a2fpga/a2fpga_core/boards/a2p25/README.md

# A2P25 Card

This is the project version that builds the FPGA bitstream for the 
[Tang Primer 25K](https://wiki.sipeed.com/hardware/en/tang/tang-primer-25k/primer-25k.html)
version of the A2FPGA Apple II card.

Coming soon

## Documentation

- [Project documentation wiki](../../docs/README.md) — Gowin CLI setup, architecture, conventions, gotchas
- [Agent & contributor guide](../../AGENTS.md)
- [This board's tasks & status (TODO.md)](TODO.md)
- Board design docs:
  - [LCAM capture session notes](docs/LCAM_SESSION_NOTES.md)
  - [ESP32 SPI protocol](docs/ESP32_SPI_PROTOCOL.md)
  - [ESP32 firmware (a2fpga_esp32)](src/a2fpga_esp32/README.md)
