a2fpga/a2fpga_core/boards/a2mega/TODO.md

# A2Mega TODO

## Status

**Work In Progress** — Tang Mega 60K version. The a2n20v2-Enhanced feature set
(menu, SD disk serving, WiFi networking, FPGA self-update) is ported and
building; hardware bring-up of the new co-processor paths is next. See
[docs/ESP32_ENHANCED_PORT.md](docs/ESP32_ENHANCED_PORT.md).

## High Priority — bring-up of the Enhanced port (all code in place, untested on hardware)

- [ ] Verify the OSPI link end-to-end from the ESP32 (`+++` CLI: `spitest`, `spireg 7`)
- [ ] Verify SD card pins (`PIN_SD_D2`=IO35 inferred from schematic) and 4-bit SDMMC mount
- [ ] Verify USB HID gamepad readback regs (0x16-0x1B) and menu navigation
- [ ] Verify OSD text overlay rendering (`A2REG_VIDEO_ENABLE`, SPACE 1 writes;
      check glyph bit order — flip `row_byte_r[subcnt_r[3:1]]` indexing if mirrored)
- [ ] Verify Disk II track serving (SPACE 4 windows) and HDD block serving (SPACE 5)
- [ ] Verify Apple II reset hold/release polarity through the 74LVC2G06 (a2_res_out_n)
- [ ] Verify W5100 MACRAW bridge + WiFi MAC NAT against IP65/Contiki
- [ ] Verify GW5A JTAG self-update path (IDCODE probe first — reg constants
      mirrored from openFPGALoader's GW5A support, not yet run on silicon)
- [x] DDR3 reset sequencer + calibration watchdog (79f4afc1): rst_n was
      tied high (one unsequenced calibration shot, no retry — the
      intermittent dead-DDR3 cold boots). Sequencer holds reset through
      PLL lock + 1 ms, 100 ms watchdog retries indefinitely; retries in
      reg 0x23, state in 0x24; boot warning + `status` line in firmware.
      ⚠️ any a2spi_* call outside the CLI/tasks MUST hold fpga_link_lock()
      and ideally run before task creation — unlocked boot-path reads
      boot-looped the ESP32 (IDF spi_device_transmit assert).
- [x] Wire the DDR3 IP's pll_stop via mDRP (a302d566): WAS the root cause
      of marginal calibration (IPUG281 §4.4.4 — Sync_mod must stop
      memory_clk to phase-align the /4 dividers; ours was a silent no-op,
      cold boots aligned by GSR luck). Raw PLLA wrapper (PLL_INIT was IDE
      boilerplate that permanently owned the mDRP bus), refdesign glue,
      pll_mDRP_intf enabled. Verified: forced re-inits (reg 0x25 write)
      converge back to calibrated, 0-1 watchdog retries each — re-init
      was guaranteed-fail before this.
- [ ] Track DDR3 retry counter during testing; correlate nonzero counts
      with gamepad presence/rumble (user's supply-sag hypothesis).

## Bring-up status (2026-07-05 live IIgs session)

**WORKING on real hardware**: FPGA core (REG-mode DDR3 calibrates, video
clean), OSPI link (at 2 MHz + workarounds below), OSD console rendering,
SD disk serving — **ProDOS 8 boots from a .dsk over the link**, WiFi
joins + DHCP, boot-time slot config, reset policy.

**Gamepad + menu (2026-07-12, commit aa897c81)**: 8BitDo SN30 Pro
enumerates on the fabric usb_hid_host, input reports stream, menu
navigates via pad, rumble/LED init lands. Four stacked root causes fixed
(empty $readmemh microcode ROM → inlined .vh; D+/D− pin swap vs the dock
reference — carrier truth is D+=G13/D−=H13 per sch p.3+p.5; SLEW_RATE=
SLOW corrupted the 12 Mbps TX; SN30 needs the Enhanced-proven init
sequence with LED/rumble on EP1 OUT, now in the UKP ROM — source
vendored at hdl/usb_hid_host/ukp.s, regen: `python3 asukp.py ukp.s`).
NOTE: HID SET_IDLE/SET_PROTOCOL/report-descriptor path deleted from the
microcode for ROM space — USB keyboards/mice unsupported on this port
until re-slimmed. USB debug regs (permanent): 0x79/0x7B line-state +
UKP PC, 0x1C-0x1F + 0x7C-0x7D enum VID/PID/class, 0x20-0x22 core flags
+ transaction/data counters.
OSD repaint glitch FIXED (58ac8201): console scroll-on-newline ate the
title bar when the menu painted a full-width bottom row; fpga_screen now
does VT100-style deferred wrap.

Fixed later the same day (commit 3ed97d1): proto-proc stale-read + OSPI
sync-skew flashed (link clean at 4 MHz, shim removed), CLI mutexed,
fpgaupdate takes .bin, flash.sh hardened (--verify/retries/procedure).

Open issues, in priority order:

- [ ] SHR VERDICT (2026-07-10 live session, Spy Hunter static splash
      clean and stable): the SHR garble was vgc_gen's never-stall word
      swap — a semantic change imported with the a2n20v2 direct_display
      redesign — emitting STALE words when DDR3 fetches missed the
      16-pixel window and phase-slipping the rest of the line. FIXED:
      stall-on-late-word restored (active low during the stall; the
      framebuffer_writer pauses cleanly; BSRAM boards never stall), plus
      a vgc next-group prefetch in apple_memory (odd-word arming) and a
      pipelined issue path for clk_logic timing. REMAINING: stalls/frame
      still saturate 255 during SHR (prefetch mostly not winning —
      investigate pf idle-slot availability vs vid dummy churn);
      invisible now but margin-reducing. MOTION-SHR untested (needs
      menu/gamepad to mount GS game images — the standing gate)
- [ ] WiFi 2x2 VERDICT (2026-07-11, test router "edhomelab" @-33):
      RX-takeover EXONERATED (on/off statistically identical — W5100
      bridge re-enabled at no cost). Clean AP eliminates ALL loss
      (0% every bucket; UniFi near AP adds real loss+latency on top —
      user to investigate that AP separately). Residual: ~150-280ms
      mean RTT / ~12KB/s FTP in the common mode, with a PROVEN 3-9ms
      mode (sustained once; floors of 2.6-6ms seen daily) — bistable
      radio/driver behavior surviving elimination of takeover, IIgs
      power, disk/menu workload, PS, rates. Next tools: monitor-mode
      channel sniffer, in-firmware RTT profiling, audit w5100_poll's
      continuous OSPI duty (not covered by wifitest quiesce).
      Acceptable for current uses (disk serving OSPI-side; FTP works).
- [ ] (superseded) WiFi INVESTIGATION (2026-07-11 — verdict RETRACTED
      twice, now confounded): the "RF path" conclusion was premature.
      One PRISTINE measurement exists: 9ms avg / 0% loss sustained,
      with the RX-takeover DISABLED via the FAR UniFi AP (RSSI -83!) —
      proving the module can do healthy WiFi. But takeover-off via the
      NEAR AP (-46) was sick again (~600-900ms), so the takeover A/B is
      confounded with AP selection: every bad measurement is consistent
      with the NEAR AP being the disease. NEXT: dedicated non-UniFi
      2.4GHz test router placed next to the ESP32 (arriving 2026-07-11)
      → run the 2x2: {takeover on/off} x {test router} to separate our
      wifi_bridge RX-callback takeover from AP-side pathology.
      CURRENT BUILD STATE: takeover DISABLED (diagnostic) — W5100/
      Uthernet bridge is INERT until this resolves; FTP/net services
      unaffected. The a2p25 streamed 128kbps via stock Arduino WiFi on
      a similar board — whichever way the 2x2 lands, that path exists.
- [ ] (retracted) WiFi VERDICT (2026-07-10 session close): the pathology follows the
      BOARD, not the network — identical/worse on edhome, edhome-iot-3
      (all toggles stock), AND an iPhone hotspot (87-100% loss). With
      every client knob and AP setting eliminated, the remaining cause
      is the a2mega's RF path: the ESP32-S3-MINI PCB antenna in its
      board environment sustains management-rate traffic (association
      looks "excellent") but not data conversation. HW mitigations to
      evaluate: ESP32-S3-MINI-1U variant (U.FL external antenna) on a
      board rev; module placement/keepout audit vs the OSPI bus and
      slot copper; accept as-is for low-rate uses (disk serving works;
      FTP is slow but functional at close range/good moments).
      Note: the W5100-over-WiFi bridge shares this ceiling.
- [ ] (superseded ledger) WiFi performance (extensively characterized —
      CLI instruments: net/wifitest/wifiproto + rx/disconnect counters):
      bimodal fly-or-wait latency — RTT floor 3-11ms proves the path,
      but most packets wait 0.5-2.5s; ~10% loss; ~2.7KB/s FTP.
      ELIMINATED: power save (PS_NONE confirmed via readback — fixing it
      cured the original 100% inbound loss), 802.11n/MCS rates (bg-only
      identical), client 11k/v scanning (disabled in core), guest/
      isolation, DTIM lock + force-WiFi4 (reverted), dual-interface
      artifact, board workload (quiesce = 2x better, not the core),
      IIgs RFI (off = same). REMAINING: channel-6 lock (last user
      toggle — revert to auto), 2.4GHz channel utilization at the AP
      (read UniFi's metric), AP-side buffering toward this client,
      SSID/VLAN mapping of edhome-iot-3 (wired-path blackhole was
      observed transiently — verify network assignment), or return to
      edhome with band steering off as clean baseline
- [x] FLASH REPAIRED (2026-07-10): root cause of all flash-write failures
      was openFPGALoader's flash phase defaulting to 10 MHz through the
      ESP32 JTAG bridge — 500 kHz works. Recovery recipe in docs/gotchas.md
      (`--freq 500000 --bulk-erase`, replug, normal flash.sh). Board boots
      from flash again; power cycles safe
- [ ] Bit-bang GW5A SPI-flash path (fpgaupdate/fpgaflash/fpgaerase CLI)
      not silicon-validated: SPI status reads return busy/0xFF in both
      normal and keepsram entry modes — debug against openFPGALoader's
      working 500 kHz sequence before trusting the menu FPGA-update flow
- [ ] (was) FLASH REPAIR PENDING: config flash holds a half-written image
      (interrupted openFPGALoader write); board runs from SRAM — power
      loss needs a re-SRAM-load. openFPGALoader writes lose to the
      config-retry loop; repair via ESP32 bit-bang fpgaupdate (menu) or
      SRAM-load-then-flash in a fresh power window
- [ ] Old "sparkle"/garble notes (superseded by the above): (2026-07-10 live session):
      apple_video_gen and vgc_gen are hard-real-time single-word-prefetch
      consumers; a shadow read that misses its ~500ns slot makes the pixel
      shifter reuse the PREVIOUS word (stale chunk). Occasional misses =
      moving misplaced pixels on static screens (worst during disk-load
      write streams); chronic misses (2 clients on one port during SHR) =
      wholesale shape garble. No counter fires — data is correct, merely
      late. FIX SHIPPED: shadow read to priority 0 (latency-critical; all
      other clients are FIFO/line-buffered), shadow write to 1, FB 2/3;
      hidden-renderer fetches complete immediately with dummy data during
      SHR (wedge-safe, zero port traffic). RESIDUAL RISK: DRAM auto-refresh
      (~350ns per 7.8us) + in-flight FB burst can still exceed the word
      budget at low rate — if sparkle persists, deepen renderer prefetch
      to 2 words (measure via viddbg + photos first)
- [ ] Display sticks in SHR after the TransWarp GS power-up splash (reset
      recovers) — ROOT CAUSE from main PR #46 (hardware-validated on a
      IIgs+TWGS): read-FSM swallowed fetch pulses (vgc_active_i gating +
      busy-FSM drops with both generators fetching), wedging a generator
      until reset; the shared framebuffer then freezes on the splash.
      FIX PORTED: per-client request latches, classify by client+latched
      address, a request once latched always completes. VERIFY on hw;
      `viddbg` regs 0x70-0x77 confirm (C029 count, SHRG/use_vgc, rd FSM)
- [ ] Cold-boot polish from PR #46 worth porting later: seed the shadow
      text page with 0xA0 at first reset release (DDR3 noise until the
      ROM clears it; OSD console masks it today), and require two writer
      vsyncs before unblanking the FB after reset release
- [ ] SHR and hires rendering scrambled (text clean → scanout OK).
      HIRES root cause FOUND + FIXED: format_hires_data assembled
      {main,aux,main,aux} but the shared apple_video_gen contract is
      interleave_mux = {aux,MAIN,aux,MAIN} — every hires fetch fed the
      renderer aux-bank bytes (stable scramble, matches symptom). SHR
      mapping verified byte-identical to the working GS board; if SHR is
      still scrambled after the fix, suspect m2b0/E1 write routing or
      LINEARIZE-vs-write ordering — read `viddbg` stickies live
- [ ] XFER payload reads outrun the proto's 1-byte read pipeline above
      ~4 MHz (FF fill; reg path is clean at 8 MHz) — add a small
      fabric-side read prefetch to raise the link clock
- [ ] Runtime slot remapping breaks the moved card's I/O (boot-time map
      works; after SLOT_SELECT/CARD/RECONFIG the card's ROM reads work
      but the drive never serves data — repro: remap DiskII to slot 4/6,
      PR#n hangs with motor on, zero sectors)
- [ ] DOS 3.3 master image (dos_3.3.dsk) crashes deterministically at
      00/1FBA with RAMRD/ALTZP flipped in Q — ProDOS boots fine, track
      content verified byte-identical to reference GCR, sector 0 + 7 more
      sectors load correctly; likely image/IIgs interplay (try
      dos33_fixed.dsk); park unless it reproduces with known-good images
- [ ] SD 4-bit mount fails ("corrupted data after increasing clock
      frequency"), 1-bit works — audit PIN_SD_D1/D2/D3 against the board
      (D2=IO35 was inferred, not confirmed)
- [ ] SD mount is boot-time-only — retry on card-detect (IO46)
- [ ] Arduino/IDF logging: ESP_LOGI is compiled out by the precompiled
      core — use printf (or Serial) for anything that must be visible
- [ ] Restore the per-track serve-log dedup in disk.c once boot serving
      is settled (currently logs every serve for bring-up)

## DDR3 / BSRAM roadmap (from the 2026-07 fresh-eyes review)

Done: DDR3 controller MC buffers → registers (BSRAM 118→102); wrap-safe
hdmi_cy CDC; reset-deassert synchronizers; response-FIFO overflow guard;
burst-alignment assert. Open, in recommended order:

- [ ] Bench-verify the REG-mode controller + CDC hardening with the TEXT40
      soak test (the rippling-band reproducer) — required before trusting
      any of the DDR3-path changes
- [ ] C4: round-robin arbitration below the two framebuffer ports — the
      static-priority arbiter has no fairness bound for ports 2-5; this is
      the gate for adding ANY new DDR3 client
- [ ] DOC-on-ESP32 over the PPO bus (see the a2p25 postmortem): FPGA
      timestamps every $C03C-$C03F snoop against a 7M-locked counter and
      streams events over the idle PPO lines (LCD_CAM-shaped, 8 data +
      PCLK + SYNC); ESP32 runs the ES5503 model in DOC cycles. Frees ~28
      BSRAMs net. Make-or-break: event-loss hardening (FPGA event FIFO,
      seq+CRC, OSPI credit flow control, snooped-read-data resync).
      Fallback if it stalls: DOC-side prefetch converts the 838 ns fetch
      deadline to ~30 us, which DDR3 meets — wavetable to DDR3 without
      touching the DOC engine's real-time core
- [ ] Disk track windows → DDR3 after C4 lands (−6 BSRAM net of CDC cost;
      nibble cadence is ~32 us, hugely latency-tolerant)
- [ ] Uthernet II buffer aliasing (−3…−6) — first verify what RMSR/TMSR
      splits IP65/Contiki-class MACRAW drivers actually program

## Medium Priority

- [ ] Wire MCU scratch regs (0x06, 0x0C-0x0F) to DebugOverlay slots for bring-up
- [ ] Bluetooth HID gamepads/keyboards via the ESP32 (feed the same pad regs)
- [ ] Keyboard passthrough (FPGA usb_hid_host key regs → Apple II keyboard)
- [ ] Enable configuration through a web-based UX (ESP32 WiFi) alongside the OSD
- [ ] Investigate using the PPO interface to treat the FPGA as an LCD display
- [ ] Investigate implementing IIgs acceleration (similar to Transwarp GS)

## Low Priority / Future

- [ ] ESP32 firmware OTA update from the SD card
- [ ] Gamepad → Apple II paddle/joystick emulation (not in Enhanced either)

## Architecture Notes

- Uses ESP32-S3-MINI-1-N8 for control/configuration instead of internal PicoSoC
- OSPI (8-bit parallel) interface between ESP32 and FPGA — register map in
  [docs/ESP32_OSPI_DESIGN.md](docs/ESP32_OSPI_DESIGN.md), Enhanced-port additions in
  [docs/ESP32_ENHANCED_PORT.md](docs/ESP32_ENHANCED_PORT.md)
- USB-A port is wired to the FPGA (usb_hid_host core), not the ESP32;
  micro-SD, WiFi, and JTAG-to-FPGA are on the ESP32
- Disk track/HDD block buffers are BSRAM (XFER SPACE 4/5), not DDR3
- ⚠️ **BSRAM is at the device limit.** New BSRAM consumers must reclaim first.
  The Ensoniq 64KB wavetable (32 BSRAMs) is NOT trivially movable to DDR3 —
  the DOC's ~838 ns per-fetch deadline loses to DDR3 tail latency (that's why
  it's in BSRAM). Candidate reclaims: Uthernet II buffer aliasing (−3…−6,
  verify driver RMSR/TMSR use first); DOC arbiter-priority preemption is an
  unproven research option

## Build Status

- FPGA + ESP32 firmware (arduino-cli) both build from this tree; see git log
