a2fpga/a2fpga_core/boards/a2n20v1/TODO.md

# A2N20v1 TODO

## Status

**Deprecated** - This board support package is provided for reference purposes. It should continue to build but is planned for retirement.

## Maintenance Tasks

- [ ] Keep in sync with critical bug fixes from a2n20v2
- [ ] Verify build still works when making shared HDL changes
- [ ] Consider archiving if no active users remain

## Limitations

- Does NOT support Apple IIgs (64-pin CPLD cannot capture M2SEL/M2B0 signals)
- Only supports Apple II and //e models
- Superseded by a2n20v2 which uses 100-pin CPLD

## Build Status

- Last verified build: Unknown
- Recommend verifying build after shared HDL changes
