a2fpga/a2fpga_core/boards/a2n9/TODO.md

# A2N9 TODO

## Status

**Deprecated** - This board support package is provided for reference purposes. It should continue to build but is planned for retirement.

## Maintenance Tasks

- [ ] Keep in sync with critical bug fixes from other boards
- [ ] Verify build still works when making shared HDL changes
- [ ] Consider archiving if no active users remain

## Limitations

- Does NOT support Apple IIgs
- Only supports Apple II and //e models
- Uses discrete 74* series logic for bus interface (vs CPLD in other versions)
- Tang Nano 9K has limited resources compared to 20K

## Build Status

- Last verified build: Unknown
- Recommend verifying build after shared HDL changes
