a2fpga/a2fpga_core/(threads)

Thread 9 (2024-04-28):

CPLD

DFL1973, 2024-04-28:
Is the CPLD code available?

buserror, 2024-04-28:
No, I asked on slack. No board or CPLD, so this is basically a closed source project, it's a shame really. I don't see why anyone would contribute PR's to a project like this, unless perhaps they get a share of the profits from selling cards? Dunno, not sure what was the point.
When you see the insane communities and drive behind projects like PiStorm or Fujinet, makes you wonder.

edanuff, 2024-04-28:
Hi folks, the A2FPGA core is fully open source and it's easy to use it with boards of your own design.  If you look in the [A2N9 board code](https://github.com/a2fpga/a2fpga_core/tree/main/boards/a2n9), you can see a build of A2FPGA that doesn't depend on the CPLD at all as well as the schematics for the A2N9 board.  The A2N20 board is not open source, so it's not possible at this time for people to manufacture that card themselves but if someone wanted to do the work, they could very easily either use the A2N9 code and schematics as a starting point or use the A2N20 schematics and write their own CPLD code.  The CPLD is fairly trivial in what it does.

For example, here's a picture of development where it's all running on a breadboard with no CPLD at all, just using the code in this repo:

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

Closed 2024-05-01.

Thread 10 (2024-05-01):

DMA/INT OUT/IN

marketideas, 2024-05-01:
Looking at the schematic, it doesn't look like DMA_OUT is tied to DMA_IN and same for INT_IN/OUT.  This breaks the rudimentary daisy chain if the card is put in any slot except slot 7.  Is there a design reason, and perhaps this should be documented so that folks know that any card(s) in higher slots may not work reliably with DMA and/or interupts.

edanuff, 2024-05-01:
Hello, that's correct, the current boards don't support daisy chaining. We'll be documenting this and adding it to a later revision.

Closed 2024-05-01.

Thread 11 (2024-06-02):

mb-audit

DFL1973, 2024-06-02:
Is the emulated mockingboard passing on the mb-audit tests?
https://github.com/tomcw/mb-audit

jewettg, 2024-11-30:
I updated my A2N20 with the latest release:  `a2n20v2-10-12-2024-MB4.fs`.  Here is the successful output from the reprogramming.    I then ran the latest undead from disk image, and it would not detect the Mockingboard.   Is there something else I need to do?

Is there a good way to test MB functionality?  Debug methods?   I am going to see if I can find other disk images to help me test or see if this is working outside of Undead.

```
❯ openfpgaloader -b tangnano20k -f a2n20v2-10-12-2024-MB4.fs
empty
write to flash
Jtag frequency : requested 6.00MHz   -> real 6.00MHz
Parse file Parse a2n20v2-10-12-2024-MB4.fs:
Done
DONE
after program flash: displayReadReg 00006020
	Memory Erase
	Done Final
	Security Final
Erase SRAM DONE
Jtag probe limited to %d MHz6000000
Jtag frequency : requested 10.00MHz  -> real 6.00MHz
Detected: Winbond W25Q64 128 sectors size: 64Mb
Detected: Winbond W25Q64 128 sectors size: 64Mb
RDSR : 00
WIP  : 0
WEL  : 0
BP   : 0
TB   : 0
SRWD : 0
00000000 00000000 00000000 00
Erasing: [==================================================] 100.00%
Done
Writing: [==================================================] 100.00%
Done
```

edanuff, 2024-12-01:
The mockingboard does not currently pass mbaudit tests.  We're still working on figuring out why.

jewettg, 2024-12-01:
**I do want to apologize.**  After reading more documentation, I found I had to disable the mouse support (by marking slot 4 as "Your Card") on the Apple //gs.   All is well and Mocking board is detected and working!  It was even detected and working with other software as well!

edanuff, 2024-12-11:
#22

jewettg, 2024-12-12:
AWESOME!!   Thank you!   Will try it out soon!

edanuff, 2024-12-12:
There will be a new release this weekend

Closed 2024-12-11.

Thread 12 (2024-06-28):

Mouse

SalvadorCastello, 2024-06-28:
Do you think you can add Mouse support to the firmware?
To act as an Apple Mouse card, those cards are difficult to find.

Thanks

edanuff, 2024-08-30:
Not on the current version of the card since the USB port is device only for connecting to a PC.  We intend to do a future version that has a second USB host port that could be used for a mouse.

JustDre, 2024-08-30:
Although I haven't tried this just yet, there is a project by the author of snestang that allows the USB port to act as a host https://github.com/nand2mario/usb_hid_host

edanuff, 2024-08-30:
Yes, going to use something similar. The current board design has all the physical pins assigned right now although there are some workarounds for that.

Closed 2024-08-30.

Thread 25 (2025-05-02):

Hires graphics with 80 col active bot woriing

samccormack, 2025-05-02:
If hires graphics mode is activated while in 80 column mode the card gets confused and dispkays corrupted 40 column text characters in the graphics area. I have reproduced this on my rom 1 and rom 3 apple iigs machines. Exiting 80 column mode makes the graphics appear correctly.

To reproduce simply go into 80 column mode with pr#3 then enter hires graphics mode with hgr and the graphics area of the screen will fill with 40 column @ characters. Toggle back into 40 column mode either with ESC 4 or ESC CTRL-Q and the graphics will display correctly.

edanuff, 2025-05-02:
Let me take a look

Thread 26 (2025-06-12):

Graphic and character artifacts with A2FPGA

notwork-2000, 2025-06-12:
I get random characters or graphics that show up with the A2FPGA, that has the Video Only firmware on my Apple IIgs Rom1.  Could be extra characters on the boot screen, or artifacts in a game.  Only when going out HDMI from the A2FPGA.  RGB or Composite out do have have these artifacts.

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

notwork-2000, 2025-06-12:
A2FPGA in Slot 3, no boards in slots 1,2,4,5,6,7.  RAM2GS II (GW4201D) in the memory slot.  Fujinet plugged into Smartport.
A2FPGA Switch 1-4 are all on.
System configuration/slot configuration is defaults.
Thank you!

marketideas, 2025-07-12:
I rolled back to A2N20V2-FIRMWARE-08-17-2024_VIDEO_ONLY, and the problem has gone away (same machine, same hardware, etc).  So I won't spend my time looking into hardware issues, but will start comparing new releases to the old, and see if the clock routing has changed.

notwork-2000, 2025-07-12:
Thank you for adding insight into this.

Guess I now wish I hadn't gave up and returned the card as I was told it couldn't be reproduced and it was a local issue (was told power supply, home power quality, etc, I could tell it wasn't going to be an easy road to a solution).

Looks like I could have tried simply downgrading the firmware.  Didn't think to do that, all I tried firmware wise was reflash the same latest version with video only.  I assumed it was a firmware issue and offered to debug and troubleshoot.  Oh well.

Am actually quite happy with an RGB SCART cable to an RT4K, and don't miss the boot delay and as a bonus even get to hear the IIGS boot sound.

Finally, it's probably safe to assume this wouldn't solve my other issue where it would not work reliably through a TESmart 16x1 HDMI switch, where so many other devices I have work fine.

Live and learn.

jnorrid, 2025-07-12:
> I haven't been using my A2FPGA for awhile, but with Ensonic over HDMI support, I thought I might get back to it. Updated firmware to the 'enhanced' version, and started seeing 80-col random characters all over the screen. I don't have photos yet, as I continue to investigate. I have tried several different things, built my own bitstream, used the canned bitstreams, all doing the same thing. This is a ROM1 with the A2FPGA in slot 3. I have a ROM3 motherboard that I am going to try next. My gut is that the M2B0 signal is either weak (drive strength/voltage), there is a timing issue (a compile issues a warning about the clk_d signal, or the GLU CPLD is blown somehow...logic analyzer next. Let's keep this closed for now, and as I gain more info, we can see if we can't figure it out...but it looks like the same issue as the OP.

Greetings marketideas. The enhanced source tree and build contained in the repo is currently experimental at this stage. We have been working on it quite a bit lately and definitely encourage testing, but it is not a "production" build yet. The default configuration in the Top.sv file for this build enables all of the adapter cards currently implemented for a2fpga. SSC in slot 2, Mockingboard in Slot 4, Synetix SuperSprite in Slot 7 in addition to the HD video output, Apple II audio output, and Ensoniq audio output over HDMI for GS users. We were unable to reproduce the problem reported by the OP of this thread on any of our GS systems or the separate problem reported by the OP regarding use of TESmart 16x1 switch (we do not have one of these switches, and it is impossible to support every possible piece of equipment that could possibly reside between the A2FPGA and a display device, however, we have successfully tested with a 16-Port MT-VIKI 16 port 4K HDMI KVM purchased on Amazon in the US with no issues).

**We believe what you have reported above is most likely a completely unrelated problem than that reported by the OP.** Typically, the problems we have seen GS users encounter are related to power supplies delivering insufficient or inconsistent voltage/current due to age/use, card configuration conflict where physical boards reside in slots used by A2FPGA to implement SSC, MB, SuperSprite, or incorrect / misaligned configuration settings in the Apple II GS control panel for a user's configuration. Would really like to help you get to the bottom of this or figure out how we might be able to successfully reproduce the problem you are running into on our end. To help facilitate this, could you please answer / provide the following:

1. On your ROM 01 GS, what is the slot by slot configuration and Apple II GS control panel setting for each slot?
2. Have you upgraded/enhanced your Apple II GS power supply or is it the original equipment?
3. If you have any photos of the 80-col random characters on the screen, could you please provide those?
4.  When producing your custom firmware build using the enhanced source, did you modify the Top.sv file and disable anything that could potentially conflict with your configuration prior to executing a Build-All and programming the Tang-20K FPGA with the Gowin toolchain?

Thanks!

marketideas, 2025-07-12:
I'll try to answer these questions by going through the steps that got me here.
1) Downloaded, the latest main repo.
2) downloaded the 'official' build of the enhanced bitstream.  Programmed that to the board.
3) First boot noticed the artifacts. Tried several times.
4) Brought up GoWin IDE, loaded the project and built (default options in top.v)
5) Burned that, same thing.
6) Modified top.v to just do video only, no cards.  Built, burned, tested.
7) Decided 'It's experimental', so lets see what the non-enhanced does.
8) downloaded the main branch of the 'non enhanced' bit stream (a2n20v2)
9) burned that..same issue.
10) then tried the VIDEO_ONLY version, same problem.
11) created my own VIDEO_ONLY version by changing top.v to disable all cards (I did enable the HDMI debug line)
12) built, burned, same thing.
13) came to github to see if anyone else had experienced anything.  1 post in 'open', similar, but not exact. Then checked 'closed' and found this issue.
14) added my two cents here.
15) downloaded the old 8/24 version of a2n20vs, burned, tested, everything looks great.
16) built my own 8/24 version (had to add IO_PORT definitions for voltages to "clk", "s1" and "s2" to get passed voltage errors in gowin 1.09.11.02 (professional)
17) once that was fixed, built, burned, tested...works nicely.

My power supply is an UltimateApple2 (I believe from reactive), maybe 2 years old...but not powered on much.  No cards, other than a Garrett's workshop 8M RAM2GSII, all slot settings are set to defaults (your card on slot 7 which is empty, but that is the default)

Next time I have a 'broken' build installed, I'll take a couple of photos or videos.  Happens on 40col/80col and in GS/OS hires (almost always on 80col, randomly on 40col, and I have only seen once on hires.

IO_LOC "clk" 4;
IO_PORT "clk" IO_TYPE=LVCMOS33 PULL_MODE=NONE;

//IO_LOC "clk_1" 10;
//IO_LOC "clk_2" 11;
//IO_LOC "clk_3" 13;

IO_LOC "s1" 88;
IO_PORT "s1" IO_TYPE=LVCMOS33 PULL_MODE=NONE;

IO_LOC "s2" 87;
IO_PORT "s2" IO_TYPE=LVCMOS33 PULL_MODE=NONE;

notwork-2000, 2025-07-12:
I have the same 8mb ram2gs card, same rom01 IIGS.  I bet if I still had the card and loaded the 0824 firmware, it would solve the issue for me.  Happy to test if you are interested.  It's not my power supply, or dirty slots, or the power in my house.  Next I was expecting to hear it was sun spots.

edanuff, 2025-07-13:
@marketideas thanks for the testing, that's very interesting. I assume it worked fine before you flashed the new version and then only had issues when you tried the enhanced release?  When did you originally receive your card?  Also, did the 8/24 regular version work fine or just the VIDEO_ONLY version?

@notwork-2000 understand your skepticism on power-related issues.  the only thing we know for sure is that it's machine-specific.  We've seen about 5 instances of this problem and every time, the boards worked fine on our test machines when returned and the exchanges that were sent out didn't work.  In a few cases, people did try older versions but I'm not sure whether anyone tried rolling back to the 8/28 release.  Let's see if it stays fixed for @marketideas and if so, happy to have you test as well.  The reason why power issues are suspect is because it doesn't take the power supply being that far out of spec to potentially cause these issues but we've never been able to reproduce so it's just speculation.

marketideas, 2025-07-13:
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aaa

Sorry, the above is blurry, but this is output direct from my GS to a VGA monitor.  Blue background, no artifacts.

Same display, but shown over HDMI using A2FPGA.  Notice black background, and $ signs and < characters.

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

Then, here is a 40 column display with no disk drives attached

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

marketideas, 2025-07-13:
All versions of 08/24 work fine, including the 'Release' version in the package.
I am also starting to believe that the open issue here on github is also related...a bad byte could be interpreted as 'fill to end' in SHIRES.
One thing I did also notice, but am unable to capture in a photo, is that notwork's photo of his 'Apple IIgs' copy write screen, he has the little back-tick character in the upper left.  I get that same character in the same position as well.

Also, I pulled my GSRAM out, to see if that had any affect. It does not.
Tomorrow, I will try my ROM 3 motherboard and see what happens.  Also sent a PM to Petar to see what his machine config is.

Don't know the timing of when I ordered my card, but it was within a month of them being released.  I think I posted an issue about DMA IN/OUT in November '24.

Is there an easy way to take the latest release, and remove the SRAM stuff and go back to block RAM?  Haven't found that yet.  That would have been a big change, that if we miss a byte or two, would cause the display (or the color register) to not hold a proper value.

For what it is worth, All of the textual 'anomolies' that I have seen have been standard ASCII characters, I get a lot of '8's, '('s, '<' ,'$'. I have never seen a flashing, or inverse character.  It may just be a single bit failing.

Another photo of something I saw.  This is after going into Applesoft (via Prodos8) in 40col mode. Then doing a PR#3.  One photo is my VGA screen direct from GS, the other is the HDMI version.  (Again, black background).

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

We seem to be one message ahead/behind.  I'll study your post on the bus-glitch issue.

edanuff, 2025-07-13:
@marketideas the regular a2n20v2 releases (not the enhanced ones) all use BlockRAM for everything.  It's the enhanced version that uses the SDRAM, because it needs the extra memory for the Ensoniq, etc.  However, even the enhanced version still uses BlockRAM for the SHRG mode since it needs the faster bandwidth.  Anyway, let us know what you find on the ROM 03 machine.

marketideas, 2025-07-13:
I changed the default to 1 because I wanted to know what is was.  I can see that it is Ensonic registers, etc.  I leave it on, so I know if I am running a build I did, or one of the canned-release versions.

Thread 27 (2025-06-12):

A2FPGA not working through TESmart 16port HDMI switch

notwork-2000, 2025-06-12:
The A2FPGA, that has the Video Only firmware on my Apple IIgs Rom1 is not compatible my 16 port TESmart HDMI switch.  No HDMI signal detected.  The A2FPGA has to be connected directly to my TV via HDMI.  https://www.tesmart.com/products/hsw1601-e23

jnorrid, 2025-06-12:
Is this a new TESmart switch that you have recently acquired or one that you know is in good working order for other video sources? Have you tried to use an alternate port on the switch or an alternate HDMI cable by chance? What display device make and model does the switch ultimately connect to for rendering content? Thanks.

notwork-2000, 2025-06-12:
It is a switch I have had for some time.  I have multiple other devices plugged in (Atari 5200 with sophia 2, Atari 800 and 800xl with sophia 2, c64 with HD-64, PCE with TerraOnion SuperSystemHD, PS1 with RetroGEM.  I have tried many different ports.  On occasion, it would sync and work, but that seemed like less then 25% of the time.  Out on the switch goes to an older Sharp LC-80LE844U 1080p LCD TV.  When I plug directly into the same TV, it works and syncs as expected.  I did try different cables, but the sync was so intermittent, I dont know if it was cables or just luck.  I seemed to have the most success with shorter cables, and Ultra High Speed cables.

Thread 28 (2025-07-01):

Current a2fpga Enhanced src will not compile in multiple ways

ppuskari, 2025-07-01:
I've been trying to get some traction for a whle and no replies to email or through RM when he tried (Thanks Henry!)

My current quest is to get the GS sound glu and doc5503 working on the Enhanced code tree.

It simply will not work with the combination of compiling from that source in GoWin from the correct enhanced project file with the current git repo.  I got it to compile by changing some references that said a2fpga versus a2video or something like that which the picosoc build needed to compile.

I get clean builds now, but after copying the .bin to the sd card it says it finds and loads the file but just hangs video.  the GS seems to be alive on the ntsc composite and rgb side however...

hdmi audio for the ensoniq simply isn't functional yet even though the enable and include define is setup in the source code.

Has this part been functional at all yet?  I would love to participate and help a LOT on this project but admittedly I'm still learning Verilog but that's coming along nicely.

My next try is to just fork the enhance code bit and then just strip everything down to JUST the hdmi video out and system beep audio over hdmi.  Then start back by including the setups for the sound glu and ensoniq maps.

I'm open to suggestions and even being told, hey stupid this is what you need to do to get a working build that includes the GS Audio  :)

Thanks,

Petar Puskarich
ppuskari @ hotmail.com

edanuff, 2025-07-02:
Hi Petar, I've got Ensoniq support working in my fork of the code which you can either hit directly at https://github.com/edanuff/a2fpga_core or wait till I merge it into the main repository.  Just use the a2n20v2_enhanced.gprj project in boards/a2n20v2-Enhanced/

edanuff, 2025-07-07:
I've merged the changes from my fork into the Enhanced version in this repo, so it now has the working Ensoniq implementation in a2n20v2_enhanced and should build without problem.

ppuskari, 2025-07-07:
Would you like any for me to submit a documentation merge request with the additional information to complete the cross compile of the 65c02 code and the other format bits?  I did finally figure out how to modify the .s file to work with the latest release of merlin32.  Plus building the firmware and other hex file then copy it almover from my Linux machine to the windows machine with gowin on it it deploy.

I’m also looking into a few bits of the model itself.   Some feature seem to not be reacting just right like in the FTA Christmas demo where bullwinkle moose is shot the gunshot sound is a hum.  So something they did might not be getting implemented fully.

But most players and effects are solid.  Excellent work!    I have an audio extractor on its way so I can push it over spdif or toslink to my audio gear in digital form.   I’m also curious if the newer 4k models extractor and splitters can sync down to 480p.  They might not work at all.

The audio as is is so clean!

I am hoping to buy another card this year if RM has the discount code again.

Petar Puskarich

Sent from my iPhone

On Jul 6, 2025, at 7:24 PM, Ed Anuff ***@***.***> wrote:

[https://avatars.githubusercontent.com/u/105246?s=20&v=4]edanuff left a comment (a2fpga/a2fpga_core#28)<https://github.com/a2fpga/a2fpga_core/issues/28#issuecomment-3043173307>

I've merged the changes from my fork into the Enhanced version in this repo, so it now has the working Ensoniq implementation in a2n20v2_enhanced and should build without problem.

—
Reply to this email directly, view it on GitHub<https://github.com/a2fpga/a2fpga_core/issues/28#issuecomment-3043173307>, or unsubscribe<https://github.com/notifications/unsubscribe-auth/AAIMVUBZPSUQNLYQNFOFWBL3HG425AVCNFSM6AAAAACASNAAS6VHI2DSMVQWIX3LMV43OSLTON2WKQ3PNVWWK3TUHMZTANBTGE3TGMZQG4>.
You are receiving this because you authored the thread.Message ID: ***@***.***>

edanuff, 2025-07-08:
- [ ] The current build in a2n20v2_enhanced should just work and should be your starting point since the DOC5503 module was completely  rewritten.  Definitely provide any feedback on sound glitches or improvements as a new GitHub issue.  The debug overlay you saw in my build is now turned off by default but you can get it back by hitting the S2 button on the Tang Nano 20K.  Right now it's showing the oscillator config for the first 8 oscillators.  All the cardrom stuff will get turned back on when the riscv firmware is finished.  That's for disk II to sdcard and slot configuration but not in the path for sound generation.

ppuskari, 2025-07-08:
Absolute amazing work and by seeing what you have done I now have a much better understanding and skeleton for providing other memory redirects etc from the system to provide a few other ideas I think may be possible.

Such a very powerful platform you have going here.  I’ll definitely talk it up after your presentation in a couple weeks.   If that’s okay.

Will def open up a few tickets as I test out various things and see what the apps are doing to the registers and a b compare.

Petar Puskarich

Sent from my iPhone

On Jul 7, 2025, at 8:29 PM, Ed Anuff ***@***.***> wrote:

[https://avatars.githubusercontent.com/u/105246?s=20&v=4]edanuff left a comment (a2fpga/a2fpga_core#28)<https://github.com/a2fpga/a2fpga_core/issues/28#issuecomment-3047052647>

The current build in a2n20v2_enhanced should just work and should be your starting point since the DOC5503 module was completely rewritten. Definitely provide any feedback on sound glitches or improvements as a new GitHub issue. The debug overlay you saw in my build is now turned off by default but you can get it back by hitting the S2 button on the Tang Nano 20K. Right now it's showing the oscillator config for the first 8 oscillators. All the cardrom stuff will get turned back on when the riscv firmware is finished. That's for disk II to sdcard and slot configuration but not in the path for sound generation.

—
Reply to this email directly, view it on GitHub<https://github.com/a2fpga/a2fpga_core/issues/28#issuecomment-3047052647>, or unsubscribe<https://github.com/notifications/unsubscribe-auth/AAIMVUEXSCXFMWQXOE75D533HMNHTAVCNFSM6AAAAACASNAAS6VHI2DSMVQWIX3LMV43OSLTON2WKQ3PNVWWK3TUHMZTANBXGA2TENRUG4>.
You are receiving this because you authored the thread.Message ID: ***@***.***>

Closed 2025-07-14.

Thread 30 (2025-07-07):

apple IIGS  super high graphics

finbad, 2025-07-07:
seems to be an issue with supper high graphics only

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

finbad, 2025-07-08:
hi,  sure,   I have a bunch of super high rez images I like to run through a couple of sliders,   you can see them in folders on the attached HDV disk image ,  I am running a IIGS ROM 03 ,   OS 6.0.4   8 megs of ram.

<!-- Failed to upload "I_CoolStuff.zip" -->

finbad, 2025-07-08:
I_CoolStuff.hdv

edanuff, 2025-07-08:
If you could instead just provide a single app and image that demonstrates the bug on an empty disk.  No .hdv files please.

edanuff, 2025-07-09:
We can in fact track which scanline is being drawn on the Apple side. The complication comes from one of the few places where we have to diverge from the Apple’s original timing: the rate at which we output HDMI video. The A2FPGA’s video scanner mimics the behavior of the Apple II’s, fetching a byte from our mirrored video memory, converting it into color, and outputting it, in our case via HDMI instead of composite. The problem is that the A2FPGA’s video scanner runs at a different pixel clock than the Apple’s, so over time its scanline position drifts relative to the GS’s. This desynchronization breaks beam racing techniques like real-time palette changes or sprite multiplexing that depend on cycle-accurate alignment with the video beam. The best way to fix this is to double-buffer the rendering pipeline: render each frame from video memory into an intermediate framebuffer at Apple timing, then scan that framebuffer out to HDMI at HDMI timing. This would keep everything visually in sync and preserve compatibility with timing-sensitive tricks. I expect that this is what VidHD did. This currently seems a bit tricky to manage in terms of memory bandwidth. It's not out of the question, but a lot of work.

finbad, 2025-07-09:
yes,  but the images converted to computer (they were a new thing for computers) capture the spirit of the time.... I would rather the images. anyway, if a fix is not possible no worries,  I will have to sell my first born for a VidHD.
