a2fpga/a2fpga_core/boards/a2mega/sch/a2-mega.pdf

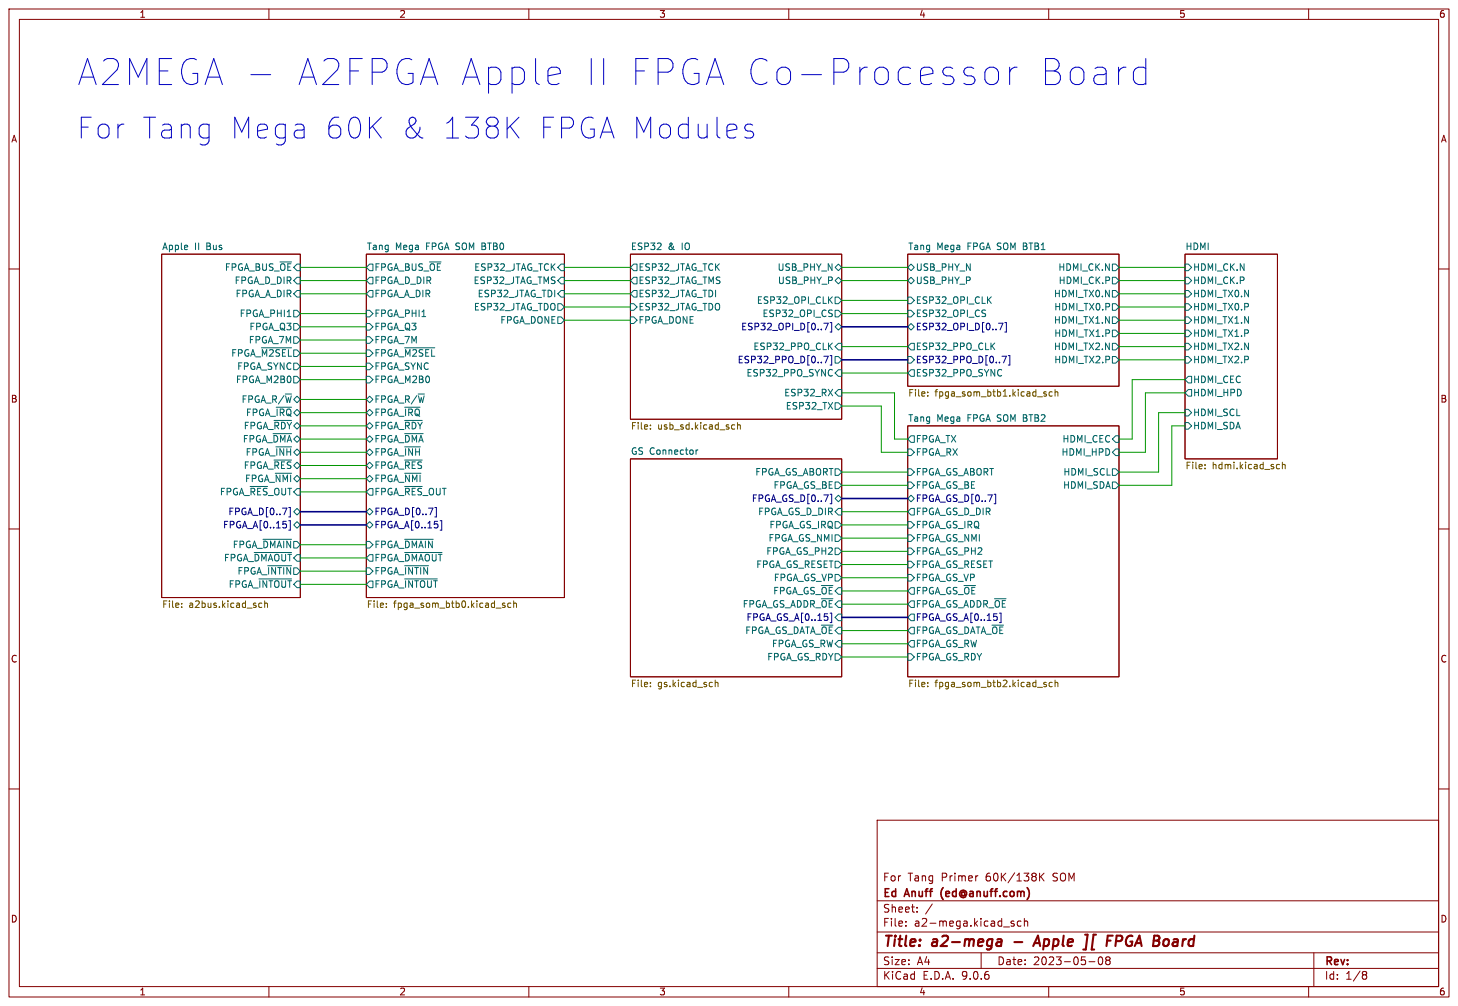
[picture p4: page 1]

For Tang Mega 60K & 138K FPGA Modules
Tang Mega FPGA SOM BTB0 File: fpga_som_btb0.kicad_sch
FPGA_~{DMA} FPGA_D_DIR
FPGA_~{RES} FPGA_A_DIR
FPGA_D[0..7] FPGA_M2B0 FPGA_PHI1 FPGA_Q3 FPGA_R/~{W} FPGA_SYNC
FPGA_Q3 FPGA_~{INH}

HDMI File: hdmi.kicad_sch FPGA_BUS_~{OE} FPGA_A_DIR

Tang Mega FPGA SOM BTB1 File: fpga_som_btb1.kicad_sch USB_PHY_N

Tang Mega FPGA SOM BTB2 File: fpga_som_btb2.kicad_sch

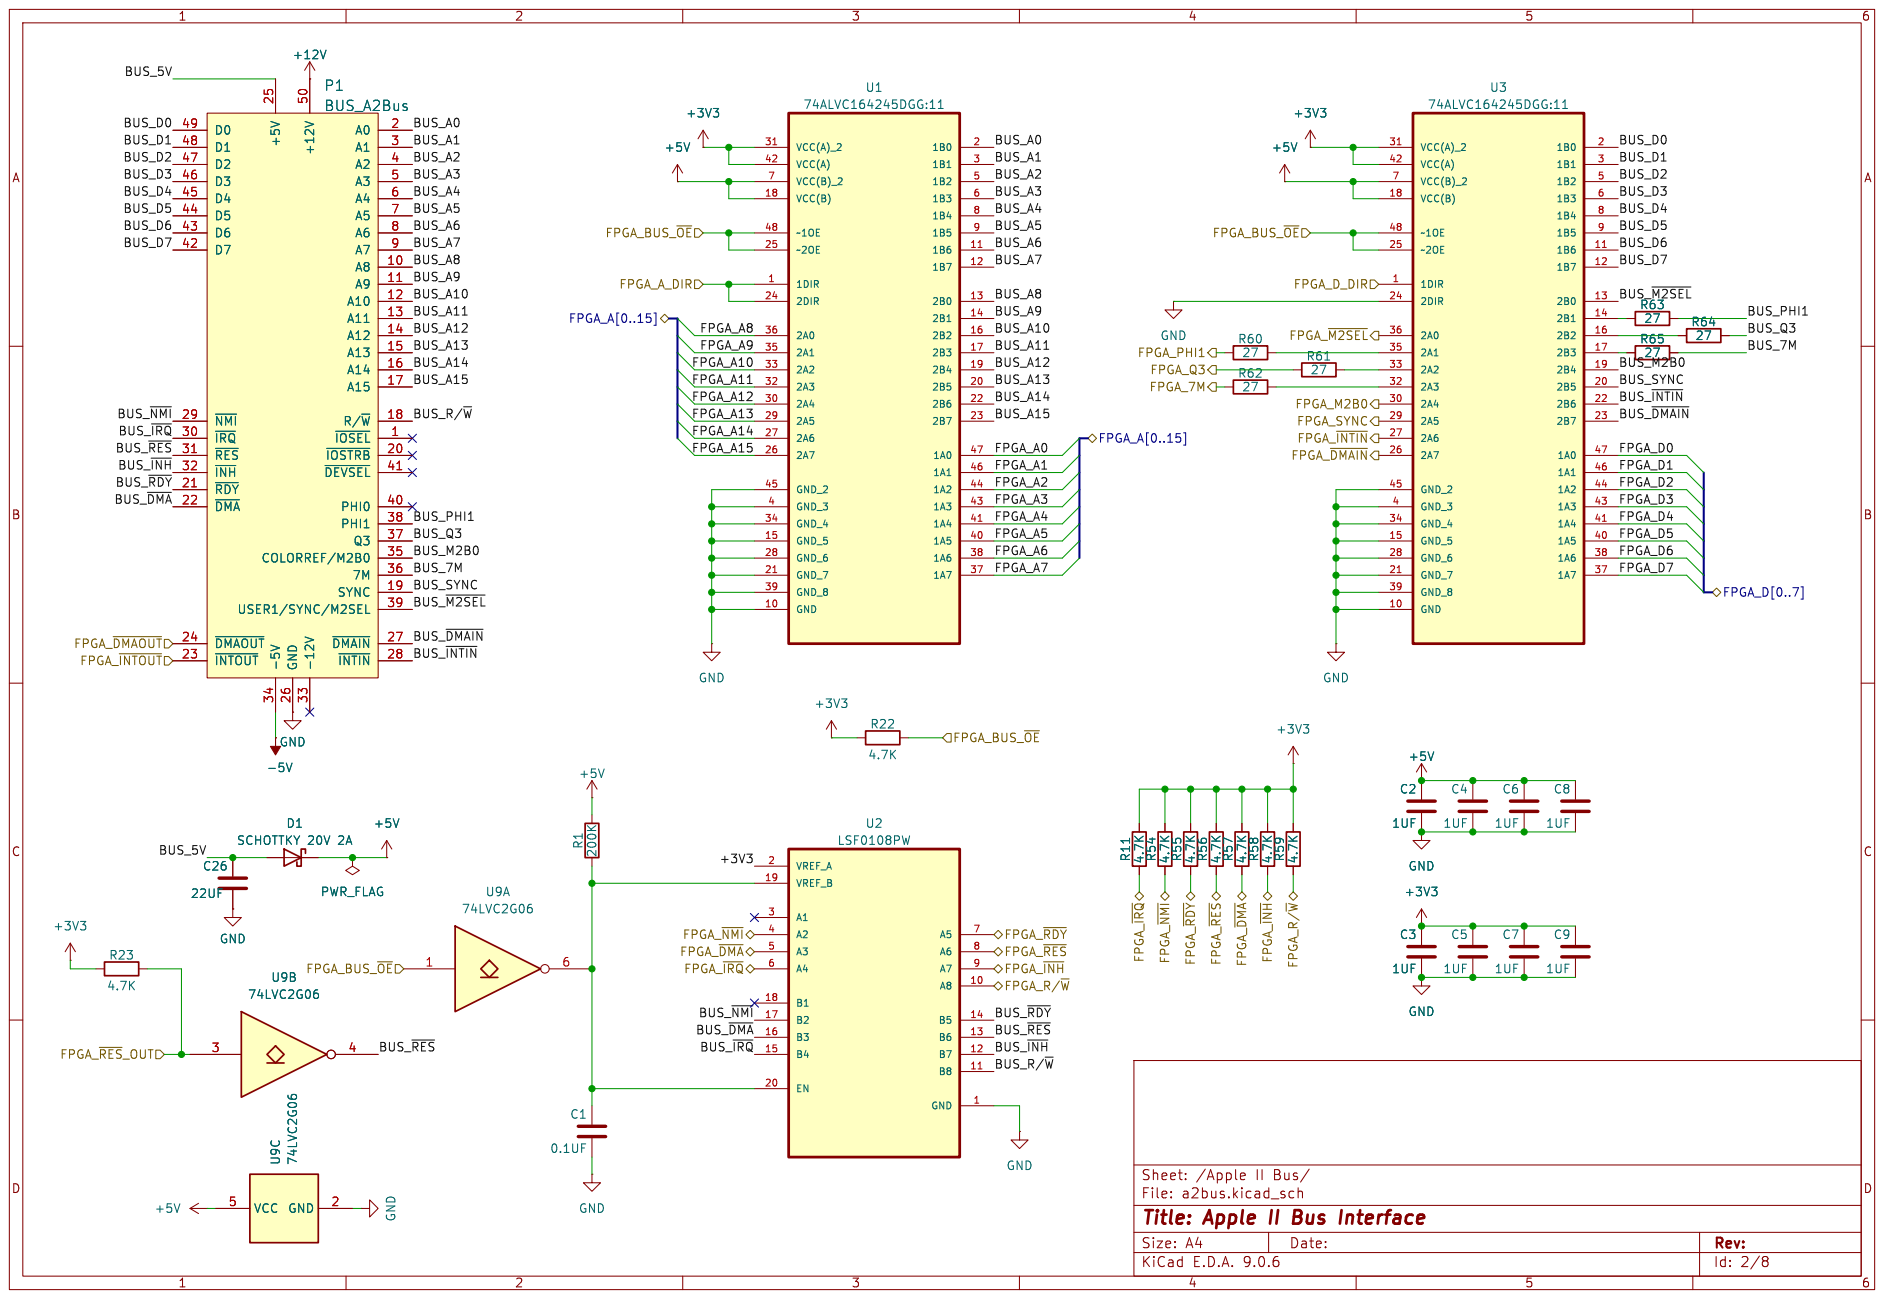
[picture p5: page 2]

Id: 2/8 Title: Apple II Bus Interface

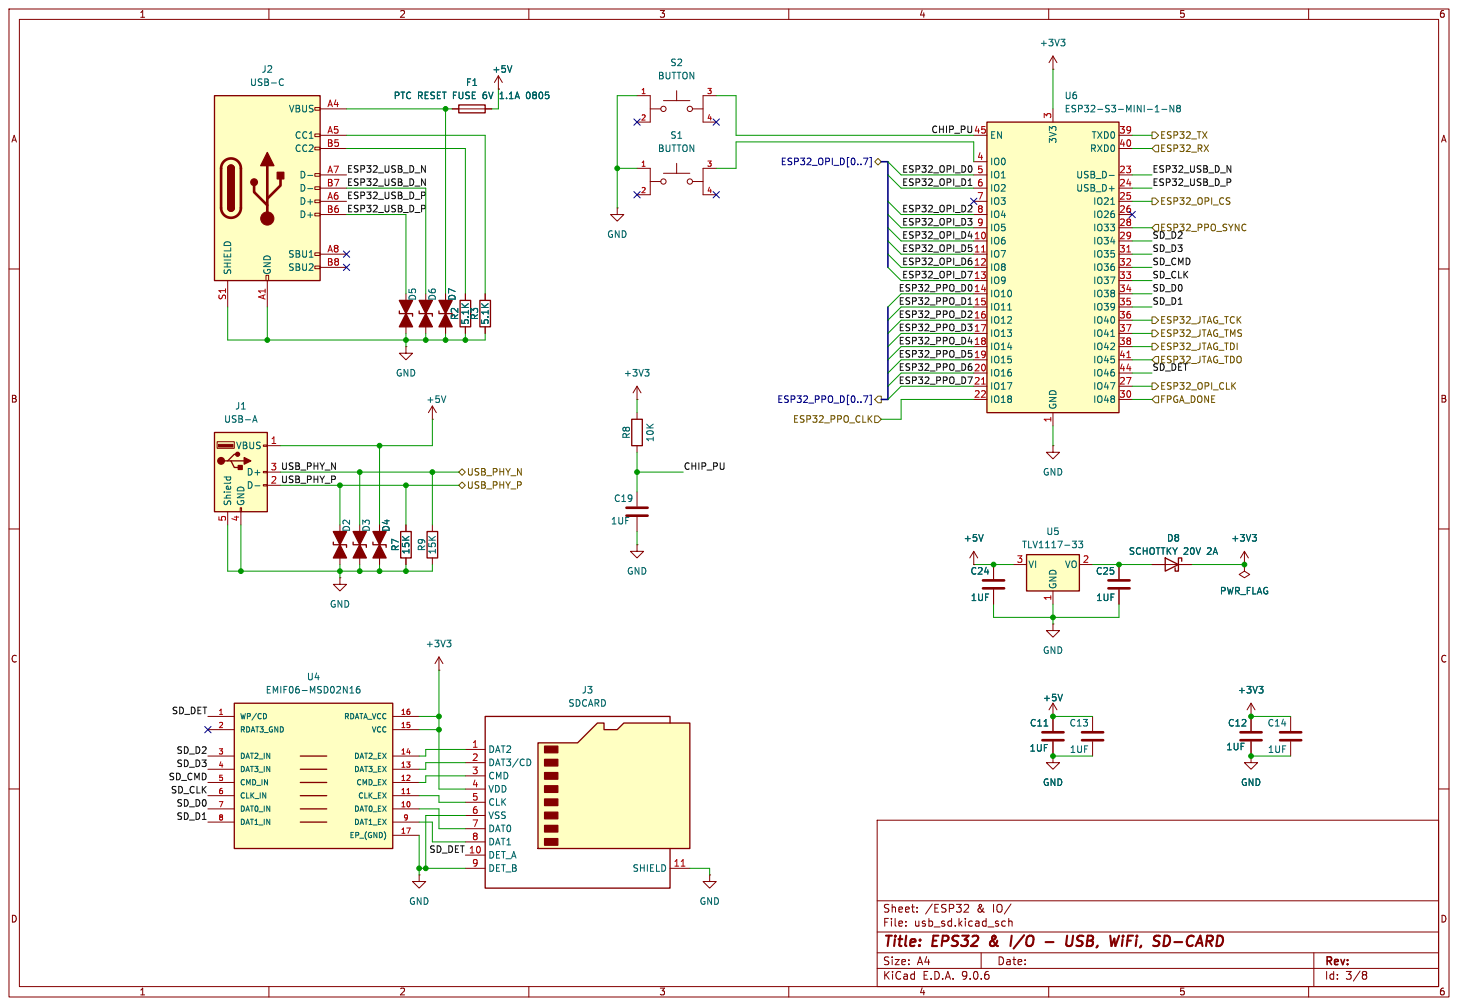
[picture p6: page 3]

Id: 3/8 Title: EPS32 & I/O - USB, WiFi, SD-CARD

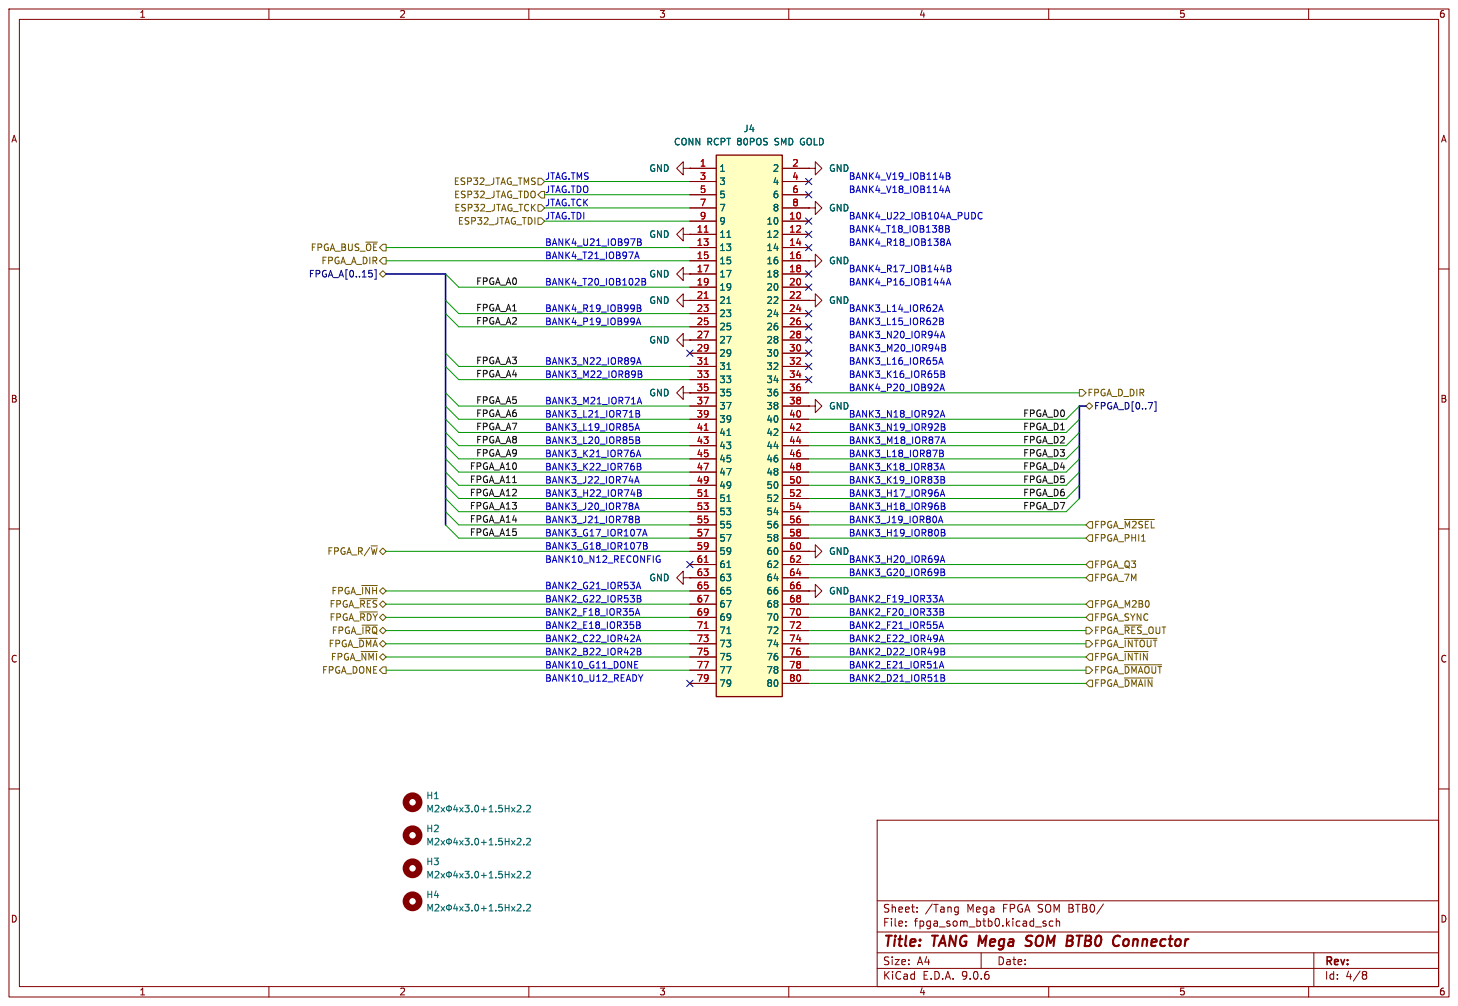
[picture p7: page 4]

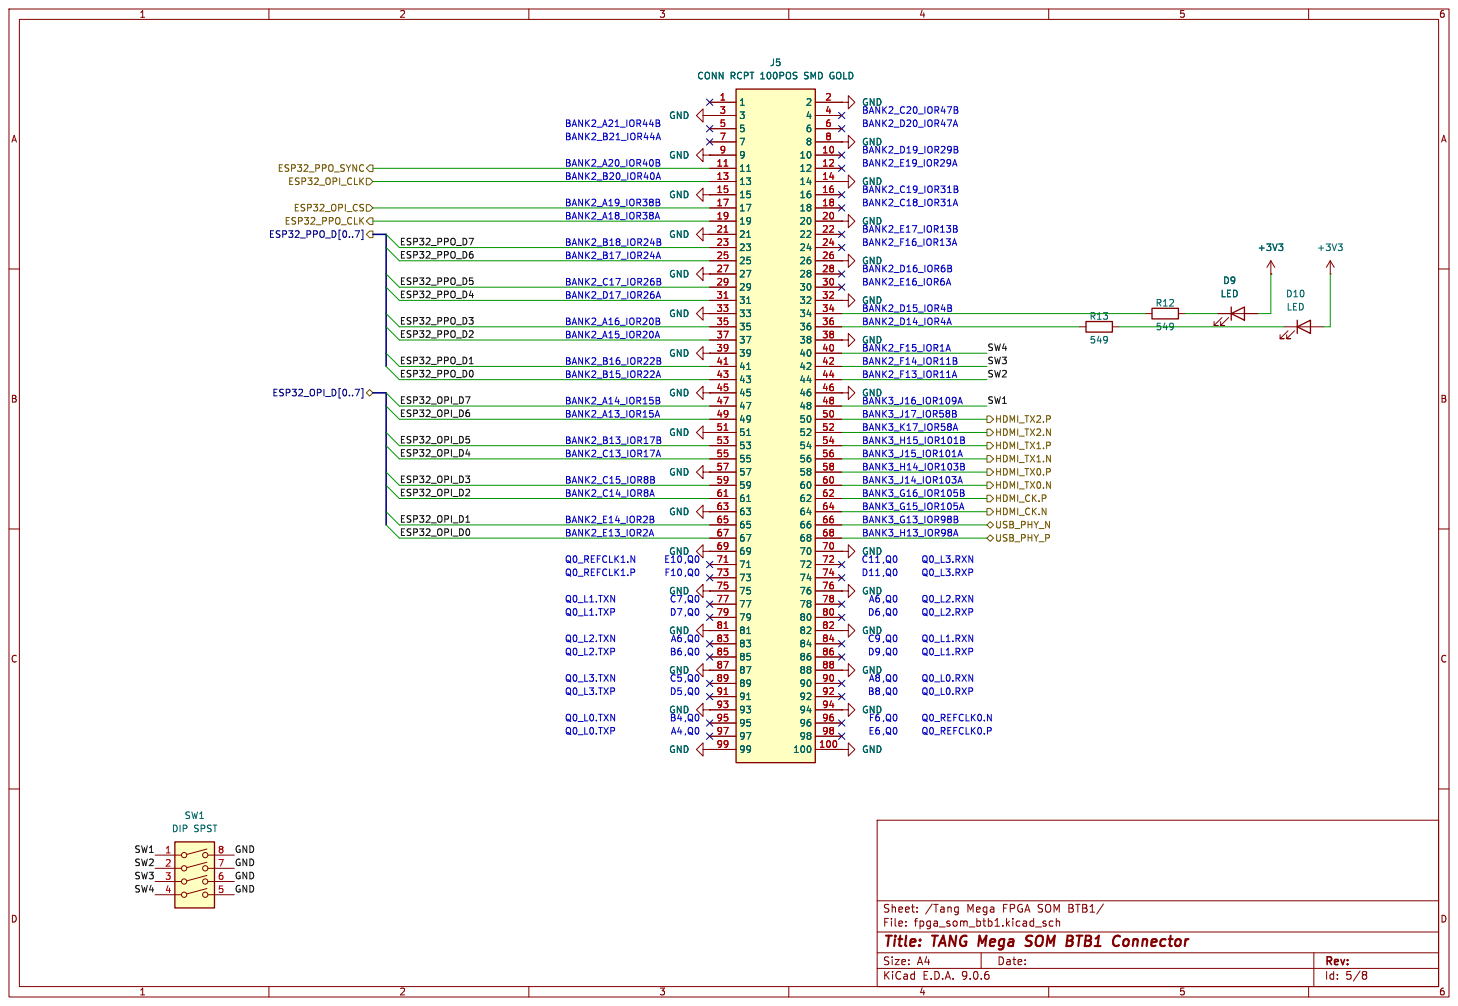
[picture p8: page 5]

F10 Q0_REFCLK1.N
,Q0 Q0_L2.TXP Q0_L1.TXN Q0_L1.TXP Q0_REFCLK1.P Q0_L2.TXN

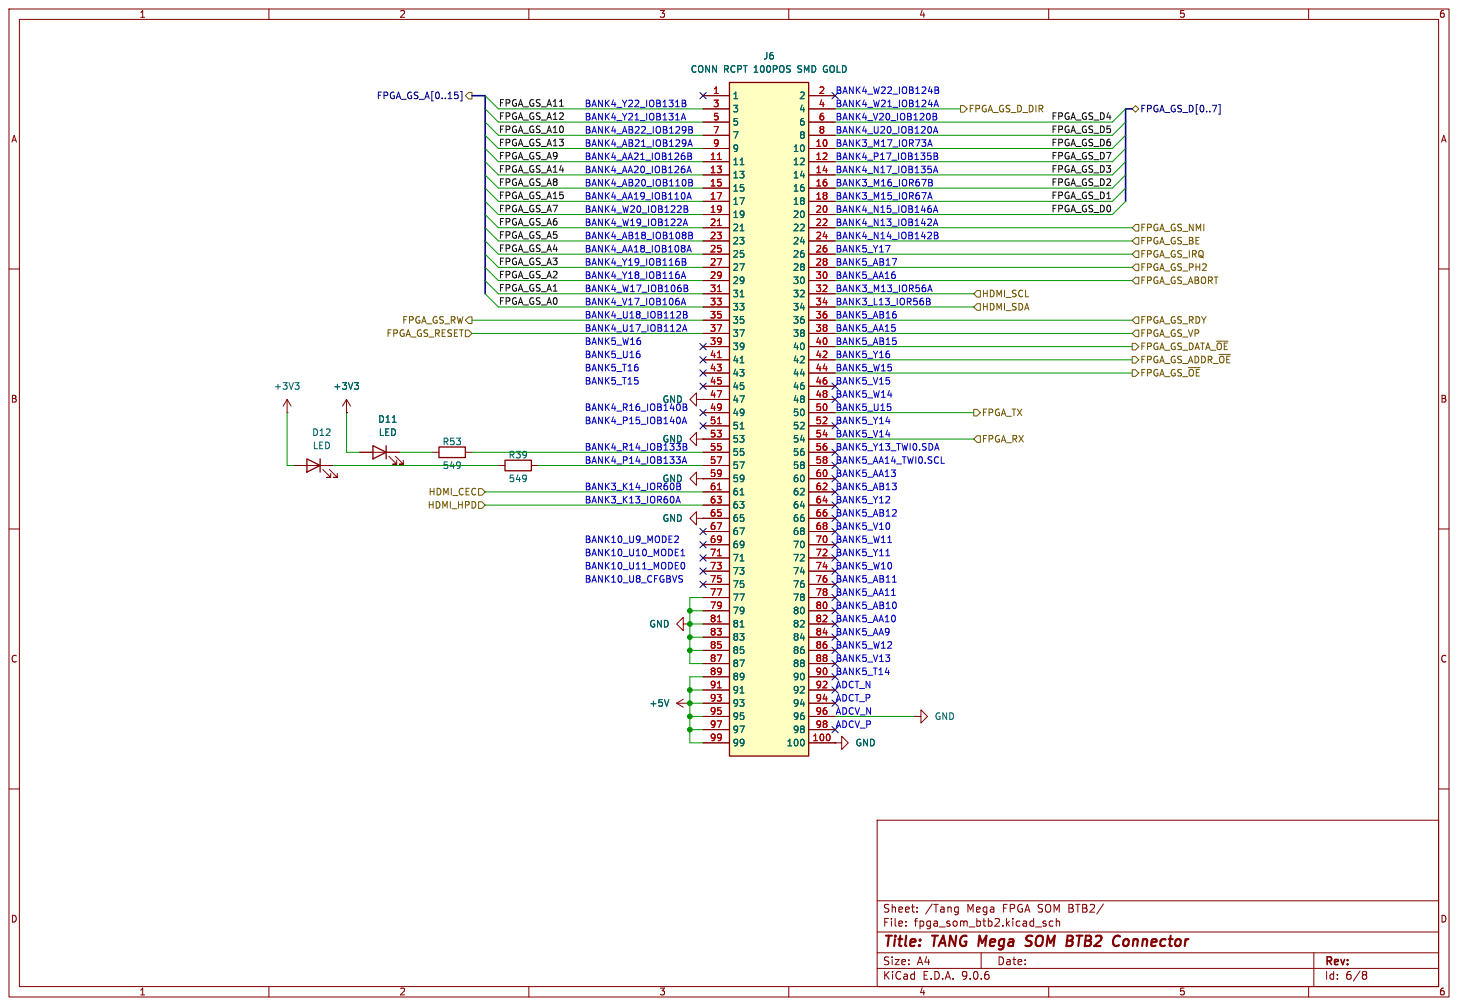
[picture p9: page 6]

J6 CONN RCPT 100POS SMD GOLD

BANK5_W10 GND GND GND GND

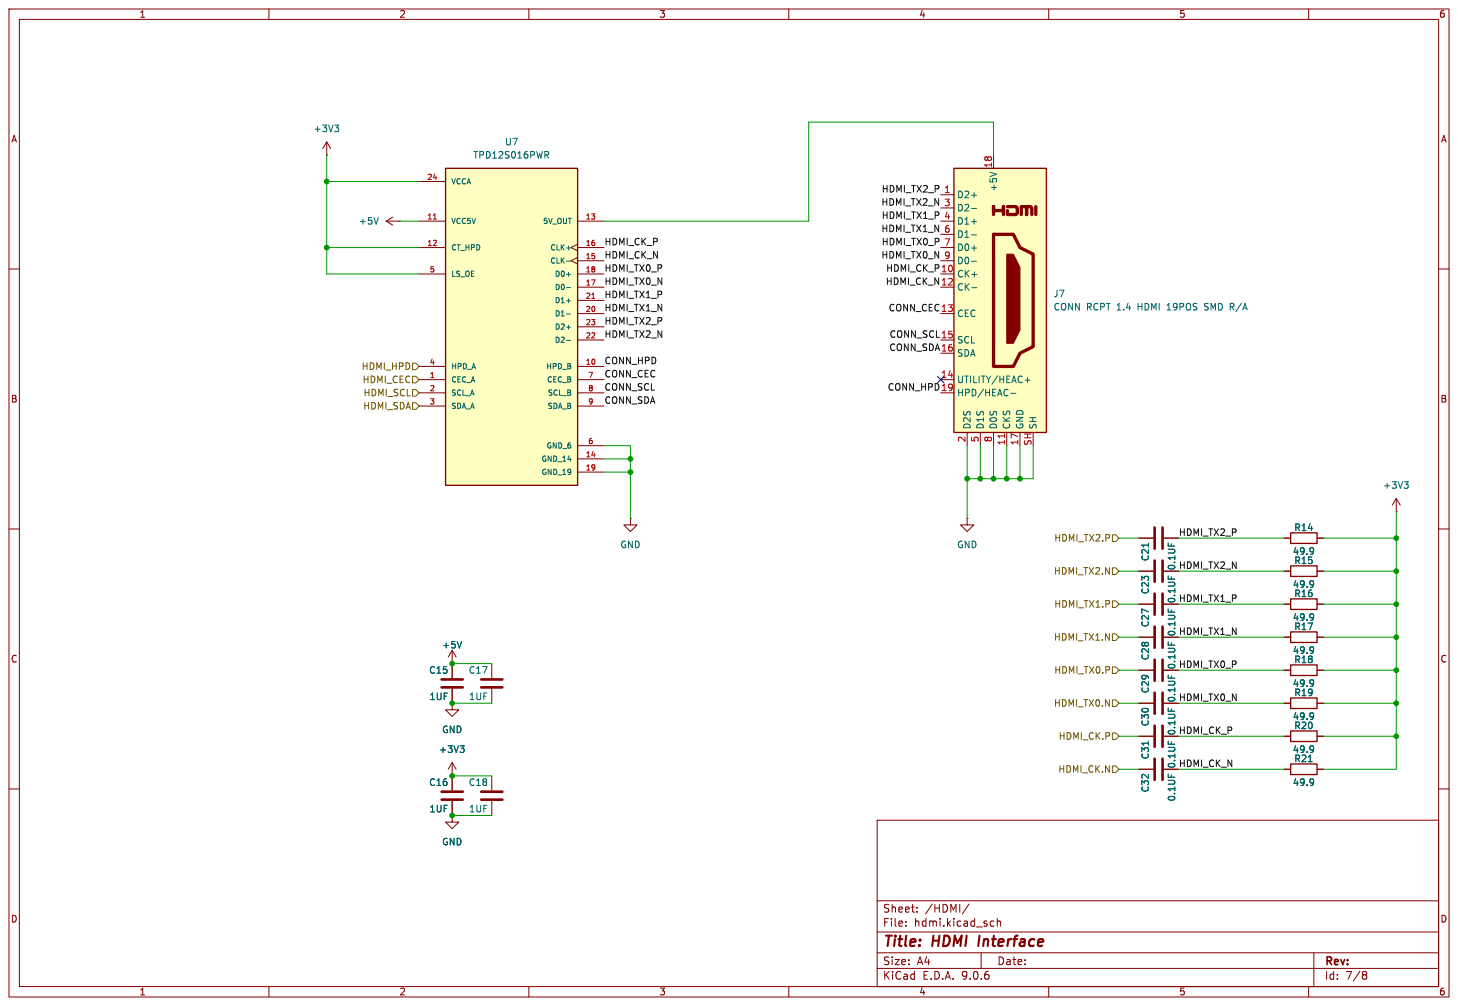
[picture p10: page 7]

Id: 7/8 Title: HDMI Interface

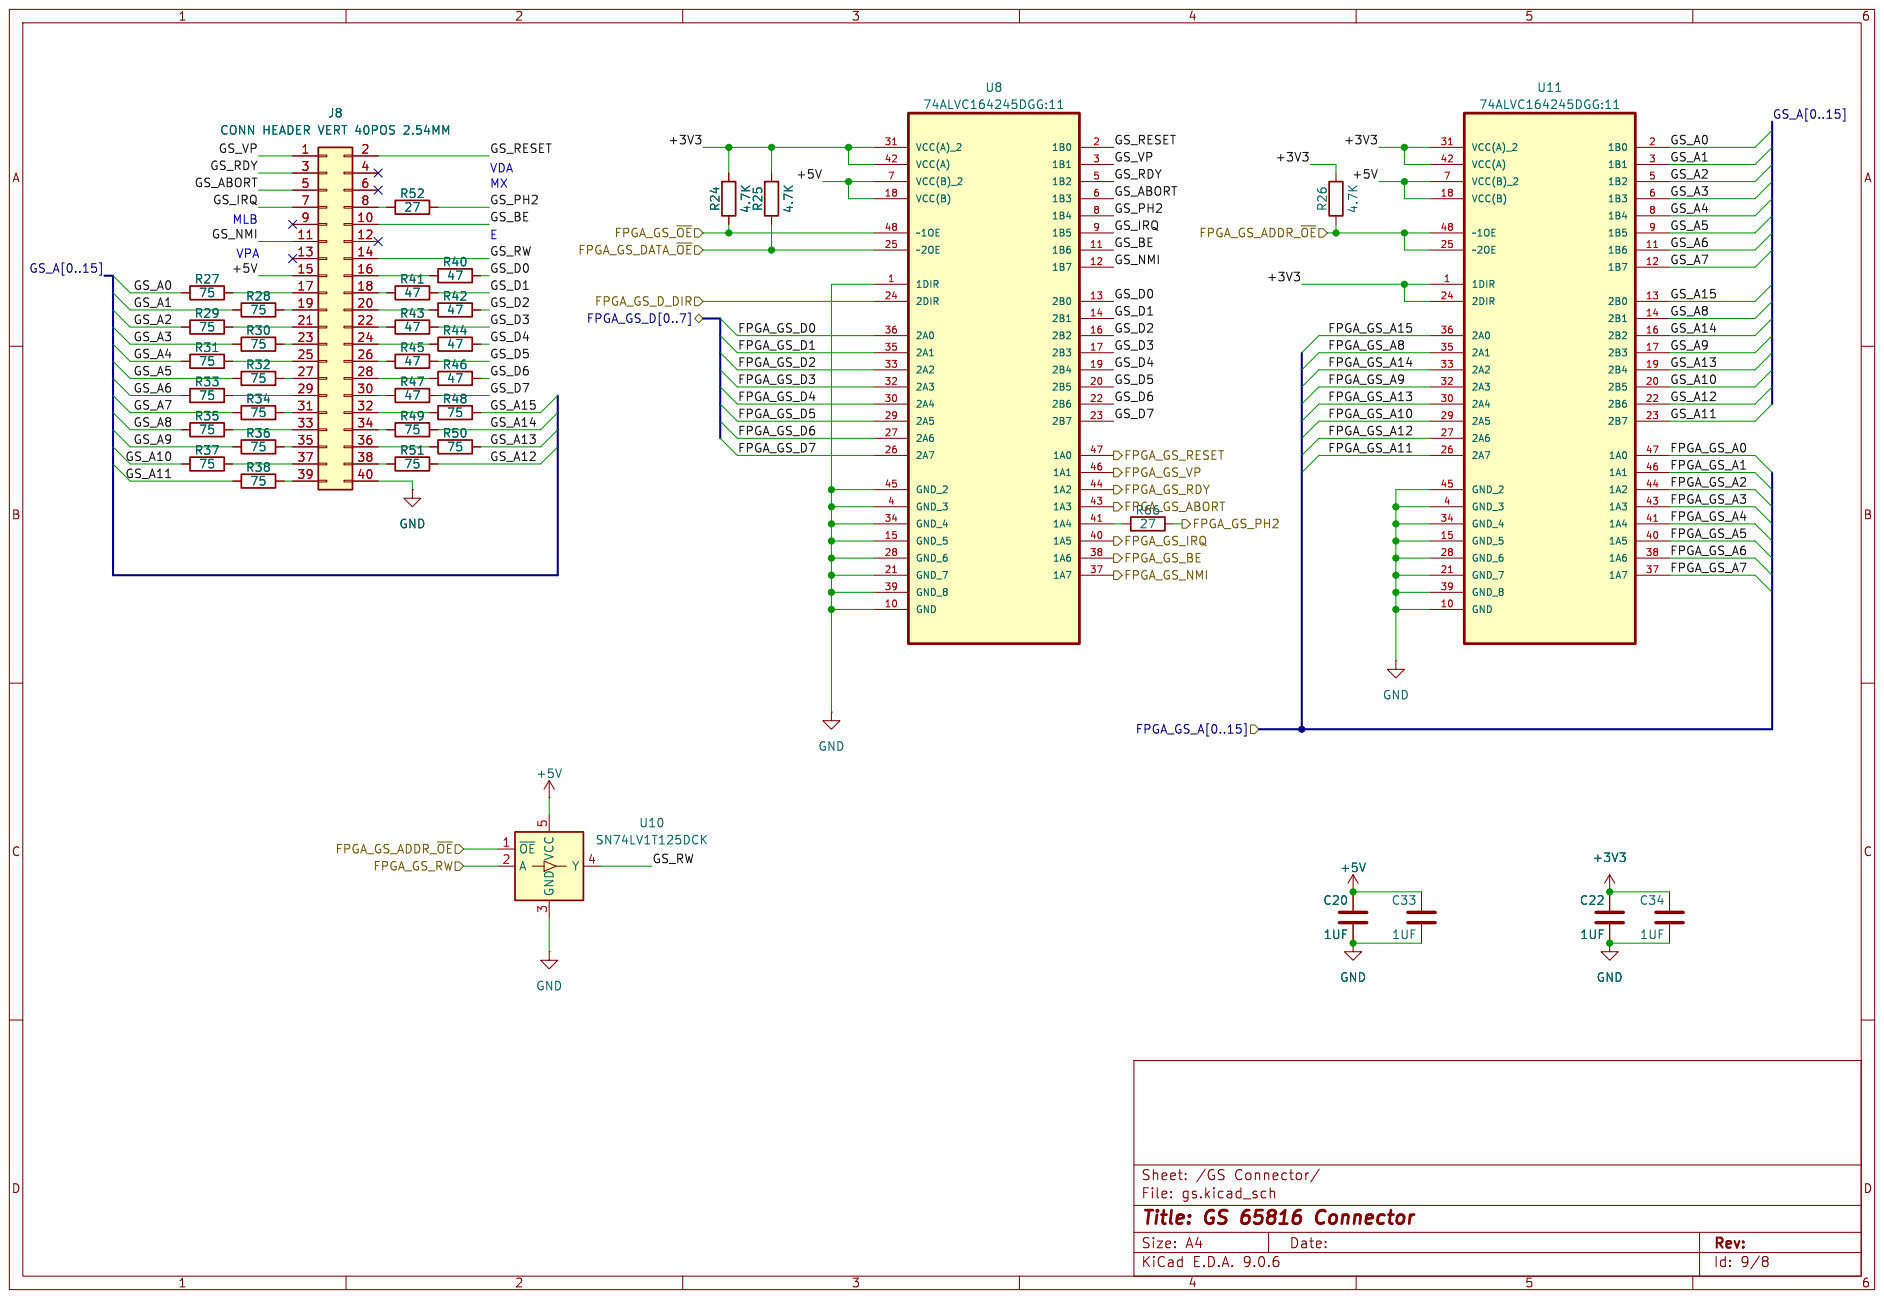
[picture p11: page 8]
