a2fpga/a2fpga_core/boards/a2p25/sch/a2-p25.pdf

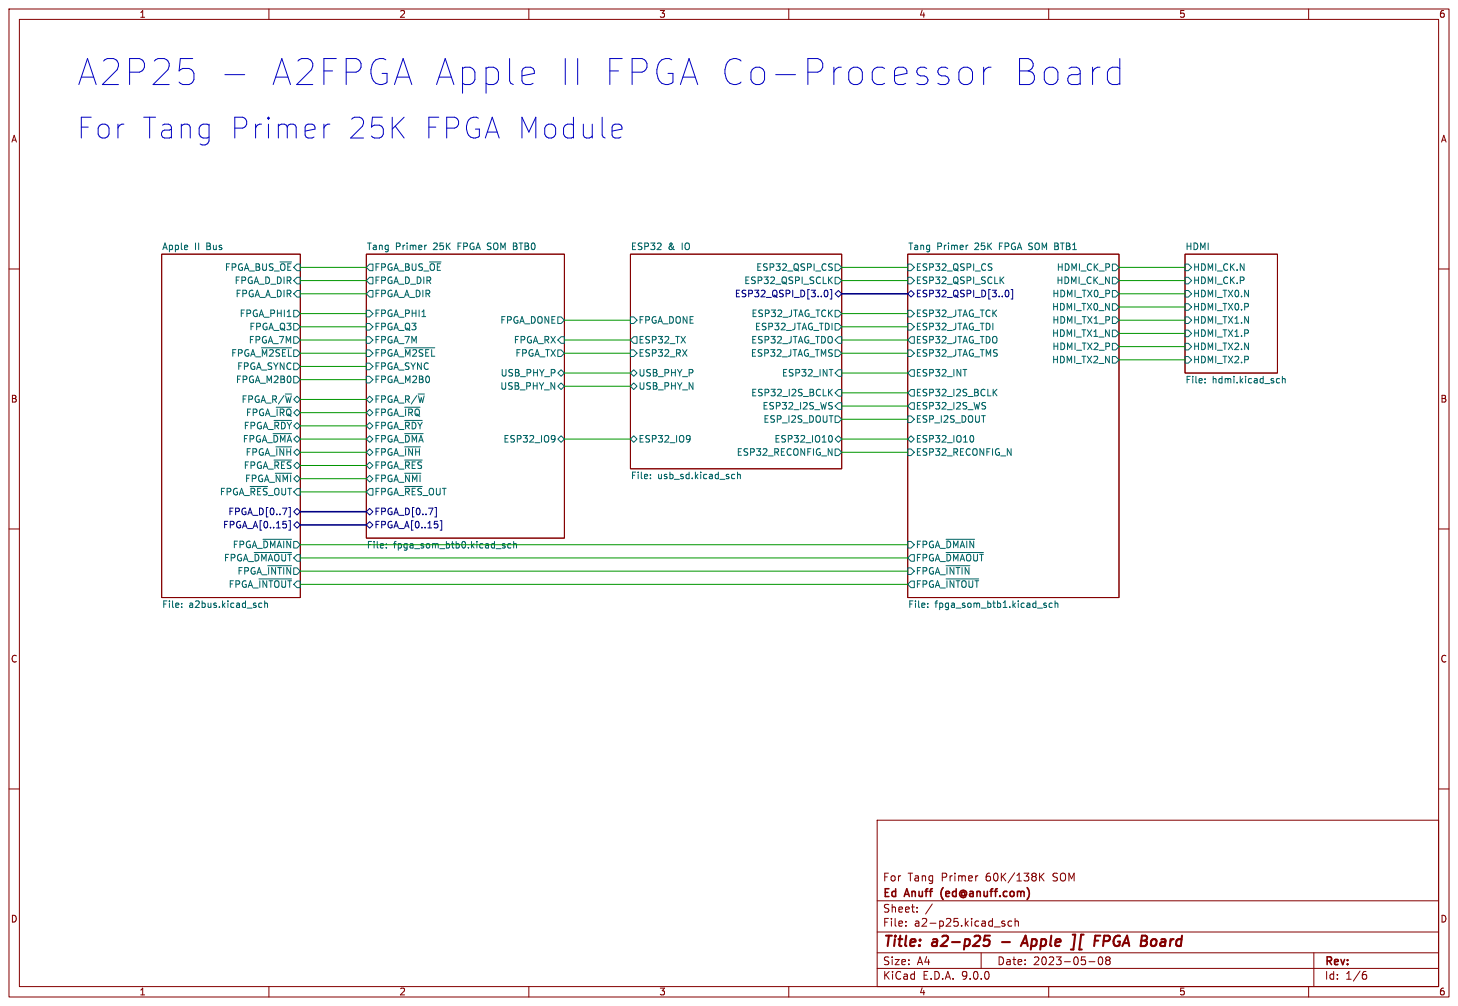
[picture p12: page 1]

File: usb_sd.kicad_sch For Tang Primer 25K FPGA Module

HDMI_TX2.P HDMI File: hdmi.kicad_sch FPGA_BUS_~{OE} FPGA_A_DIR

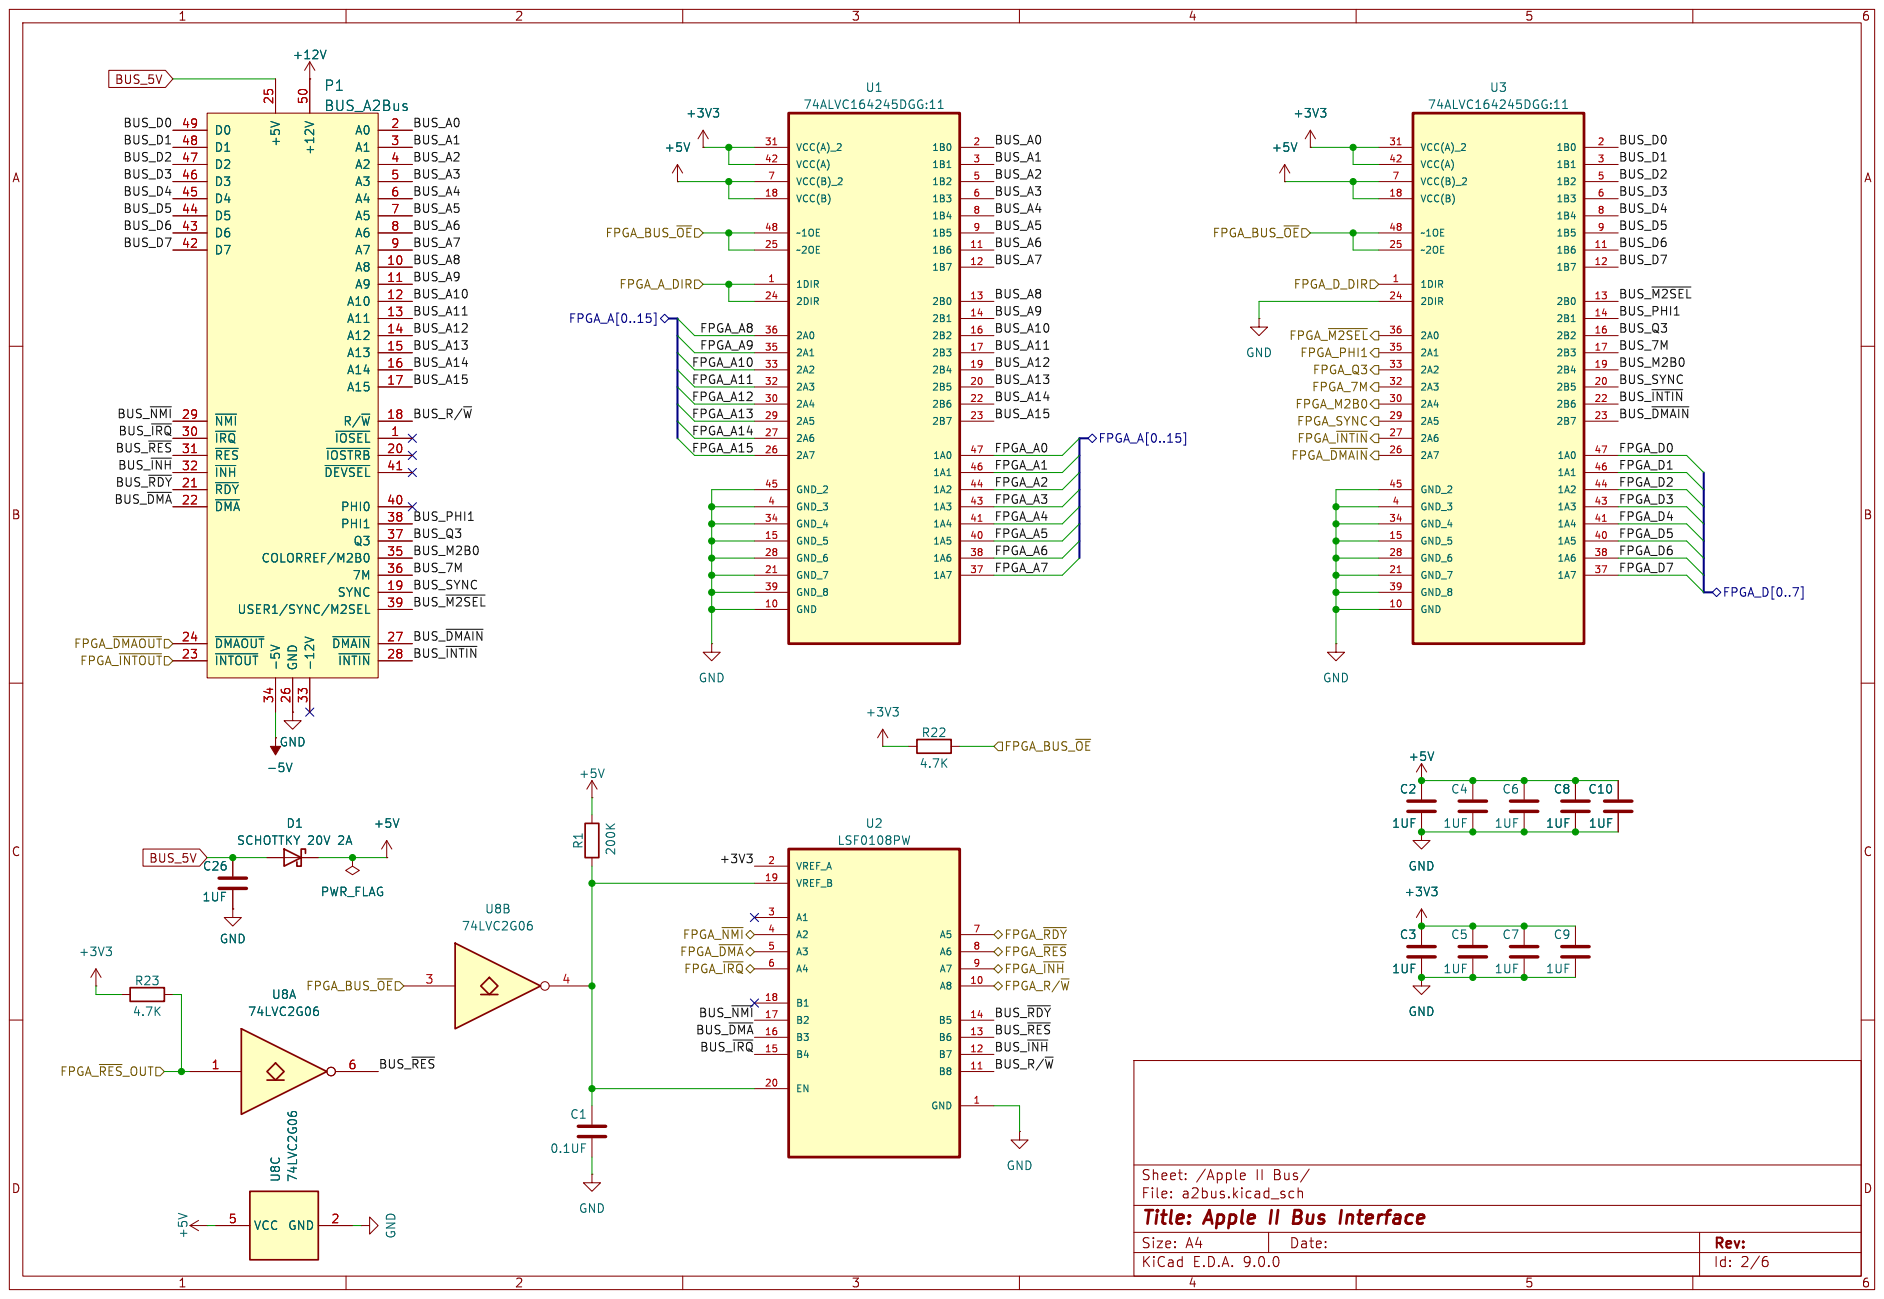
[picture p13: page 2]

Id: 2/6 Title: Apple II Bus Interface

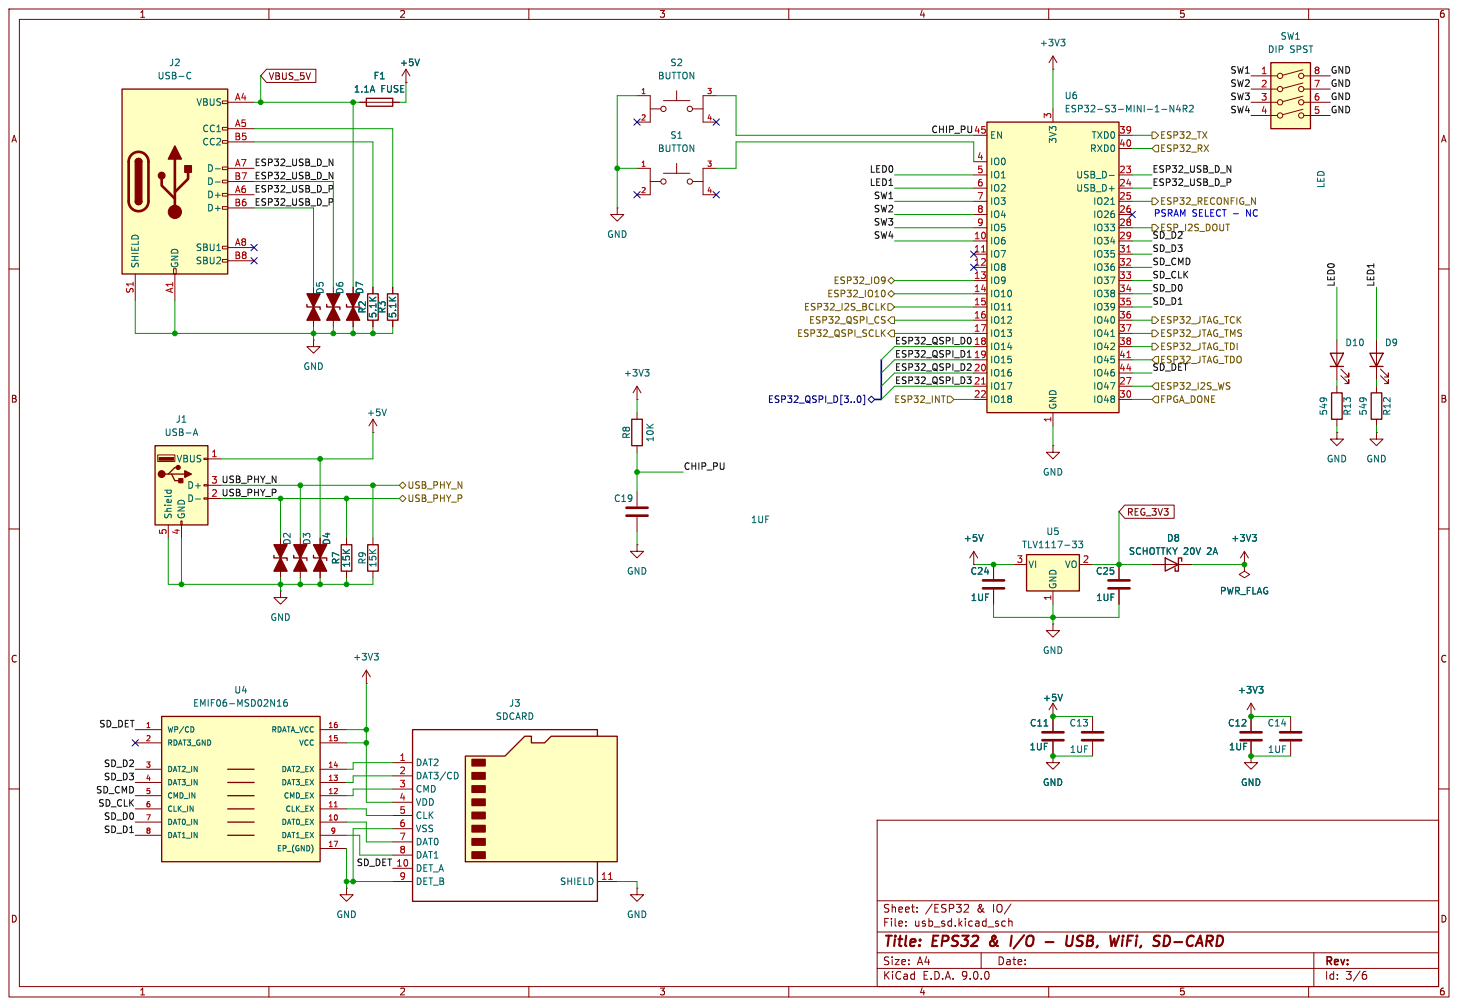
[picture p14: page 3]

Id: 3/6 Title: EPS32 & I/O - USB, WiFi, SD-CARD

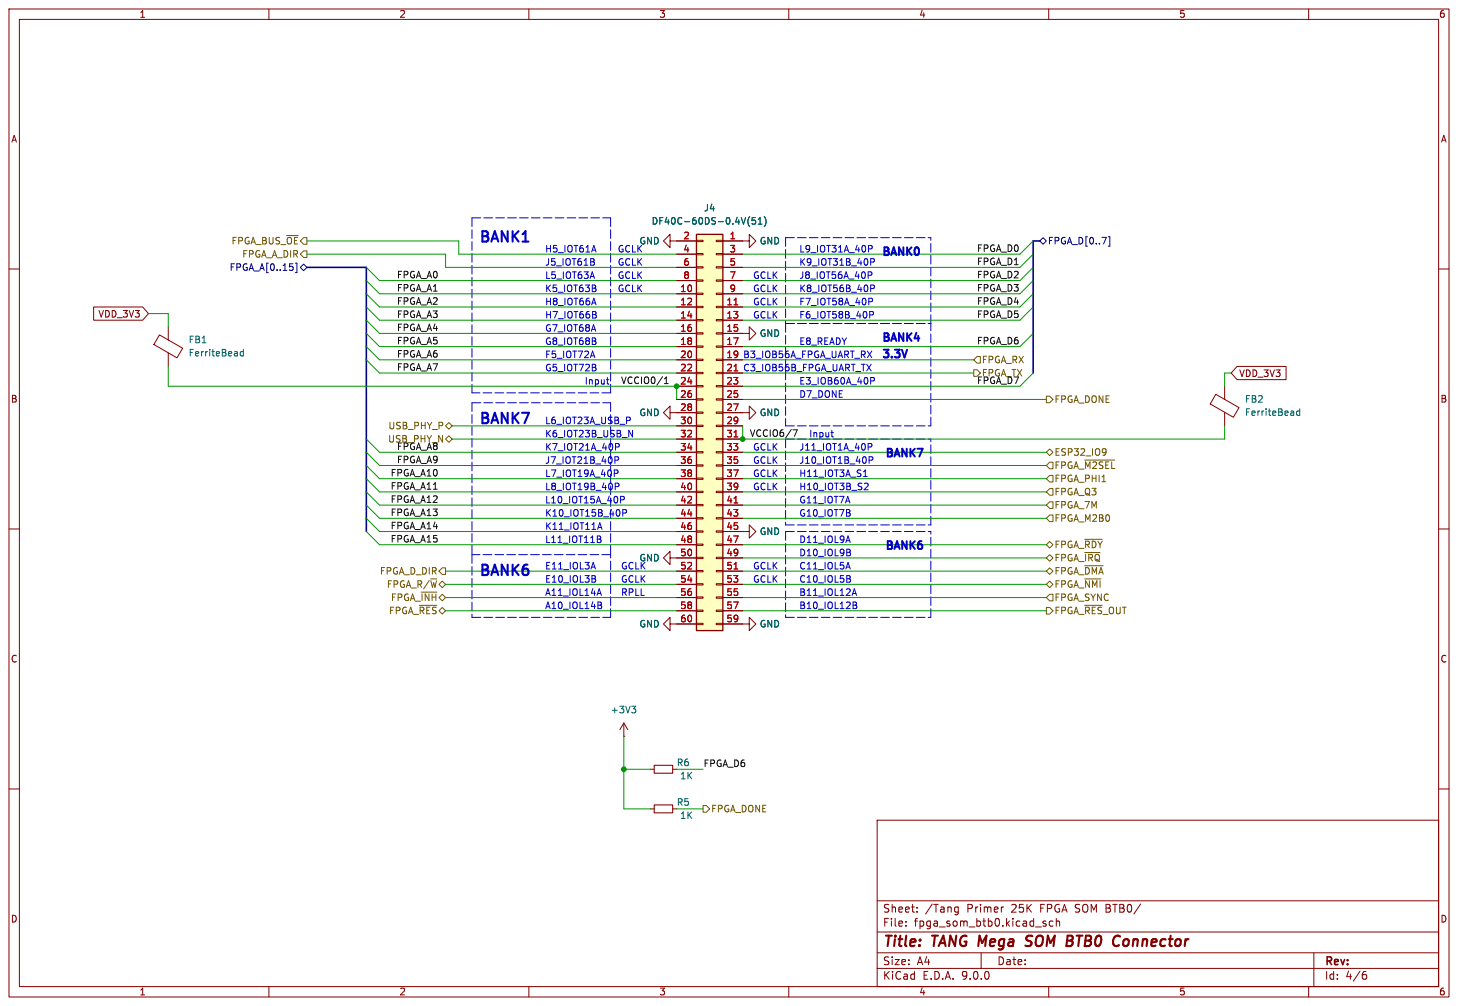
[picture p15: page 4]

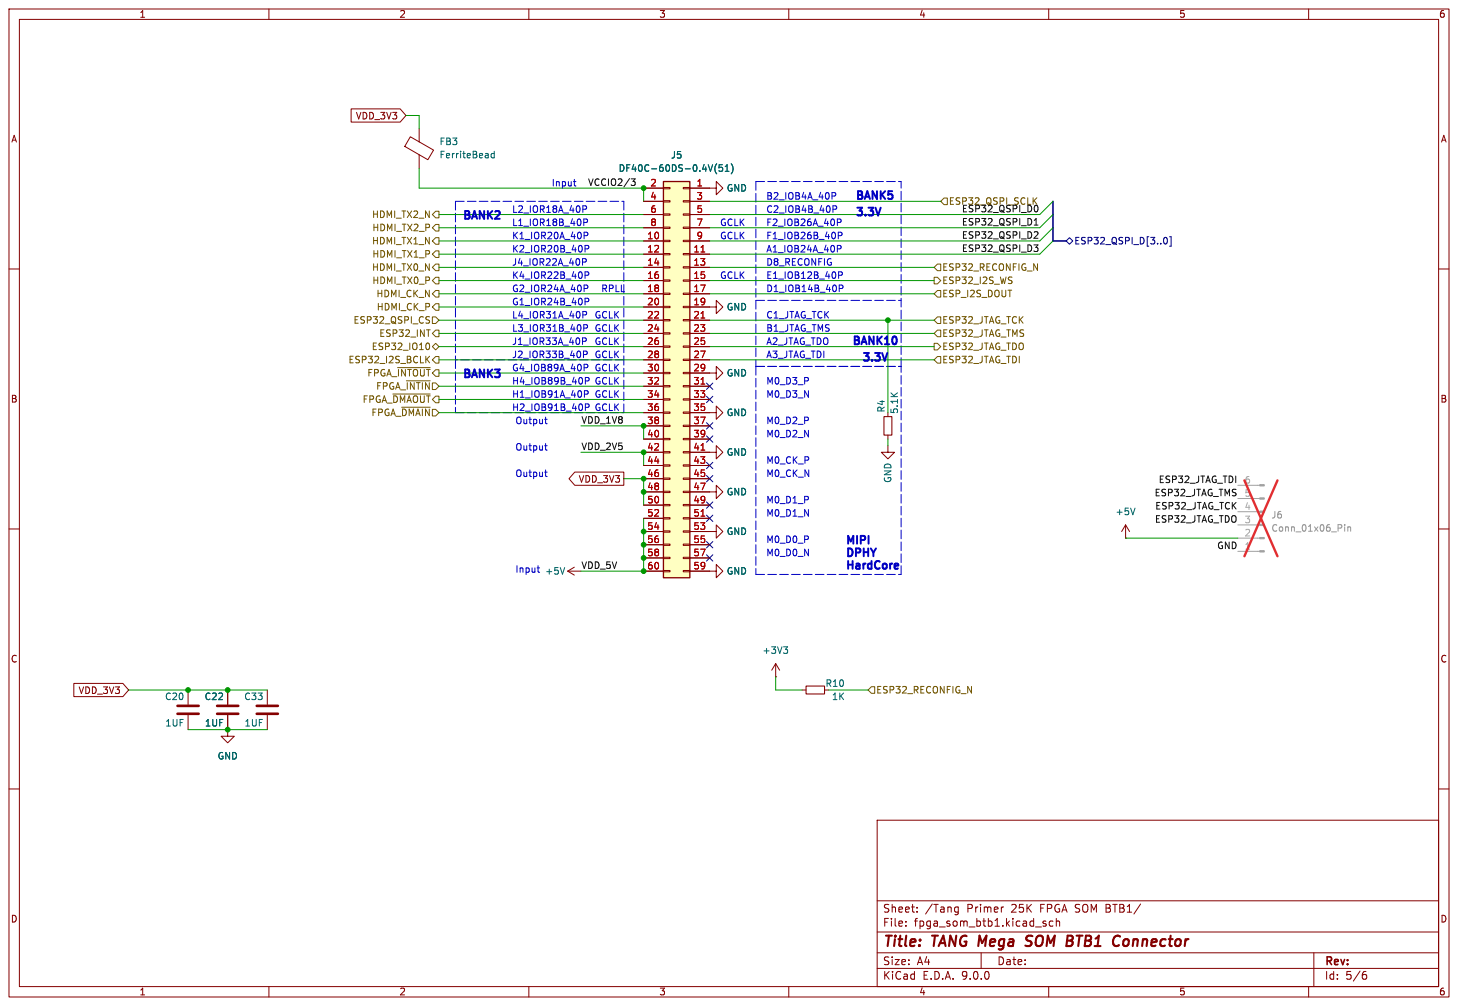
[picture p16: page 5]

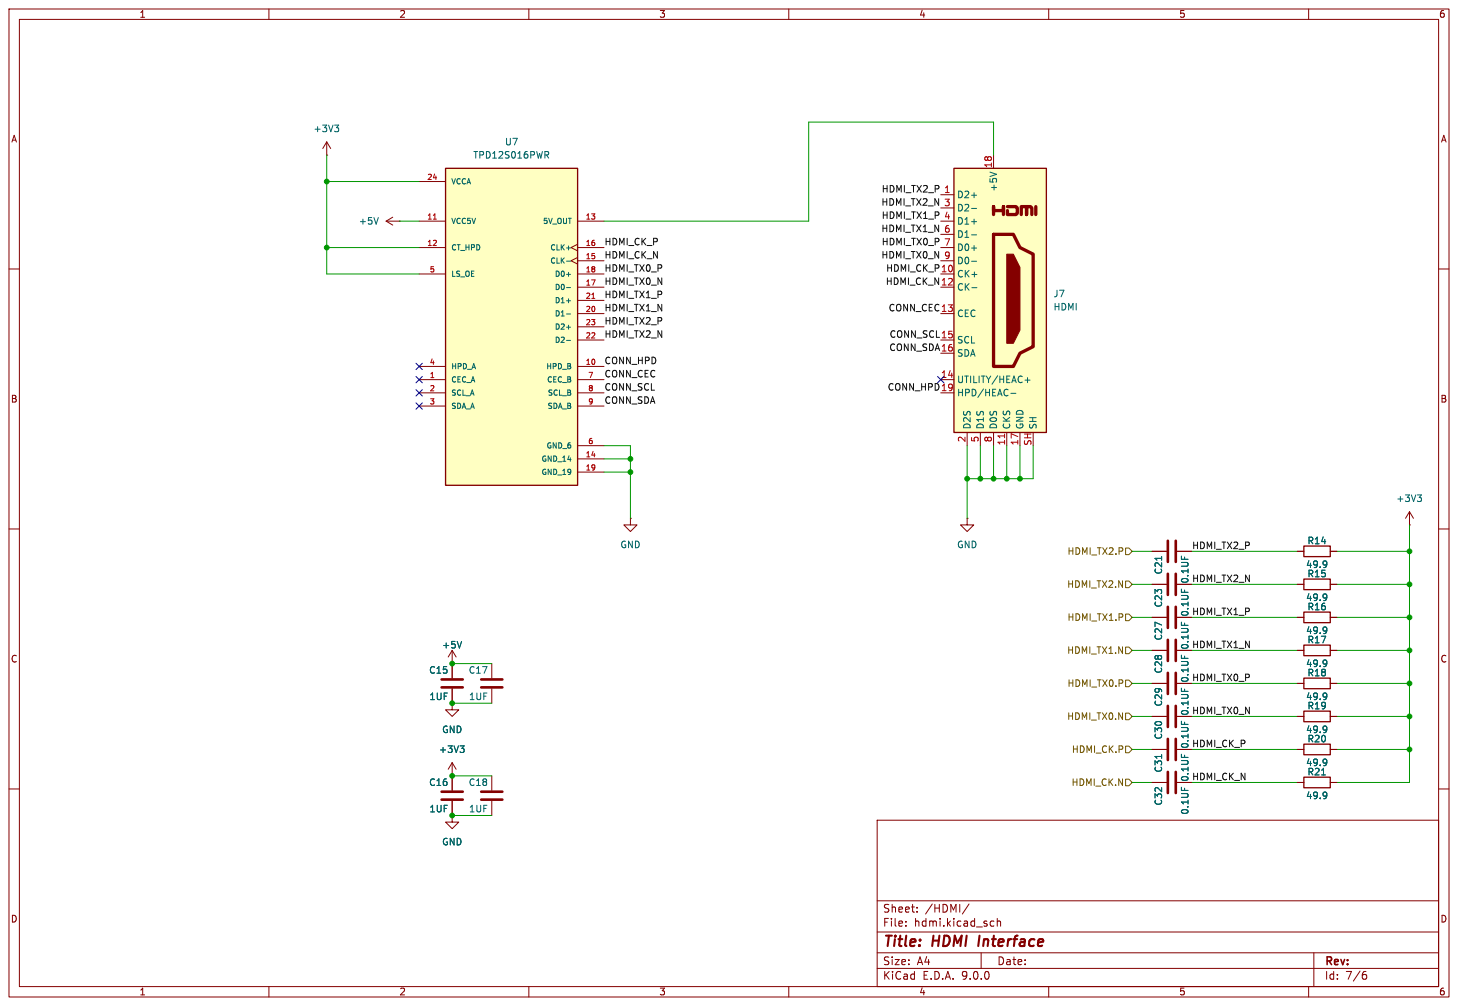
[picture p17: page 6]

File: hdmi.kicad_sch Sheet: /HDMI/
Id: 7/6 Title: HDMI Interface
