a2fpga/a2fpga_core/boards/a2n20v2/sch/a2n20v2.pdf

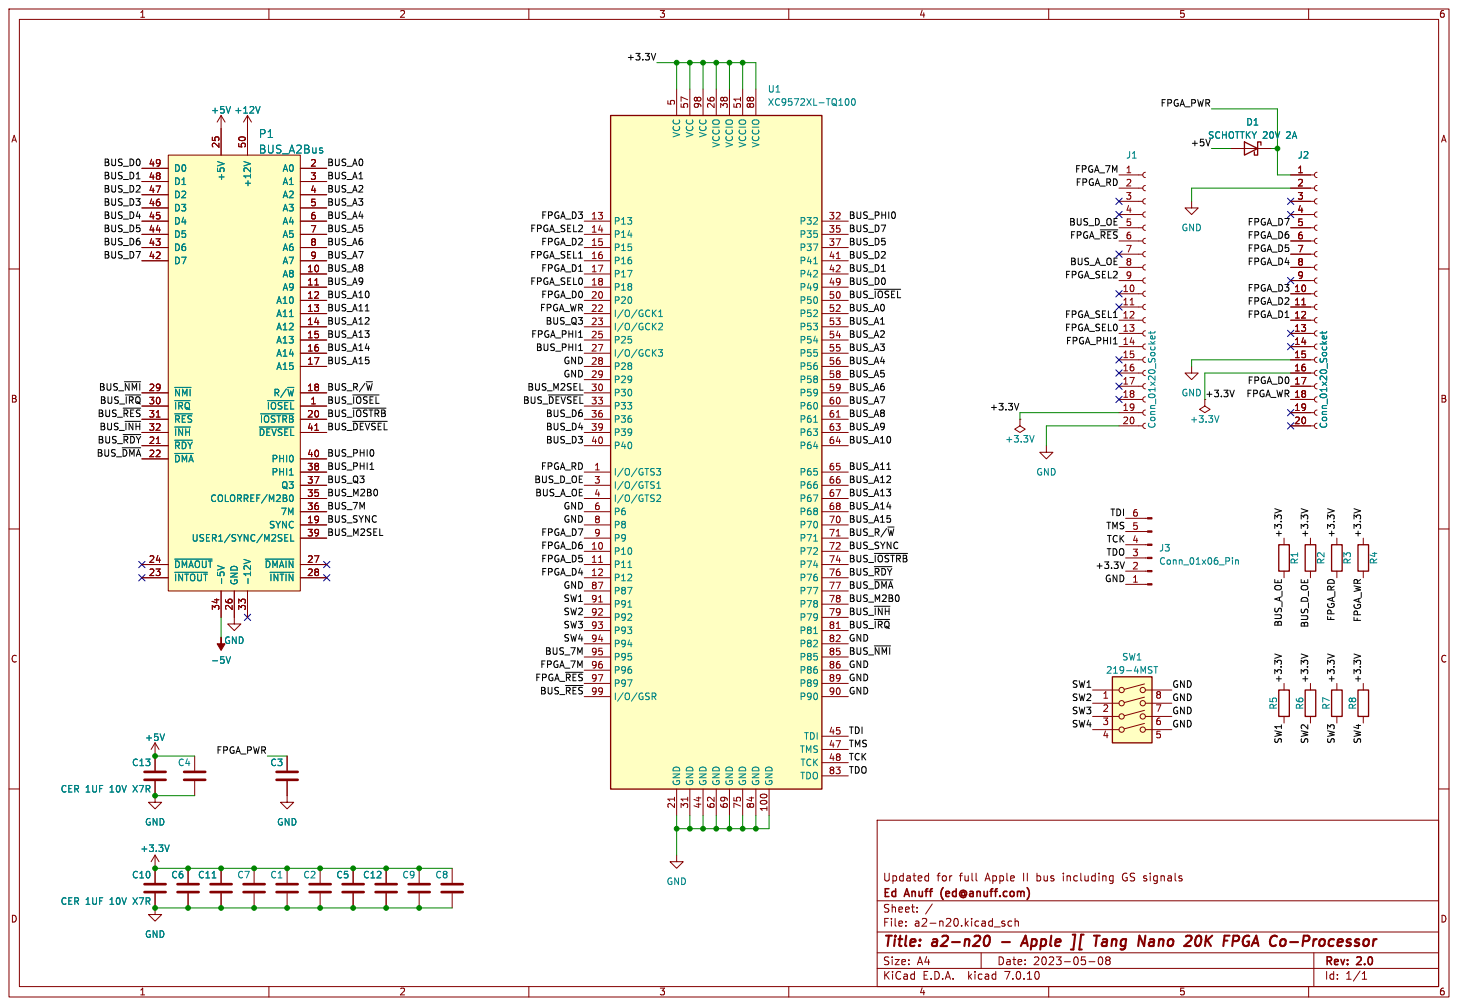
[picture p18: page 1]

5 P50 50 VCCIO 51 P52 52 P53 53 P54 54 P55 55 P56 56 VCC 57 P58 58 P59 59 P6 6 P60 60 P61 61 GND 62 P63 63 P64 64 P65 65 P66 66 P67 67 P68 68 GND 69 P70 70 P71 71 P72 72 P74 74 GND 75 P76 76 P77 77 P78 78 P79 79 P8 8 P81 81 P82 82 TDO 83 GND 84 P85 85 P86 86 P87 87 VCCIO 88 P89 89 P9 9 P90 90 P91 91 P92 92 P93 93 P94 94 P95 95 P96 96 P97 97 VCC 98
