a2fpga/a2fpga_core/boards/a2n9/sch/a2n9.pdf

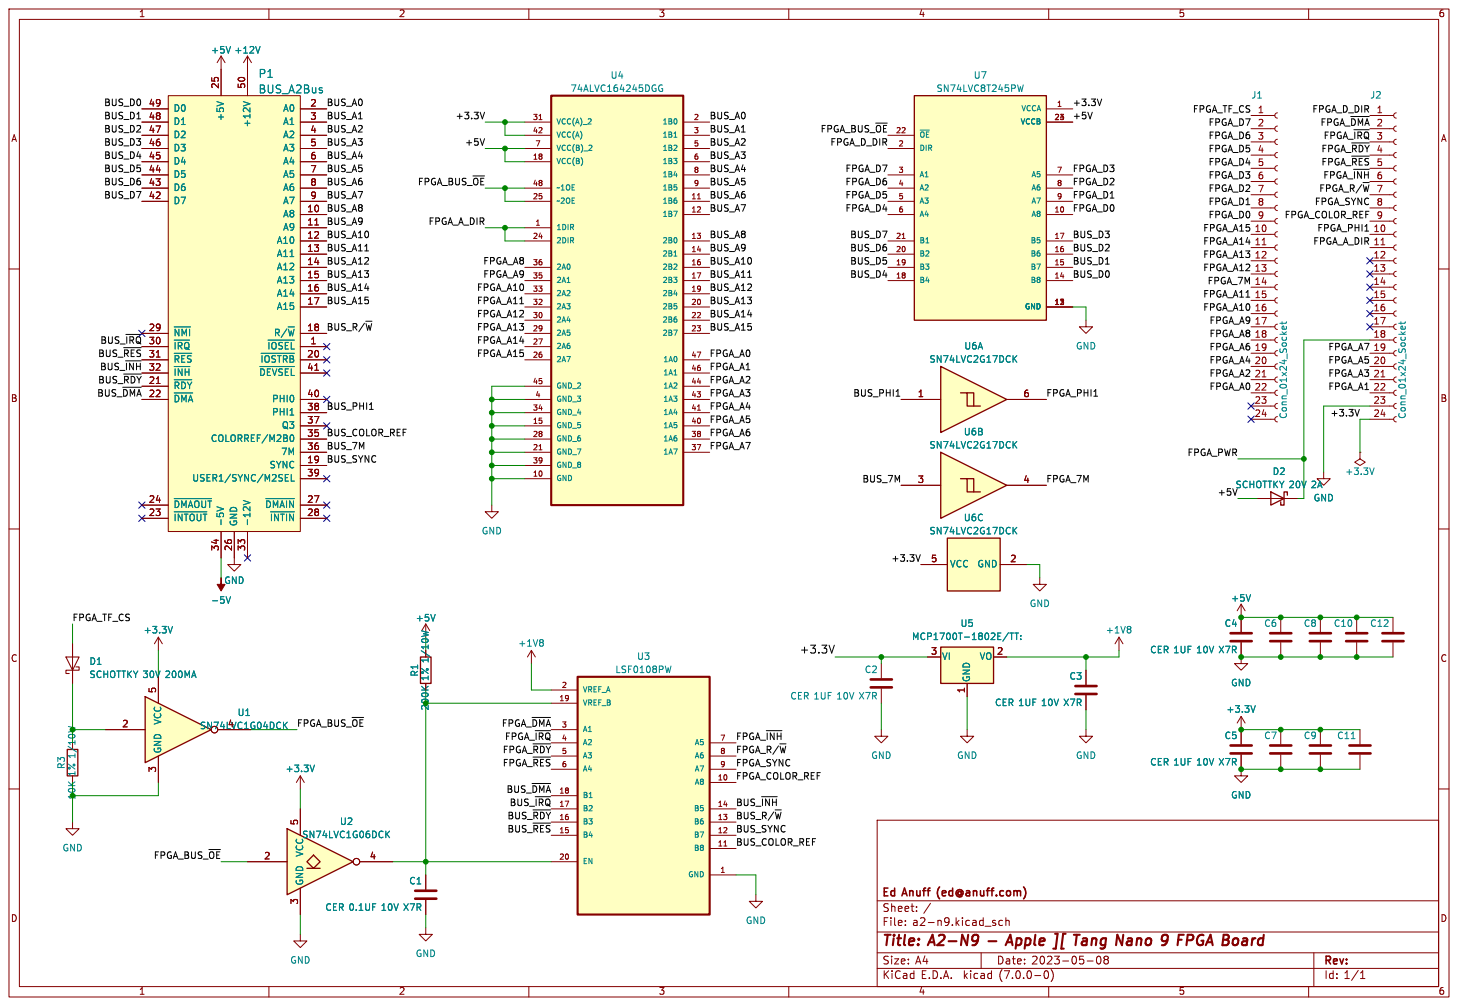
[picture p19: page 1]

1 VO 2 VI 3 U5 MCP1700T-1802E/TT: GND 2 VCC 5 U6C
SN74LVC2G17DCK

Id: 1/1 Title: A2-N9 - Apple ][ Tang Nano 9 FPGA Board
