a2fpga/a2fpga_core/boards/a2n20v1/sch/a2n20v1.pdf

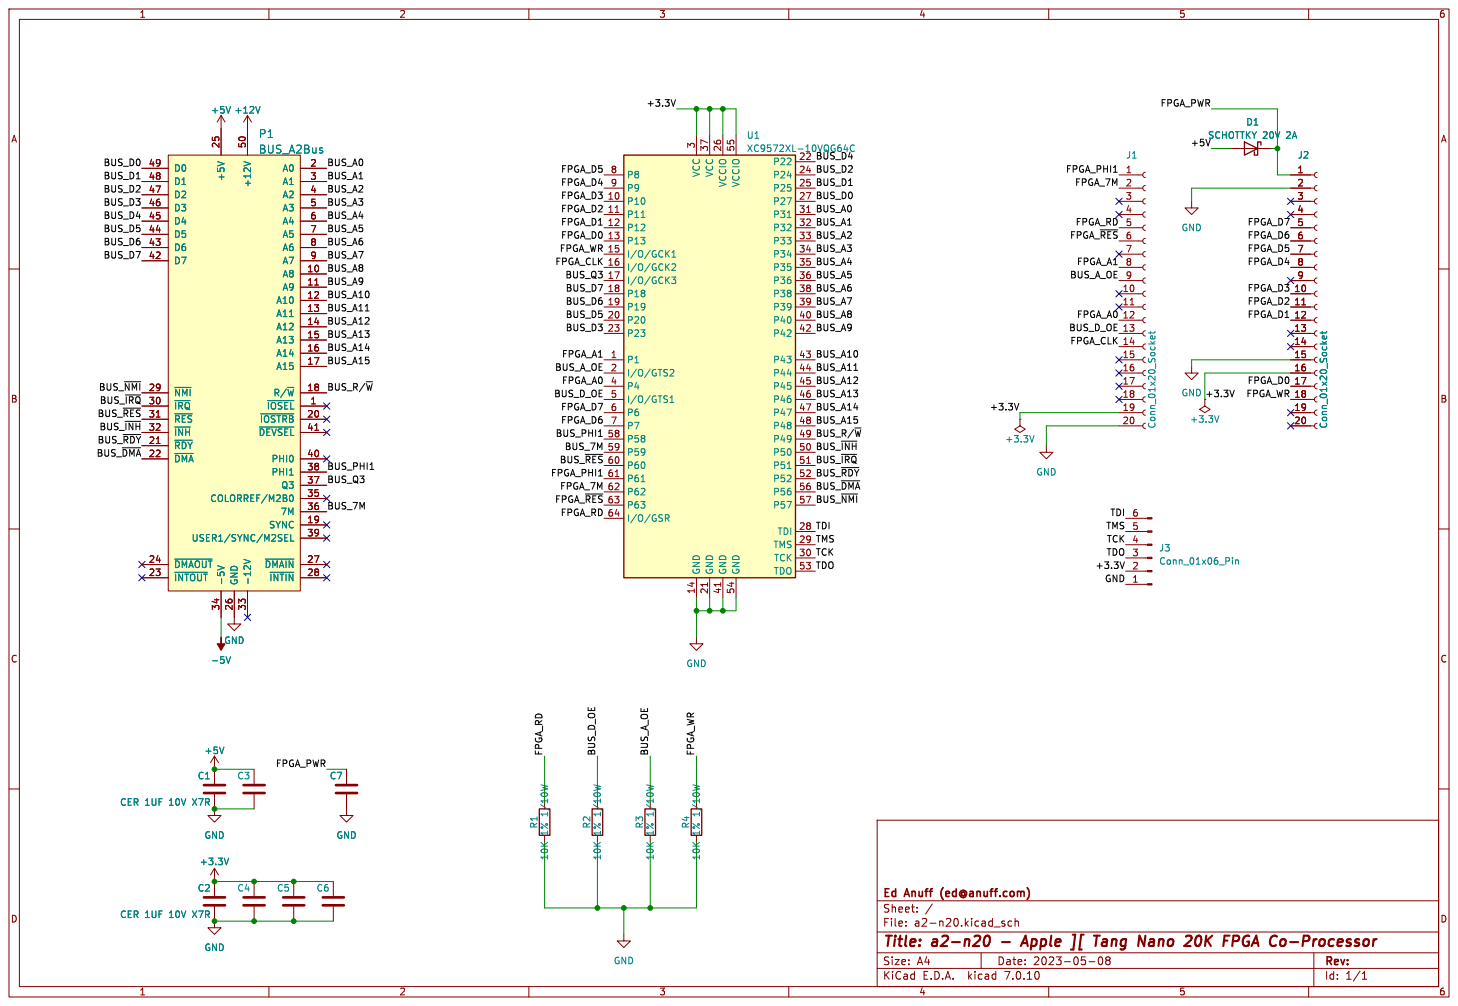
[picture p20: page 1]
