a2fpga/a2fpga_core/boards/a2n20v2-Enhanced/src/a2n20_bl616/firmware_host/main.c

/*
 * A2N20 BL616 Firmware — USB-HOST build (standalone joystick mode)
 *
 * This is a SEPARATE build from the default FT2232 device-mode firmware in
 * ../firmware. In host mode the BL616 OTG port becomes a USB host: it powers
 * and enumerates a USB XInput gamepad (optionally behind a hub) and drives the
 * FPGA over SPI. The FT2232 JTAG/UART bridge and CLI are NOT present in this
 * build (those are USB-device endpoints, mutually exclusive with host mode).
 *
 * Phase 1/2/3 behavior:
 *   - bring up the CherryUSB host stack (EHCI on the BL616 OTG controller)
 *   - register the XInput vendor-class driver (usbh_xinput.c)
 *   - on connect, show a status line on the Apple II screen via fpga_screen
 *   - poll the controller; on a Select (Back) button press, toggle the display
 *     between the live Apple II output and an MCU-drawn menu (text screen) by
 *     overriding video_control via the SPI register interface.
 */

#include <FreeRTOS.h>
#include "task.h"
#include "usbh_core.h"
#include "usbh_xinput.h"
#include "usbh_hidinput.h"  /* USB keyboard / remote-control menu input */
#include "board.h"
#include "bflb_mtimer.h"

#include "fpga_spi.h"
#include "fpga_screen.h"

#include "lwip/tcpip.h"   /* lwIP for the USB-Ethernet (CDC-ECM) net path */
#include "lwip/netif.h"
#include "lwip/netifapi.h"
#include "lwip/dhcp.h"
#include "lwip/etharp.h"
#include "usbh_cdc_ecm.h"
#include "usbh_rtl8152.h"   /* stock vendor driver for the RTL8152 adapter */
#include "usbh_asix.h"      /* stock vendor driver for ASIX AX88772x adapters */
#include "w5100.h"          /* emulated W5100 (Uthernet II) MACRAW bridge */
#include "disk.h"           /* Disk II image serving (track-on-demand) */
#include "boot_timeline.h"  /* boot-milestone timeline (FPGA sys_time capture) */

/* True once the early slot-map apply (below, in main()) has been confirmed by
 * readback and strobed -- disk_poll's mount-time slot programming then skips
 * its (re-)apply so the slotmaker is never re-strobed while the Apple runs. */
bool g_slots_applied_early = false;
#include "diskio_host.h"    /* SD/USB FatFS backend (g_msc_class) */
#include "usbh_msc.h"       /* USB Mass Storage host class */
#include "osd_console.h"    /* shared boot/status console */
#include "settings.h"       /* persisted preferences (flash) */
#include "menu.h"
#include "telnetd.h"
#include "sscbridge.h"
#include "ftpd.h"           /* gamepad menu system */

struct netif;
static void net_apply_static(struct netif *nif);   /* defined below */
#include <string.h>

/* lwIP's LWIP_RAND() calls bl_rand() (normally from the SDK wifi/RF component,
 * which we don't pull in). It's used for DHCP xids / initial sequence numbers /
 * local-port randomization — not crypto — so an xorshift PRNG is fine. */
int bl_rand(void)
{
    static uint32_t s = 0;
    if (s == 0) {
        s = (uint32_t)bflb_mtimer_get_time_us() | 1u;
    }
    s ^= s << 13;
    s ^= s >> 17;
    s ^= s << 5;
    return (int)(s & 0x7fffffff);
}

/* video_control register map (see BL616_SPI_PROTOCOL.md / bl616_spi_connector.sv) */
#define REG_VIDEO_ENABLE 0x10
#define REG_TEXT_MODE    0x11
#define REG_A2BUS_READY  0x30
#define REG_CARDROM_REL  0x31

/* --- DebugOverlay status channel ---------------------------------------
 * These MCU scratch regs are wired into the HDMI DebugOverlay in top.sv:
 *   hex[0]=stage  hex[1]=btn-lo  hex[2]=btn-hi  hex[3]=counter  hex[4]=flags
 *   bit-row0 = {flags[5:0], standalone, mcu_ready}   bit-row1 = btn-lo
 * So everything below shows up on screen over the Apple II output, in any
 * USB role, with no serial console needed. */
#define DBG_STAGE   0x07  /* scratch0 */
#define DBG_BTN_LO  0x0C  /* scratch1 */
#define DBG_BTN_HI  0x0D  /* scratch2 */
#define DBG_COUNTER 0x0E  /* scratch3 (heartbeat) */
#define DBG_FLAGS   0x0F  /* scratch4 */

/* DBG_FLAGS bits */
#define F_SPI_INIT   (1u << 0)
#define F_FPGA_READY (1u << 1)
#define F_USBH_INIT  (1u << 2)
#define F_THREAD_UP  (1u << 3)
#define F_CONNECTED  (1u << 4)
#define F_HEARTBEAT  (1u << 5)

/* Stage codes (DBG_STAGE) */
#define STG_SPI_INIT   0x10
#define STG_FPGA_READY 0x20
#define STG_PRE_USB    0x30
#define STG_USBH_INIT  0x40
#define STG_SCHED      0x50
#define STG_SEARCH     0xA0
#define STG_CONNECTED  0xC0
#define STG_REPORT     0xD0

/* EHCI host-controller registers (CherryUSB maps HCOR here for bl616).
 * PORTSC[0] tells us if the controller electrically sees a device on the port:
 *   bit0 CCS (connect status), bit1 CSC, bit2 PE, bits10-11 line status,
 *   bit12 PP (port power). USBSTS bit2 = port-change-detect. */
#ifndef CONFIG_USB_EHCI_HCOR_BASE
#define CONFIG_USB_EHCI_HCOR_BASE (0x20072000 + 0x10)
#endif
#define EHCI_USBSTS  (*(volatile uint32_t *)(CONFIG_USB_EHCI_HCOR_BASE + 0x04))
#define EHCI_PORTSC0 (*(volatile uint32_t *)(CONFIG_USB_EHCI_HCOR_BASE + 0x44))

static volatile uint8_t g_flags = 0;
static volatile uint8_t g_counter = 0;
/* Set by the connect callback for EVERY new controller; the poll thread (re)runs
 * the init when it sees this. A flag (not pointer identity) because a freed class
 * struct's address gets reused — so a new pad can look "same" by pointer. */
static volatile bool g_need_init = false;
/* True while a USB-Ethernet (CDC-ECM) device owns the DebugOverlay (it reports
 * the DHCP IP on the same scratch regs). When set, the xinput poll thread stops
 * writing its "searching" status so the two don't fight over the overlay. */
static volatile bool g_net_active = false;

static inline void dbg_stage(uint8_t s) { fpga_spi_reg_write(DBG_STAGE, s); }
static inline void dbg_set(uint8_t f)   { g_flags |= f;  fpga_spi_reg_write(DBG_FLAGS, g_flags); }
static inline void dbg_clr(uint8_t f)   { g_flags &= ~f; fpga_spi_reg_write(DBG_FLAGS, g_flags); }
/* Heartbeat: bump the counter + toggle the heartbeat bit so a live loop is
 * visibly distinguishable from a hung one on screen. */
static inline void dbg_tick(void)
{
    fpga_spi_reg_write(DBG_COUNTER, ++g_counter);
    g_flags ^= F_HEARTBEAT;
    fpga_spi_reg_write(DBG_FLAGS, g_flags);
}

/* FreeRTOS fatal-error hooks (override the SDK's weak printf-only versions).
 * Paint a distinctive marker on the DebugOverlay then halt, so a heap/stack
 * exhaustion shows a cause instead of a silent freeze. Interrupts are disabled
 * first, so the lock-free raw SPI write is safe even if the faulting task held
 * the SPI mutex. Markers: byte0/byte4 = 0xED (dead); byte1 = E1 malloc / E2
 * stack; for stack, byte2:byte3 = first two chars of the faulting task name. */
void vApplicationMallocFailedHook(void)
{
    taskDISABLE_INTERRUPTS();
    fpga_spi_reg_write_raw(0x07, 0xED);
    fpga_spi_reg_write_raw(0x0C, 0xE1);   /* E1 = heap/malloc exhausted */
    fpga_spi_reg_write_raw(0x0D, 0xE1);
    fpga_spi_reg_write_raw(0x0E, 0xE1);
    fpga_spi_reg_write_raw(0x0F, 0xED);
    for (;;) {}
}

void vApplicationStackOverflowHook(TaskHandle_t xTask, char *pcTaskName)
{
    (void)xTask;
    char c0 = pcTaskName ? pcTaskName[0] : '?';
    char c1 = pcTaskName ? pcTaskName[1] : '?';
    taskDISABLE_INTERRUPTS();
    fpga_spi_reg_write_raw(0x07, 0xED);
    fpga_spi_reg_write_raw(0x0C, 0xE2);
    fpga_spi_reg_write_raw(0x0D, (uint8_t)c0);
    fpga_spi_reg_write_raw(0x0E, (uint8_t)c1);
    fpga_spi_reg_write_raw(0x0F, 0xED);
    for (;;) {}
}

/* Intercept the SDK's exception_entry via linker --wrap (see CMakeLists). The SDK
 * version only printf's the fault to a UART we can't see; paint it on the overlay:
 *   byte0=0xEF, byte1=mcause (exception code: 5=load-fault, 7=store-fault,
 *   2=illegal-instr, ...), byte2:byte3:byte4 = mepc[23:16],[15:8],[7:0].
 * If the overlay shows EF... a hard fault was caught and mepc locates it; if it
 * stays frozen with NO EF, it's a hang (SPI poll / deadlock), not a CPU fault. */
void __wrap_exception_entry(uintptr_t *regs)
{
    (void)regs;
    unsigned long mcause, mepc;
    __asm__ volatile ("csrr %0, mcause" : "=r"(mcause));
    __asm__ volatile ("csrr %0, mepc"   : "=r"(mepc));
    __asm__ volatile ("csrci mstatus, 8");   /* clear MIE: stop other contexts */
    fpga_spi_reg_write_raw(0x07, 0xEF);
    fpga_spi_reg_write_raw(0x0C, (uint8_t)mcause);
    fpga_spi_reg_write_raw(0x0D, (uint8_t)(mepc >> 16));
    fpga_spi_reg_write_raw(0x0E, (uint8_t)(mepc >> 8));
    fpga_spi_reg_write_raw(0x0F, (uint8_t)mepc);
    for (;;) {}
}

USB_NOCACHE_RAM_SECTION USB_MEM_ALIGNX uint8_t g_xinput_buf[64];
USB_NOCACHE_RAM_SECTION USB_MEM_ALIGNX uint8_t g_xinput_out[8];
USB_NOCACHE_RAM_SECTION USB_MEM_ALIGNX uint8_t g_xinput_ctrl[64];

/* Full XInput start sequence, ported from the proven BL616 implementation in
 * nand2mario/firmware-bl616 + MiSTle-Dev/FPGA-Companion (usb_gamepad.cpp).
 * The two GET_STRING_DESCRIPTOR reads are the piece we were missing — the comment
 * there literally says "SN30pro needs this". Order: 4 control transfers, then 4
 * interrupt-OUT packets, THEN the IN loop is armed (control xfers must not race a
 * pending IN URB). Returns the result of the first vendor control transfer. */
static const struct {
    uint8_t bmRequestType, bRequest;
    uint16_t wValue, wIndex, wLength;
} k_xbox_init_ctrl[4] = {
    {0x80, 0x06, 0x0302, 0x0409, 2},   /* GET_STRING_DESCRIPTOR (SN30 Pro needs this) */
    {0x80, 0x06, 0x0302, 0x0409, 32},  /* GET_STRING_DESCRIPTOR */
    {0xC1, 0x01, 0x0100, 0x0000, 20},  /* vendor control 1 (many pads need this) */
    {0xC1, 0x01, 0x0000, 0x0000, 8},   /* vendor control 2 */
};
static const uint8_t k_xbox_ep2[4][3] = {
    {0x01, 0x03, 0x02}, {0x02, 0x08, 0x03}, {0x01, 0x03, 0x02}, {0x01, 0x03, 0x06},
};

static int xinput_send_init(struct usbh_xinput *xc)
{
    struct usb_setup_packet *setup = xc->hport->setup;
    int ret = 0;

    /* 1) four control transfers on EP0 (string reads + vendor) */
    for (int i = 0; i < 4; i++) {
        setup->bmRequestType = k_xbox_init_ctrl[i].bmRequestType;
        setup->bRequest      = k_xbox_init_ctrl[i].bRequest;
        setup->wValue        = k_xbox_init_ctrl[i].wValue;
        setup->wIndex        = k_xbox_init_ctrl[i].wIndex;
        setup->wLength       = k_xbox_init_ctrl[i].wLength;
        ret = usbh_control_transfer(xc->hport, setup, g_xinput_ctrl);
    }

    /* 2) four interrupt-OUT packets (LED/rumble) on EP2 */
    if (xc->intout) {
        for (int i = 0; i < 4; i++) {
            memcpy(g_xinput_out, k_xbox_ep2[i], 3);
            usbh_int_urb_fill(&xc->intout_urb, xc->hport, xc->intout, g_xinput_out, 3, 500, NULL, NULL);
            usbh_submit_urb(&xc->intout_urb);
        }
    }
    return ret;
}


/* Called by usbh_xinput.c when a controller enumerates. */
void usbh_xinput_run(struct usbh_xinput *xinput_class)
{
    (void)xinput_class;
    dbg_stage(STG_CONNECTED);
    dbg_set(F_CONNECTED);
    g_need_init = true;   /* tell the poll thread to (re)init this controller */
    osd_log("USB HOST: XINPUT CONTROLLER CONNECTED");
}

void usbh_xinput_stop(struct usbh_xinput *xinput_class)
{
    (void)xinput_class;
    dbg_clr(F_CONNECTED);
}

/* Async interrupt-IN read. Interrupt endpoints NAK until data is ready, and the
 * SDK only ever reads them via this callback pattern (sync reads just time out).
 * Counter ticks per report now, so: MOVING = reports flowing, FROZEN = silent. */
static struct usbh_xinput *g_dev = NULL;
static uint16_t            g_prev_buttons = 0;
/* The URB completion callback runs in HCD/interrupt context, so it must NOT take
 * the SPI mutex (illegal from an ISR -> hang when the mutex is held). It only
 * stashes the latest report here; the xinput THREAD consumes it and does all SPI. */
static volatile uint16_t   g_btn_latest = 0;
static volatile bool       g_btn_fresh  = false;
static volatile int        g_btn_err    = 0;

/* URB completion callback -- runs in HCD/interrupt context. MUST be ISR-safe:
 * NO mutex-taking SPI here (that was the gamepad+Ethernet hang). Just parse the
 * report, stash it for the thread, and re-arm the URB (both ISR-safe). */
static void xinput_in_cb(void *arg, int nbytes)
{
    struct usbh_xinput *xc = (struct usbh_xinput *)arg;
    if (nbytes > 0) {
        struct xinput_state st;
        if (usbh_xinput_parse(g_xinput_buf, nbytes, &st)) {
            g_btn_latest = st.buttons;
            g_btn_fresh  = true;
        }
        if (xc) {
            usbh_submit_urb(&xc->intin_urb);  /* re-arm for the next report */
        }
    } else {
        g_btn_err = nbytes;
        g_dev = NULL;                /* force re-arm on next thread loop */
    }
}

/* Find the first connected XInput controller. The device slot ("/dev/xinputN")
 * isn't always N=0 across hot-plugs (the old slot may not be freed before the
 * new pad enumerates), so scan a few. */
static struct usbh_xinput *xinput_find(void)
{
    for (int m = 0; m < 4; m++) {
        char name[16];
        snprintf(name, sizeof(name), "/dev/xinput%d", m);
        struct usbh_xinput *xc = (struct usbh_xinput *)usbh_find_class_instance(name);
        if (xc) {
            return xc;
        }
    }
    return NULL;
}

static void xinput_thread(void *arg)
{
    (void)arg;

    while (1) {
        struct usbh_xinput *xinput_class = xinput_find();
        if (xinput_class == NULL) {
            /* Not connected. Show EHCI port status: hex[1]=PORTSC low (bit0 CCS),
             * hex[2]=PORTSC high. Only the thread does SPI here. BUT if a CDC-ECM
             * device is active it owns the overlay (DHCP IP), so stay quiet. */
            if (!g_net_active) {
                uint32_t portsc = EHCI_PORTSC0;
                dbg_stage(STG_SEARCH);
                fpga_spi_reg_write(DBG_BTN_LO, (uint8_t)(portsc & 0xFF));
                fpga_spi_reg_write(DBG_BTN_HI, (uint8_t)((portsc >> 8) & 0xFF));
                dbg_tick();              /* heartbeat while searching */
            }
            g_dev = NULL;
            g_prev_buttons = 0;
            /* No pad: still tick the menu at 20 ms so remote input (HID
             * keyboards/remotes, the telnet mirror's menu_inject pulses)
             * works padless. The 500 ms device-scan cadence is preserved
             * by the loop count. */
            for (int t = 0; t < 25; t++) {
                menu_input(usbh_hidinput_buttons());
                usb_osal_msleep(20);
            }
            continue;
        }

        /* (Re)initialize on a fresh connection. Triggered by g_need_init (set by
         * the connect callback for EVERY new pad) OR a changed instance pointer —
         * either alone is unreliable for hot-plug, together they're robust. */
        if (g_need_init || xinput_class != g_dev) {
            g_need_init = false;
            g_dev = xinput_class;
            g_prev_buttons = 0;
            /* Full XInput init (control transfers + EP2 packets) FIRST, then arm
             * the async IN read (control transfers must not race a pending IN). */
            int ir = xinput_send_init(xinput_class);
            fpga_spi_reg_write(DBG_BTN_HI, (uint8_t)(-ir)); /* hex[2] = init result */
            usbh_int_urb_fill(&xinput_class->intin_urb, xinput_class->hport, xinput_class->intin,
                              g_xinput_buf, sizeof(g_xinput_buf), 0, xinput_in_cb, xinput_class);
            usbh_submit_urb(&xinput_class->intin_urb);
        }

        /* Connected: the ISR callback only stashes reports; THIS thread does all
         * SPI (overlay, menu toggle) so the mutex is never taken from interrupt
         * context. Poll the stashed state ~50 Hz. */
        if (g_btn_err) {
            g_btn_err = 0;
            g_dev = NULL;            /* re-arm/re-init on the next loop */
            usb_osal_msleep(50);
            continue;
        }
        if (g_btn_fresh) {
            g_btn_fresh = false;
            dbg_stage(STG_REPORT);
            fpga_spi_reg_write(DBG_BTN_LO, (uint8_t)(g_btn_latest & 0xFF));
            fpga_spi_reg_write(DBG_BTN_HI, (uint8_t)(g_btn_latest >> 8));
            g_prev_buttons = g_btn_latest;
        }
        /* Menu system: edge detection + hold-repeat live inside; feed the
         * current state every tick (repeat needs a time base, not events).
         * HID keyboard/remote buttons ride along in the same word. */
        menu_input(g_btn_latest | usbh_hidinput_buttons());
        dbg_tick();                  /* heartbeat (thread context) */
        usb_osal_msleep(20);
    }
}

/* ===================== USB-Ethernet (CDC-ECM) glue =======================
 * On CherryUSB v1.5.3 we use the STOCK usbh_cdc_ecm.c driver. Our RTL8153 is
 * dual-config (config 1 = Realtek vendor, config 2 = CDC-ECM); v1.5.3 added the
 * weak hook usbh_get_hport_active_config_index(), so we override it to make the
 * core enumerate config 2 for that adapter — then the stock CDC-ECM class
 * matches with no SDK edits and no custom driver. The glue below is just the
 * lwIP netif + DHCP bring-up plus the RX/TX bridge to the stock driver. Once
 * DHCP binds, the leased IP's four octets are written to the overlay hex regs
 * (stage 0xEA) — that on-screen IP is the MVP proof of MCU-on-network. */

#define RTL8153_VID 0x0BDA
#define RTL8153_PID 0x8153

static struct netif g_ecm_netif;

/* Route EVERY device to its DEFAULT config (index 0). For the dual-config
 * RTL8153 that is config 1 = the Realtek VENDOR interface, so the stock
 * usbh_rtl8152 vendor driver claims it (it handles RTL_VER_09) and runs the
 * vendor RX-engine init (rtl_ops.enable) that the generic CDC-ECM path skips.
 * (Previously we forced config 2 = CDC-ECM here; that path never received. We
 * keep the CDC-ECM driver compiled but no longer steer the 8153 to it.) */
uint8_t usbh_get_hport_active_config_index(struct usbh_hubport *hport)
{
    (void)hport;
    return 0;
}

/* ---- EXPERIMENT: async interrupt-IN (notification) + async bulk-IN ----------
 * Neither prior attempt ran this config. The STOCK rx thread blocks forever on a
 * sync interrupt-IN status read (get_connect_status, WAITING_FOREVER) and gates
 * bulk-IN behind it. Our earlier CUSTOM rx omitted the interrupt endpoint
 * entirely. Linux's usbnet keeps a status URB continuously outstanding (async,
 * non-gating) AND submits bulk-IN independently. This mirrors that: arm an async
 * intin read that just re-arms forever, plus an async bulk-IN, neither gating the
 * other. Hypothesis: the RTL8153 ECM won't forward RX until intin is serviced. */
static volatile bool     g_netif_ready = false;
static struct usbh_cdc_ecm *g_ecm = NULL;
static volatile uint32_t g_eth_tx = 0;   /* linkoutput calls */
static volatile uint32_t g_eth_bn = 0;   /* bulk-IN callback fires (any nbytes) */
static volatile uint32_t g_eth_rx = 0;   /* bulk-IN frames with data -> lwIP */
static volatile uint32_t g_eth_nh = 0;   /* interrupt-IN (notification) fires */
static volatile int      g_eth_last = 0; /* last bulk-IN nbytes/err */
static volatile uint8_t  g_nt_code = 0xee; /* last notification bNotificationCode */
static volatile uint16_t g_nt_val  = 0;    /* last notification wValue (link state) */
static volatile int      g_eth_armret = -1; /* return of the bulk-IN submit */
static volatile uint8_t  g_bi_addr = 0, g_bo_addr = 0, g_ii_addr = 0; /* bound EP addrs */
static volatile uint16_t g_bi_mps = 0;     /* bulk-IN max packet size */
static volatile uint8_t  g_data_an = 0;    /* data interface altsetting_num */
static volatile int      g_si_ret = -1;    /* our SET_INTERFACE(data) return */

/* Carrier-gated RX re-arm (Linux usbnet parity). Linux only submits RX URBs
 * AFTER netif_carrier_on(), which fires when the interrupt-IN status reports
 * NETWORK_CONNECTION=connected. CherryUSB arms RX at connect() time, before the
 * notification, and never re-arms. We replicate Linux: defer the first bulk-IN
 * submit until carrier-up, then re-assert SET_INTERFACE(alt) + packet filter and
 * only then queue the read. See agent line-by-line analysis (2026-06-18). */
static volatile bool g_carrier_up   = false; /* set by intin_cb on link-up */
static volatile bool g_rearm_done   = false; /* re-arm performed once */
/* Host bulk-IN data toggle. CherryUSB v1.5.3 stores the toggle per-URB and only
 * advances it on a COMPLETED transfer; SET_INTERFACE resets the DEVICE toggle
 * but not the host's. If they disagree, EHCI silently drops every IN packet and
 * the qTD stays Active forever (bn=0, no error). We own g_eth_bulkin_urb, and
 * usbh_bulk_urb_fill does not clear data_toggle, so we drive it directly and
 * sweep 0<->1 until the first frame lands; after that the HC carries it forward. */
static volatile uint8_t  g_force_toggle = 0; /* host bulk-IN toggle to try next */
static volatile uint32_t g_tog_sweeps   = 0; /* toggle flips attempted */

USB_NOCACHE_RAM_SECTION USB_MEM_ALIGNX uint8_t g_eth_inbuf[1600];
USB_NOCACHE_RAM_SECTION USB_MEM_ALIGNX uint8_t g_eth_ntbuf[16];
static struct usbh_urb g_eth_bulkin_urb;
static struct usbh_urb g_eth_intin_urb;

/* One-line status on the Apple II text screen (persists; not overwritten by the
 * xinput search loop, which only touches the overlay). */
static void eth_status(const char *msg)
{
    osd_log("%s", msg);
}

/* netif->linkoutput: stock TX (works). */
static err_t ecm_linkoutput(struct netif *netif, struct pbuf *p)
{
    (void)netif;
    uint8_t *txbuf = usbh_cdc_ecm_get_eth_txbuf();
    if (txbuf == NULL || p->tot_len > 1514) {
        return ERR_BUF;
    }
    uint8_t *q = txbuf;
    for (struct pbuf *it = p; it != NULL; it = it->next) {
        memcpy(q, it->payload, it->len);
        q += it->len;
    }
    g_eth_tx++;
    return (usbh_cdc_ecm_eth_output(p->tot_len) < 0) ? ERR_IF : ERR_OK;
}

/* Deliver a received frame to lwIP (guarded against pre-netif_add). */
void usbh_cdc_ecm_eth_input(uint8_t *buf, uint32_t buflen)
{
    if (buflen == 0 || !g_netif_ready || g_ecm_netif.input == NULL) {
        return;
    }
    struct pbuf *p = pbuf_alloc(PBUF_RAW, buflen, PBUF_POOL);
    if (p == NULL) {
        return;
    }
    memcpy(p->payload, buf, buflen);
    if (g_ecm_netif.input(p, &g_ecm_netif) != ERR_OK) {
        pbuf_free(p);
    }
}

/* async bulk-IN completion → deliver + re-arm */
static void eth_bulkin_cb(void *arg, int nbytes)
{
    (void)arg;
    g_eth_bn++;
    g_eth_last = nbytes;
    if (nbytes > 0) {
        g_eth_rx++;
        usbh_cdc_ecm_eth_input(g_eth_inbuf, (uint32_t)nbytes);
    }
    if (g_ecm && g_ecm->bulkin) {
        usbh_submit_urb(&g_eth_bulkin_urb);  /* re-arm */
    }
}

/* async interrupt-IN (CDC notification) completion → just count + re-arm, so a
 * status URB stays continuously outstanding like Linux usbnet (non-gating). */
static void eth_intin_cb(void *arg, int nbytes)
{
    (void)arg;
    g_eth_nh++;
    if (nbytes >= 4) {
        /* CDC notification: [1]=bNotificationCode, [2..3]=wValue.
         * NETWORK_CONNECTION(0x00): wValue 1=connected,0=disconnected.
         * CONNECTION_SPEED_CHANGE(0x2A). */
        g_nt_code = g_eth_ntbuf[1];
        g_nt_val  = (uint16_t)g_eth_ntbuf[2] | ((uint16_t)g_eth_ntbuf[3] << 8);
        /* Carrier-up edge: NETWORK_CONNECTION=connected, or a speed-change
         * report (the device only emits 0x2A once the link is live). The report
         * thread does the actual re-arm (control transfers need thread context,
         * not this completion callback). */
        if ((g_nt_code == CDC_ECM_NOTIFY_CODE_NETWORK_CONNECTION && g_nt_val != 0) ||
            g_nt_code == CDC_ECM_NOTIFY_CODE_CONNECTION_SPEED_CHANGE) {
            g_carrier_up = true;
        }
    }
    if (g_ecm && g_ecm->intin) {
        usbh_submit_urb(&g_eth_intin_urb);   /* keep it outstanding */
    }
}

/* Carrier-gated RX arm — the PURE Linux-parity test. Linux usbnet does NOT
 * re-send any control transfers after carrier; cdc_ether sends SET_INTERFACE +
 * SET_ETHERNET_PACKET_FILTER once at bind (we already did, at connect), and the
 * ONLY thing usbnet defers to post-carrier is the RX URB submission. So here we
 * just submit the bulk-IN, nothing else.
 *
 * (Earlier this also re-sent SET_INTERFACE/CLEAR_FEATURE/SET_ETHERNET_PACKET_
 * FILTER after carrier; the device STALLed the filter and clear-halt — f8/h8 —
 * even though the identical filter succeeded at enumeration. Re-issuing those
 * post-carrier corrupts the control endpoint, so they are removed. This isolates
 * the real question: does deferring only the bulk-IN submit to post-carrier make
 * the RTL8153 stream RX?) */
static void eth_rearm_rx_path(void)
{
    struct usbh_cdc_ecm *ecm = g_ecm;
    if (!ecm || !ecm->hport || !ecm->bulkin) {
        return;
    }
    usbh_bulk_urb_fill(&g_eth_bulkin_urb, ecm->hport, ecm->bulkin, g_eth_inbuf,
                       1536, 0 /*async*/, eth_bulkin_cb, NULL);
    g_eth_bulkin_urb.data_toggle = g_force_toggle; /* we own the host toggle */
    g_eth_armret = usbh_submit_urb(&g_eth_bulkin_urb);
    g_rearm_done = true;
}

/* Recover a host/device bulk-IN data-toggle mismatch: kill the stuck (forever-
 * Active) URB, flip the host toggle, and resubmit. Called from the report
 * thread while bn==0; once the first frame lands the HC carries the correct
 * toggle forward via eth_bulkin_cb's re-arm, so we stop sweeping. */
static void eth_toggle_sweep(void)
{
    struct usbh_cdc_ecm *ecm = g_ecm;
    /* Gate on real frames (g_eth_rx), NOT g_eth_bn: usbh_kill_urb itself fires
     * the completion callback with a cancel status, which bumps g_eth_bn — so a
     * bn-based gate would stop the sweep after its own first kill. */
    if (!ecm || !ecm->bulkin || g_eth_rx != 0) return; /* don't disturb a live pipe */
    usbh_kill_urb(&g_eth_bulkin_urb);
    g_force_toggle ^= 1;
    g_tog_sweeps++;
    usbh_bulk_urb_fill(&g_eth_bulkin_urb, ecm->hport, ecm->bulkin, g_eth_inbuf,
                       1536, 0 /*async*/, eth_bulkin_cb, NULL);
    g_eth_bulkin_urb.data_toggle = g_force_toggle;
    g_eth_armret = usbh_submit_urb(&g_eth_bulkin_urb);
}

static err_t ecm_netif_init(struct netif *netif)
{
    struct usbh_cdc_ecm *ecm = (struct usbh_cdc_ecm *)usbh_find_class_instance("/dev/cdc_ether");
    netif->name[0] = 'e';
    netif->name[1] = 'n';
    netif->output = etharp_output;
    netif->linkoutput = ecm_linkoutput;
    netif->mtu = 1500;
    netif->flags = NETIF_FLAG_BROADCAST | NETIF_FLAG_ETHARP;
    netif->hwaddr_len = 6;
    if (ecm) {
        memcpy(netif->hwaddr, ecm->mac, 6);
    }
    return ERR_OK;
}

static void ecm_netif_setup_cb(void *ctx)
{
    (void)ctx;
    ip4_addr_t any;
    ip4_addr_set_zero(&any);
    netif_add(&g_ecm_netif, &any, &any, &any, NULL, ecm_netif_init, tcpip_input);
    netif_set_default(&g_ecm_netif);
    netif_set_up(&g_ecm_netif);
    netif_set_link_up(&g_ecm_netif);
    g_netif_ready = true;
    if (settings()->dhcp_enable)
        dhcp_start(&g_ecm_netif);
    else
        net_apply_static(&g_ecm_netif);
}

/* Surface the DHCP IP once bound; until then show the live traffic counters so we
 * can see whether servicing intin makes bulk-IN start completing. */
static void ecm_ip_report_thread(void *arg)
{
    struct netif *netif = (struct netif *)arg;
    uint32_t last = 0, iter = 0, sweep_div = 0;
    while (1) {
        /* Carrier-gated RX arming (Linux parity): once the link-up notification
         * has arrived, queue the first bulk-IN. */
        if (g_carrier_up && !g_rearm_done) {
            eth_rearm_rx_path();
        } else if (g_rearm_done && g_eth_rx == 0 && g_tog_sweeps < 1) {
            /* Disambiguate toggle-mismatch from a dead bulk-IN WITHOUT the
             * repeated-kill confound (this EHCI's async kill/re-arm path is
             * fragile). Leave toggle 0 armed and UNTOUCHED for ~5s; if still no
             * real frame, do EXACTLY ONE flip to toggle 1 and then leave that
             * armed indefinitely (g_tog_sweeps<1 gate => no further kills). So:
             * toggle0 for 5s, then toggle1 forever. If neither delivers real
             * data (l stays <=0), it is NOT a toggle issue. */
            if (++sweep_div >= 10) { sweep_div = 0; eth_toggle_sweep(); }
        }
        uint32_t ip = netif_ip4_addr(netif)->addr;
        if (ip != 0) {
            if (ip != last) {
                last = ip;
                const uint8_t *o = (const uint8_t *)&ip;
                char line[24];
                snprintf(line, sizeof(line), "ETH IP %u.%u.%u.%u", o[0], o[1], o[2], o[3]);
                eth_status(line);
            }
        } else {
            char line[40];
            /* tg=host bulk-IN toggle  sw=toggle flips  bn=completions (incl.
             * kill-cancels)  rx=real frames  l=last nbytes (<0 err/cancel, 0 ZLP,
             * >0 data) */
            snprintf(line, sizeof(line), "tg%d sw%lu bn%lu rx%lu l%d",
                     g_force_toggle, (unsigned long)g_tog_sweeps,
                     (unsigned long)g_eth_bn, (unsigned long)g_eth_rx, g_eth_last);
            eth_status(line);
            fpga_spi_reg_write(DBG_COUNTER, (uint8_t)(++iter)); /* heartbeat */
        }
        usb_osal_msleep(500);
    }
}

void usbh_cdc_ecm_run(struct usbh_cdc_ecm *ecm)
{
    g_ecm = ecm;
    g_eth_tx = g_eth_bn = g_eth_rx = g_eth_nh = 0;
    if (ecm) {
        ecm->connect_status = true;   /* unblock stock TX; do NOT gate RX on it */
        if (ecm->bulkin)  { g_bi_addr = ecm->bulkin->bEndpointAddress;  g_bi_mps = ecm->bulkin->wMaxPacketSize; }
        if (ecm->bulkout) { g_bo_addr = ecm->bulkout->bEndpointAddress; }
        if (ecm->intin)   { g_ii_addr = ecm->intin->bEndpointAddress; }

        /* THE FIX: explicitly SET_INTERFACE the data interface to arm the RX
         * datapath. Stock connect() skips SET_INTERFACE when the data interface
         * has a single altsetting; Linux's usbnet issues it unconditionally
         * ("traffic can't flow until an altsetting is enabled"). Do an
         * alt0->alt_enabled cycle (degenerates to SET_INTERFACE(0) for a single
         * altsetting), BEFORE arming the bulk-IN so the toggle is fresh. */
        g_data_an = ecm->hport->config.intf[ecm->data_intf].altsetting_num;
        uint8_t data_alt = (g_data_an > 1) ? (g_data_an - 1) : 0;
        if (g_data_an > 1) {
            usbh_set_interface(ecm->hport, ecm->data_intf, 0);
        }
        g_si_ret = usbh_set_interface(ecm->hport, ecm->data_intf, data_alt);
    }
    g_net_active = true;
    tcpip_callback(ecm_netif_setup_cb, NULL);

    /* Arm ONLY the interrupt-IN status read now. The bulk-IN read is deferred to
     * eth_rearm_rx_path(), triggered from the report thread once intin reports
     * carrier-up — this is the whole point of the experiment (Linux submits RX
     * only post-carrier). Reset the carrier/re-arm latches for this device. */
    g_carrier_up = false;
    g_rearm_done = false;
    g_eth_armret = -1;
    if (ecm && ecm->intin) {
        usbh_int_urb_fill(&g_eth_intin_urb, ecm->hport, ecm->intin, g_eth_ntbuf,
                          16, 0 /*async*/, eth_intin_cb, NULL);
        usbh_submit_urb(&g_eth_intin_urb);
    }

    usb_osal_thread_create("ecm_ip", 1024, CONFIG_USBHOST_PSC_PRIO + 1,
                           ecm_ip_report_thread, &g_ecm_netif);
}

void usbh_cdc_ecm_stop(struct usbh_cdc_ecm *ecm)
{
    (void)ecm;
    g_net_active = false;
    g_netif_ready = false;
    g_ecm = NULL;   /* stop callbacks from re-arming */
    netif_set_down(&g_ecm_netif);
    dhcp_stop(&g_ecm_netif);
}

/* ===================== USB-Ethernet (RTL8152) glue ========================
 * The stock CherryUSB usbh_rtl8152.c vendor driver owns enumeration, the vendor
 * RX-engine init (rtl_ops.enable), RX-mode/speed, and its OWN rx_thread that
 * reads bulk-IN, strips the rx_desc headers, and calls usbh_rtl8152_eth_input()
 * per frame. So our glue is only: lwIP netif + DHCP, the eth_input->lwIP bridge,
 * TX via the driver's tx buffer, and spawning the driver's rx_thread. This is
 * the SUPPORTED path (contrast the hand-rolled CDC-ECM RX above). */
static struct netif      g_rtl_netif;
static struct usbh_rtl8152 *g_rtl = NULL;
static volatile uint32_t g_rtl_rx = 0;   /* frames delivered to lwIP */
static volatile uint32_t g_rtl_tx = 0;   /* frames sent via linkoutput */

/* RX: the driver's rx_thread calls this once per received Ethernet frame.
 * NOTE: this needs a non-zero lwIP pbuf pool — see CMakeLists.txt
 * (PBUF_POOL_SIZE defaults to 0 in the SDK lwipopts, which silently drops
 * every RX frame here). */
void usbh_rtl8152_eth_input(uint8_t *buf, uint32_t buflen)
{
    /* Bridge mode: once the Apple II has opened a MACRAW socket, all wire frames
     * belong to it (it runs its own stack). Hand them to the W5100 RX ring and do
     * NOT deliver to the BL616's own lwIP. */
    if (w5100_macraw_active()) {
        w5100_macraw_rx(buf, buflen);
        return;
    }
    if (buflen == 0 || !g_netif_ready || g_rtl_netif.input == NULL) {
        return;
    }
    struct pbuf *p = pbuf_alloc(PBUF_RAW, buflen, PBUF_POOL);
    if (p == NULL) {
        return;
    }
    pbuf_take(p, buf, buflen);
    g_rtl_rx++;
    if (g_rtl_netif.input(p, &g_rtl_netif) != ERR_OK) {
        pbuf_free(p);
    }
}

/* TX: copy the pbuf into the driver's tx buffer (after its tx_desc) and send. */
static err_t rtl_linkoutput(struct netif *netif, struct pbuf *p)
{
    (void)netif;
    uint8_t *txbuf = usbh_rtl8152_get_eth_txbuf();
    if (txbuf == NULL) {
        return ERR_IF;
    }
    pbuf_copy_partial(p, txbuf, p->tot_len, 0);
    g_rtl_tx++;
    return (usbh_rtl8152_eth_output(p->tot_len) < 0) ? ERR_IF : ERR_OK;
}

static err_t rtl_netif_init(struct netif *netif)
{
    struct usbh_rtl8152 *r = (struct usbh_rtl8152 *)usbh_find_class_instance("/dev/rtl8152");
    netif->name[0] = 'e';
    netif->name[1] = 'n';
    netif->output = etharp_output;
    netif->linkoutput = rtl_linkoutput;
    netif->mtu = 1500;
    netif->flags = NETIF_FLAG_BROADCAST | NETIF_FLAG_ETHARP;
    netif->hwaddr_len = 6;
    if (r) {
        memcpy(netif->hwaddr, r->mac, 6);
    }
    return ERR_OK;
}

static void rtl_netif_setup_cb(void *ctx)
{
    (void)ctx;
    ip4_addr_t any;
    ip4_addr_set_zero(&any);
    netif_add(&g_rtl_netif, &any, &any, &any, NULL, rtl_netif_init, tcpip_input);
    netif_set_default(&g_rtl_netif);
    netif_set_up(&g_rtl_netif);
    netif_set_link_up(&g_rtl_netif);
    g_netif_ready = true;
    if (settings()->dhcp_enable)
        dhcp_start(&g_rtl_netif);
    else
        net_apply_static(&g_rtl_netif);
}

/* Shared USB-Ethernet status overlay (used by every adapter's glue). Spawned by
 * a driver's run(); renders a clean status (link / rx / tx / IP) and exits +
 * self-deletes on disconnect (g_net_active) so a re-plug spawns exactly one
 * fresh reporter instead of accumulating threads that fight over the screen. */
typedef bool (*eth_link_fn)(void);
static void eth_report_thread(struct netif *netif, const char *chip,
                              const volatile uint32_t *rxp,
                              const volatile uint32_t *txp,
                              eth_link_fn link_up)
{
    /* Log only on STATE CHANGES (device found, link up/down, DHCP IP) — no
     * continuous repaint, no permanent screen ownership. rx/tx counters are
     * dropped from the log (they are continuous, not state changes). */
    bool prev_link = false, link_announced = false;
    uint32_t prev_ip = 0, iter = 0;

    osd_log("USB ETHERNET: DEVICE FOUND (%s)", chip);

    while (g_net_active) {
        bool lk = link_up();
        if (!link_announced || lk != prev_link) {
            osd_log("USB ETHERNET: LINK %s", lk ? "UP" : "DOWN");
            prev_link = lk;
            link_announced = true;
        }
        uint32_t ip = netif_ip4_addr(netif)->addr;
        if (ip != prev_ip) {
            const uint8_t *o = (const uint8_t *)&ip;
            if (ip != 0) {
                osd_log("USB ETHERNET: IP %u.%u.%u.%u", o[0], o[1], o[2], o[3]);
            } else {
                osd_log("USB ETHERNET: REQUESTING IP (DHCP)...");
            }
            prev_ip = ip;
        }
        fpga_spi_reg_write(DBG_COUNTER, (uint8_t)(++iter)); /* heartbeat */
        usb_osal_msleep(250);
    }
    (void)rxp; (void)txp;
    usb_osal_thread_delete(NULL);
}

static bool rtl_link_up(void) { return g_rtl && g_rtl->connect_status; }
static void rtl_ip_report_thread(void *arg)
{
    eth_report_thread((struct netif *)arg, "RTL8152", &g_rtl_rx, &g_rtl_tx, rtl_link_up);
}

void usbh_rtl8152_run(struct usbh_rtl8152 *class)
{
    g_rtl = class;
    g_rtl_rx = 0;
    g_net_active = true;
    tcpip_callback(rtl_netif_setup_cb, NULL);
    /* The driver's rx_thread does connect-wait, rtl_ops.enable, and the bulk-IN
     * RX loop; spawn it once here (it self-deletes on disconnect). */
    usb_osal_thread_create("rtl_rx", 3072, CONFIG_USBHOST_PSC_PRIO + 1,
                           usbh_rtl8152_rx_thread, NULL);
    usb_osal_thread_create("rtl_ip", 2048, CONFIG_USBHOST_PSC_PRIO + 1,
                           rtl_ip_report_thread, &g_rtl_netif);
}

/* netif teardown must run on the tcpip thread (lwIP isn't reentrant). netif_remove
 * is essential: without it, a re-plug calls netif_add on an already-added netif
 * (lwIP list corruption) -> hot-plug back to the adapter fails. */
static void rtl_netif_teardown_cb(void *ctx)
{
    (void)ctx;
    dhcp_stop(&g_rtl_netif);
    netif_remove(&g_rtl_netif);
}

void usbh_rtl8152_stop(struct usbh_rtl8152 *class)
{
    (void)class;
    g_net_active = false;   /* report thread sees this and self-deletes */
    g_netif_ready = false;  /* eth_input drops any in-flight frames */
    g_rtl = NULL;
    tcpip_callback(rtl_netif_teardown_cb, NULL);
}

/* ===================== Uthernet II (W5100) MACRAW bridge ====================
 * The Apple II runs its own TCP/IP stack (IP65, etc.) over the emulated W5100 in
 * MACRAW mode and appears on the LAN with its own MAC/IP. We bridge its frames
 * at layer 2 to the RTL8152 adapter:
 *   - TX: w5100.c hands us a complete Ethernet frame -> send it verbatim.
 *   - RX: usbh_rtl8152_eth_input() routes wire frames to w5100_macraw_rx().
 * Receiving frames for the Apple II's MAC requires the adapter in promiscuous
 * mode (its own MAC filter would drop them). The stock driver doesn't export a
 * promiscuous API, so we do the one OCP register write (PLA_RCR |= AAP) here via
 * a control transfer, replicating the driver's generic_ocp_write path. Keeps the
 * SDK pristine.
 *
 * !! HARDWARE-VALIDATION PENDING: the promiscuous OCP write and the end-to-end
 * bridge have not yet been exercised on real hardware. !!
 */
#define RTL8152_REQ_REGS  0x05
#define RTL8152_PLA_RCR   0xc010
#define RTL8152_MCU_PLA   0x0100
#define RTL8152_BYTE_EN_DWORD 0x00ff
#define RTL8152_RCR_AAP   0x00000001   /* accept all physical (promiscuous) */

static USB_NOCACHE_RAM_SECTION USB_MEM_ALIGNX uint8_t g_ocp_buf[8];

/* Read-modify-write PLA_RCR to add the Accept-All-Physical (promiscuous) bit.
 * Mirrors ocp_read_dword/ocp_write_dword in usbh_rtl8152.c:
 *   read : GET_REGS  wValue=index  wIndex=MCU_PLA            wLength=4
 *   write: SET_REGS  wValue=index  wIndex=MCU_PLA|BYTE_EN    wLength=4   */
static int rtl8152_set_promiscuous(struct usbh_rtl8152 *r)
{
    if (!r || !r->hport) return -1;
    struct usb_setup_packet *setup = r->hport->setup;

    setup->bmRequestType = USB_REQUEST_DIR_IN | USB_REQUEST_VENDOR | USB_REQUEST_RECIPIENT_DEVICE;
    setup->bRequest = RTL8152_REQ_REGS;
    setup->wValue   = RTL8152_PLA_RCR;
    setup->wIndex   = RTL8152_MCU_PLA;
    setup->wLength  = 4;
    int ret = usbh_control_transfer(r->hport, setup, g_ocp_buf);
    if (ret < 0) return ret;

    uint32_t rcr = (uint32_t)g_ocp_buf[0] | ((uint32_t)g_ocp_buf[1] << 8) |
                   ((uint32_t)g_ocp_buf[2] << 16) | ((uint32_t)g_ocp_buf[3] << 24);
    rcr |= RTL8152_RCR_AAP;
    g_ocp_buf[0] = (uint8_t)rcr;        g_ocp_buf[1] = (uint8_t)(rcr >> 8);
    g_ocp_buf[2] = (uint8_t)(rcr >> 16); g_ocp_buf[3] = (uint8_t)(rcr >> 24);

    setup->bmRequestType = USB_REQUEST_DIR_OUT | USB_REQUEST_VENDOR | USB_REQUEST_RECIPIENT_DEVICE;
    setup->bRequest = RTL8152_REQ_REGS;
    setup->wValue   = RTL8152_PLA_RCR;
    setup->wIndex   = RTL8152_MCU_PLA | RTL8152_BYTE_EN_DWORD;
    setup->wLength  = 4;
    return usbh_control_transfer(r->hport, setup, g_ocp_buf);
}

/* The stock driver's MAC-set routine (non-static): CRWECR config-unlock -> PLA_IDR
 * -> relock. We call it to make the dongle adopt the Apple II's MAC. */
extern int r8152_write_hwaddr(struct usbh_rtl8152 *tp, unsigned char *mac);

/* ---- w5100.c weak-hook overrides ---- */
void w5100_bridge_tx(const uint8_t *frame, uint32_t len)
{
    if (!g_rtl || len == 0) return;
    uint8_t *tx = usbh_rtl8152_get_eth_txbuf();
    if (!tx) return;
    memcpy(tx, frame, len);
    usbh_rtl8152_eth_output(len);
}

/* Dongle MAC -- valid only once the adapter has enumerated (driver fills r->mac
 * during its enable step, after run()), so report "not ready" while it is zero. */
bool w5100_bridge_dongle_mac(uint8_t mac[6])
{
    if (!g_rtl) return false;
    if ((g_rtl->mac[0] | g_rtl->mac[1] | g_rtl->mac[2] |
         g_rtl->mac[3] | g_rtl->mac[4] | g_rtl->mac[5]) == 0)
        return false;
    memcpy(mac, g_rtl->mac, 6);
    return true;
}

/* Primary path: program the dongle's hardware MAC = the Apple II's SHAR. */
void w5100_bridge_set_dongle_mac(const uint8_t mac[6])
{
    if (g_rtl) r8152_write_hwaddr(g_rtl, (unsigned char *)mac);
}

/* Fallback path (W5100_BRIDGE_FORCE_PROMISC): accept all frames instead. */
void w5100_bridge_set_promiscuous(void)
{
    if (g_rtl) rtl8152_set_promiscuous(g_rtl);
}

/* W5100 service task: poll the command doorbell and run the MACRAW engine. */
static void w5100_thread(void *arg)
{
    (void)arg;
    w5100_init();
    for (;;) {
        w5100_poll();
        vTaskDelay(pdMS_TO_TICKS(1));
    }
}

/* USB Mass Storage connect/disconnect hooks (override CherryUSB's weak stubs,
 * same pattern as XInput). On attach, run SCSI init and point the FatFS USB
 * backend at this device; on removal, clear it. Either way ask the disk task to
 * re-mount so it prefers the stick when present, else falls back to SD. */
void usbh_msc_run(struct usbh_msc *msc_class)
{
    usbh_msc_scsi_init(msc_class);
    g_msc_class = msc_class;
    osd_log("DISK II: USB STORAGE CONNECTED");
    disk_request_remount();
}

void usbh_msc_stop(struct usbh_msc *msc_class)
{
    (void)msc_class;
    g_msc_class = NULL;
    disk_request_remount();
}

/* Disk II service task: mount storage (USB stick or SD) and serve
 * track-on-demand requests from the FPGA Disk II controller. */
static void disk_thread(void *arg)
{
    (void)arg;
    disk_init();
    for (;;) {
        disk_poll();
        vTaskDelay(pdMS_TO_TICKS(2));
    }
}

/* ===================== USB-Ethernet (ASIX AX88772x) glue ====================
 * Same pattern as the RTL8152 glue above, against the stock CherryUSB usbh_asix
 * vendor driver (AX88772 / 772A / 772B). Both drivers are enabled and coexist —
 * whichever adapter is plugged in, only its own run()/stop() fires (one Ethernet
 * adapter at a time; g_net_active / g_netif_ready are shared). Uses the same
 * pbuf pool (CMakeLists -DPBUF_POOL_SIZE) — that fix applies to all adapters. */
static struct netif      g_asix_netif;
static struct usbh_asix  *g_asix = NULL;
static volatile uint32_t g_asix_rx = 0;   /* frames delivered to lwIP */
static volatile uint32_t g_asix_tx = 0;   /* frames sent via linkoutput */

void usbh_asix_eth_input(uint8_t *buf, uint32_t buflen)
{
    if (buflen == 0 || !g_netif_ready || g_asix_netif.input == NULL) {
        return;
    }
    struct pbuf *p = pbuf_alloc(PBUF_RAW, buflen, PBUF_POOL);
    if (p == NULL) {
        return;
    }
    pbuf_take(p, buf, buflen);
    g_asix_rx++;
    if (g_asix_netif.input(p, &g_asix_netif) != ERR_OK) {
        pbuf_free(p);
    }
}

static err_t asix_linkoutput(struct netif *netif, struct pbuf *p)
{
    (void)netif;
    uint8_t *txbuf = usbh_asix_get_eth_txbuf();
    if (txbuf == NULL) {
        return ERR_IF;
    }
    pbuf_copy_partial(p, txbuf, p->tot_len, 0);
    g_asix_tx++;
    return (usbh_asix_eth_output(p->tot_len) < 0) ? ERR_IF : ERR_OK;
}

static err_t asix_netif_init(struct netif *netif)
{
    struct usbh_asix *a = (struct usbh_asix *)usbh_find_class_instance("/dev/asix");
    netif->name[0] = 'e';
    netif->name[1] = 'n';
    netif->output = etharp_output;
    netif->linkoutput = asix_linkoutput;
    netif->mtu = 1500;
    netif->flags = NETIF_FLAG_BROADCAST | NETIF_FLAG_ETHARP;
    netif->hwaddr_len = 6;
    if (a) {
        memcpy(netif->hwaddr, a->mac, 6);
    }
    return ERR_OK;
}

static void asix_netif_setup_cb(void *ctx)
{
    (void)ctx;
    ip4_addr_t any;
    ip4_addr_set_zero(&any);
    netif_add(&g_asix_netif, &any, &any, &any, NULL, asix_netif_init, tcpip_input);
    netif_set_default(&g_asix_netif);
    netif_set_up(&g_asix_netif);
    netif_set_link_up(&g_asix_netif);
    g_netif_ready = true;
    if (settings()->dhcp_enable)
        dhcp_start(&g_asix_netif);
    else
        net_apply_static(&g_asix_netif);
}

static void asix_netif_teardown_cb(void *ctx)
{
    (void)ctx;
    dhcp_stop(&g_asix_netif);
    netif_remove(&g_asix_netif);
}

static bool asix_link_up(void) { return g_asix && g_asix->connect_status; }
static void asix_ip_report_thread(void *arg)
{
    eth_report_thread((struct netif *)arg, "ASIX", &g_asix_rx, &g_asix_tx, asix_link_up);
}

void usbh_asix_run(struct usbh_asix *class)
{
    g_asix = class;
    g_asix_rx = 0;
    g_net_active = true;
    tcpip_callback(asix_netif_setup_cb, NULL);
    usb_osal_thread_create("asix_rx", 3072, CONFIG_USBHOST_PSC_PRIO + 1,
                           usbh_asix_rx_thread, NULL);
    usb_osal_thread_create("asix_ip", 2048, CONFIG_USBHOST_PSC_PRIO + 1,
                           asix_ip_report_thread, &g_asix_netif);
}

void usbh_asix_stop(struct usbh_asix *class)
{
    (void)class;
    g_net_active = false;
    g_netif_ready = false;
    g_asix = NULL;
    tcpip_callback(asix_netif_teardown_cb, NULL);
}

/* Apply the static address from settings to a netif (DHCP off). A zero IP
 * means "not configured" and leaves the interface unaddressed. */
static void net_apply_static(struct netif *nif)
{
    const a2_settings_t *st = settings();
    if (!nif)
        return;
    if (!(st->static_ip[0] | st->static_ip[1] |
          st->static_ip[2] | st->static_ip[3]))
        return;
    ip4_addr_t ip, mask, gw;
    IP4_ADDR(&ip,   st->static_ip[0],   st->static_ip[1],
                    st->static_ip[2],   st->static_ip[3]);
    IP4_ADDR(&mask, st->static_mask[0], st->static_mask[1],
                    st->static_mask[2], st->static_mask[3]);
    IP4_ADDR(&gw,   st->static_gw[0],   st->static_gw[1],
                    st->static_gw[2],   st->static_gw[3]);
    netifapi_netif_set_addr(nif, &ip, &mask, &gw);
}

/* Menu hook: apply DHCP/static settings to the live default interface. */
void menu_hook_net_apply(void)
{
    struct netif *nif = netif_default;
    if (!nif)
        return;
    if (settings()->dhcp_enable) {
        netifapi_dhcp_start(nif);
    } else {
        netifapi_dhcp_stop(nif);
        net_apply_static(nif);
    }
}

/* Network status lines for the menu (see menu.h). Uses the default netif. */
int menu_hook_net_lines(char lines[][41], int max)
{
    int n = 0;
    struct netif *nif = netif_default;
    if (n < max) {
        if (!nif) {
            snprintf(lines[n++], 41, "NO NETWORK INTERFACE");
            return n;
        }
        snprintf(lines[n++], 41, "LINK %s  (%c%c%d)",
                 netif_is_link_up(nif) ? "UP" : "DOWN",
                 nif->name[0], nif->name[1], nif->num);
    }
    char a[16];
    if (n < max) {
        ip4addr_ntoa_r(netif_ip4_addr(nif), a, sizeof(a));
        snprintf(lines[n++], 41, "IP   %s", a);
    }
    if (n < max) {
        ip4addr_ntoa_r(netif_ip4_netmask(nif), a, sizeof(a));
        snprintf(lines[n++], 41, "MASK %s", a);
    }
    if (n < max) {
        ip4addr_ntoa_r(netif_ip4_gw(nif), a, sizeof(a));
        snprintf(lines[n++], 41, "GW   %s", a);
    }
    if (n < max) {
        snprintf(lines[n++], 41, "MAC  %02X:%02X:%02X:%02X:%02X:%02X",
                 nif->hwaddr[0], nif->hwaddr[1], nif->hwaddr[2],
                 nif->hwaddr[3], nif->hwaddr[4], nif->hwaddr[5]);
    }
    return n;
}

int main(void)
{
    board_init();

    /* SPI link to the FPGA works regardless of USB role. */
    fpga_spi_init();
    dbg_stage(STG_SPI_INIT);
    dbg_set(F_SPI_INIT);

    bool ready = fpga_spi_wait_ready(2000);
    dbg_stage(STG_FPGA_READY);
    if (ready) dbg_set(F_FPGA_READY);
    bt_mark(BT_FPGA_READY);   /* config + SDRAM ready: FPGA-facing work can begin */

    /* Assert bus-ready NOW, as early as possible: this lets apple_bus run
     * its bridge init and grab the Apple II's RESET (hold-until-mounted).
     * With the mcu_ready latch fixed on the FPGA side, the standalone
     * fallback no longer asserts this for us — an MCU that never writes
     * 0x30 would leave the Apple bus interface parked. Ready means "grab
     * the bus now"; the mount-gated 0x2E release means "boot for real". */
    fpga_spi_reg_write(REG_A2BUS_READY, 1);
    bt_mark(BT_A2BUS_READY);   /* FPGA now grabs+holds the Apple II /RES */

    /* Persisted preferences, then the gamepad menu that edits them. */
    settings_init();
    menu_init();

    {
        char dbg[41];
        settings_debug_line(dbg, sizeof(dbg));
        osd_log("SETTINGS: %s  %s",
                settings_loaded_from_flash() ? "FLASH" : "DEFAULTS", dbg);
    }

    /* Apply the persisted slot map EARLY -- the gateware gates the Apple II
     * /RES release on the 0x6B reconfig strobe (reset contract: the Apple
     * never boots before the virtual cards know their slots), so this is what
     * lets the machine boot at native-like speed instead of waiting for
     * storage mounts. Early-main SPI writes are occasionally LOST (same
     * failure mode as the 0x2E release), so verify every register by readback
     * and only strobe once the whole map is confirmed; on failure, leave the
     * strobe to the mount-time path in disk_poll (reset then releases later
     * but still slot-correct). */
    {
        int ok = 1;
        for (int i = 0; i < 8; i++) {
            uint8_t c = settings()->slot_cards[i];
            if (c == 0xFF)
                c = settings_slot_hw_defaults[i];
            int good = 0;
            for (int a = 0; a < 5 && !good; a++) {
                fpga_spi_reg_write((uint8_t)(0x60 + i), c);
                good = (fpga_spi_reg_read((uint8_t)(0x60 + i)) == c);
            }
            ok &= good;
        }
        if (ok) {
            fpga_spi_reg_write(0x6B, 1);   /* reconfig strobe -> /RES may release */
            g_slots_applied_early = true;
            bt_mark(BT_SLOTS_APPLIED);
        } else {
            osd_log("SLOTS: EARLY APPLY UNCONFIRMED (deferred to mount path)");
        }
    }
    osd_log("USB HOST: WAITING FOR DEVICE...");
    dbg_stage(STG_PRE_USB);

    printf("A2N20 BL616 USB-host (XInput) build started\r\n");

    tcpip_init(NULL, NULL);   /* bring up the lwIP TCP/IP thread before USB host */

    usbh_initialize(0, CONFIG_USB_EHCI_HCCR_BASE); /* busid 0, BL616 OTG EHCI base */
    dbg_stage(STG_USBH_INIT);
    dbg_set(F_USBH_INIT);

    usb_osal_thread_create("xinput", 2048, CONFIG_USBHOST_PSC_PRIO + 1, xinput_thread, NULL);

    /* Uthernet II (W5100) MACRAW engine: polls the FPGA command doorbell and
     * bridges socket 0 to the USB-Ethernet adapter. */
    usb_osal_thread_create("w5100", 3072, CONFIG_USBHOST_PSC_PRIO + 1, w5100_thread, NULL);

    /* Disk II image serving: mount SD, serve track-on-demand requests. */
    usb_osal_thread_create("disk", 3072, CONFIG_USBHOST_PSC_PRIO + 1, disk_thread, NULL);

    /* Remote console/menu mirror on TCP port 23. */
    telnetd_init();

    /* Super Serial Card bridge: 6551 wire <-> Hayes modem / TCP. */
    sscbridge_init();

    /* FTP server for the storage volume (port 21). */
    ftpd_init();

    dbg_stage(STG_SCHED);
    dbg_set(F_THREAD_UP);

    vTaskStartScheduler();

    while (1) {
    }
}
