a2fpga/a2fpga_core/boards/a2p25/src/a2fpga_esp32/a2fpga_radio.cpp

#include "a2fpga_radio.h"

using namespace libhelix;

// Constants
const size_t RADIO_AUDIO_BUFFER_SIZE = 1024;  // Expected by I2S system (AUDIO_BUFFER_FRAMES * 2)

// Internal constants
#define PCM_RING_BUFFER_SIZE (16384)    // Larger buffer to handle burst decoding
#define PCM_PREBUFFER_SIZE (4608)       // Minimum buffer before starting playback (2 MP3 frames)
#define PCM_UNDERRUN_SIZE (1536)        // Stop playback when buffer drops below 1.5 I2S cycles
#define UNDERRUN_GRACE_PERIOD 5         // Allow 5 cycles of silence before rebuffering
#define STREAM_BUFFER_SIZE 4096

// Static member variables
static bool s_radio_active = false;
static String s_radio_url = "";
static TaskHandle_t s_radio_task = NULL;

// MP3 decoder
static MP3DecoderHelix s_mp3_decoder;
static bool s_mp3_decoder_initialized = false;

// PCM ring buffer
static int16_t s_pcm_ring_buffer[PCM_RING_BUFFER_SIZE];
static volatile size_t s_pcm_write_index = 0;
static volatile size_t s_pcm_read_index = 0;
static volatile size_t s_pcm_available = 0;
static bool s_pcm_prebuffered = false;
static int s_underrun_grace_cycles = 0;

// Network buffers
static uint8_t s_stream_buffer[STREAM_BUFFER_SIZE];

// PCM ring buffer functions
static size_t pcm_ring_write(const int16_t* data, size_t samples) {
  size_t written = 0;
  for (size_t i = 0; i < samples && s_pcm_available < PCM_RING_BUFFER_SIZE; i++) {
    s_pcm_ring_buffer[s_pcm_write_index] = data[i];
    s_pcm_write_index = (s_pcm_write_index + 1) % PCM_RING_BUFFER_SIZE;
    s_pcm_available++;
    written++;
  }
  return written;
}

static size_t pcm_ring_read(int16_t* data, size_t max_samples) {
  size_t read = 0;
  size_t available_before = s_pcm_available;
  
  for (size_t i = 0; i < max_samples && s_pcm_available > 0; i++) {
    data[i] = s_pcm_ring_buffer[s_pcm_read_index];
    s_pcm_read_index = (s_pcm_read_index + 1) % PCM_RING_BUFFER_SIZE;
    s_pcm_available--;
    read++;
  }
  
  // Debug only actual problematic reads (not normal full buffer state)
  if (available_before > max_samples && read < max_samples && read > 0) {
    Serial.printf("RING READ ISSUE: had %d, tried %d, got %d, remaining %d\n", 
                  available_before, max_samples, read, s_pcm_available);
  }
  
  return read;
}

// MP3 decoder callback - receives decoded PCM data
void A2FPGARadio::mp3DataCallback(MP3FrameInfo &info, int16_t *pcm_buffer, size_t len, void* ref) {
  // Debug: print MP3 frame info periodically with more details
  static int frame_count = 0;
  static uint32_t last_samprate = 0;
  static int last_nChans = 0;
  static int last_samples = 0;
  
  // Print if frame characteristics change or every 200 frames
  bool changed = (info.samprate != last_samprate) || (info.nChans != last_nChans) || (len != last_samples);
  if (changed || (frame_count % 200 == 0)) {
    Serial.printf("MP3 Frame #%d: %dHz, %dch, %dbps, %d samples, bitrate=%d, layer=%d, buffer: %d/%d\n", 
                  frame_count, info.samprate, info.nChans, info.bitsPerSample, len, 
                  info.bitrate, info.layer, s_pcm_available, PCM_RING_BUFFER_SIZE);
    last_samprate = info.samprate;
    last_nChans = info.nChans;
    last_samples = len;
  }
  frame_count++;
  
  // Check if buffer has enough space, if not wait briefly for consumer
  while (s_pcm_available + len > PCM_RING_BUFFER_SIZE) {
    vTaskDelay(pdMS_TO_TICKS(1)); // Wait for consumer to drain buffer
  }
  
  // Write decoded PCM data to ring buffer
  size_t written = pcm_ring_write(pcm_buffer, len);
  if (written < len) {
    Serial.printf("Warning: PCM ring buffer full, dropped %d samples\n", len - written);
  }
}
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
