a2fpga/a2fpga_core/boards/a2mega/hdl/video/ddr3_framebuffer_480p.sv

// DDR3-backed framebuffer for Tang Mega 60K — 480p non-scaling output
// Based on ddr3_framebuffer.v by nand2mario, March 2025
// Modified for 480p by Ed Anuff, 2025
//
// - A framebuffer stored in DDR3, displayed at 480p (720x480) with NO upscaling.
// - Pixels are stored at native resolution (e.g. 560x192 or 640x200) and displayed
//   with integer 2x vertical scaling, centered in the 720x480 frame with borders.
// - The DDR3 intermediate buffer solves the beam-racing problem while preserving
//   clean integer-scaled pixel output.
// - Pixels stored as RGB565 (16-bit) for 2x bandwidth savings vs RGB666.
//   Lossless for all Apple II/IIgs/TMS9918A content (all sources are RGB444).
// - Dynamic change of framebuffer size is supported (e.g. Apple II 560x192 <-> VGC 640x200).
//
// Internals:
// - Write path: async FIFO, 8-pixel RGB565 grouping (128 bits = 1 DDR3 word), batch writes
// - Read path: line buffer (dual-port BRAM, ping-pong) bridges DDR3 (clk_x1) to HDMI (clk_pixel)
// - 2x vertical scaling: each FB line is fetched once, displayed on 2 consecutive HDMI lines
// - Borders: computed from fb_width/fb_height, centered in 720x480
// - Scanline dimming: odd HDMI lines in active area dimmed to 50%
//
// 480p timings:
//   858 = 720 + 16(front porch) + 62(sync) + 60(back porch)
//   525 = 480 +  9(front porch) +  6(sync) + 30(back porch)

module ddr3_framebuffer_480p #(
    parameter WIDTH = 640,           // multiples of 8
    parameter HEIGHT = 480,
    parameter COLOR_BITS = 18,       // RGB666
    parameter NUM_EXT_PORTS = 0,     // number of external memory ports
    parameter [27:0] EXT_PORT_BASE [0:3] = '{28'h0, 28'h0, 28'h0, 28'h0}
)(
    input               clk_27,      // 27 MHz input clock (for DDR3 PLL)
    input               clk_g,       // 50 MHz crystal
    input               pll_lock_27,
    input               rst_n,
    output              clk_out,     // 74.25 MHz DDR3 domain clock (not for HDMI)
    output              ddr_rst,     // output reset signal for clk_out
    output              init_calib_complete,

    // HDMI pixel clocks (from board PLL)
    input               clk_pixel,   // 27 MHz pixel clock
    input               clk_pixel_x5,// 135 MHz TMDS 5x clock
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
