a2fpga/a2fpga_core/(commit log)

2024-03-03 Clear mixed-mode soft switch on reset
    [apple_memory.sv]
2024-04-14 update serial module inst in other board project top.sv files
2024-04-24 implement simple LPF to fix Nox Archaist sampled audio
    [top.sv]
2024-04-26 IIR filter
    [device.cfg]
2024-04-26 fix using wrong clock in speaker module
    [apple_speaker.sv]
2024-04-26 bring fixed audio to a2n20v1 boards
    [top.sv]
2024-06-19 fix BUS_DATA_OUT_ENABLE switch to properly disengage card from data bus
    [apple_bus.sv, top.sv]
2024-06-23 respect rom switches
2024-08-13 fix double lores colors
    [apple_video.sv]
2024-08-23 rename files & folders for Enhanced firmware
    [device.cfg]
2024-08-26 fix the project build settings
    [top.sv]
2024-08-29 fix picosoc uart
2024-09-08 update SCC UART for 54Mhz master clock
2024-09-08 parameterize clock speed for SSC & UART
2024-09-08 fix clock timing for 50 baud UART settings
    [uart_6551.v, uart_rx.v, uart_tx.v]
2024-09-08 recognize INTC8ROM switch correctly for SSC and Disk II
    [a2bus_if.sv, apple_disk.sv, super_serial_card.sv]
2024-09-09 update Enhanced with SSC and ROM fixes
    [apple_disk.sv, apple_memory.sv, top.sv]
2024-09-10 control of power-on-reset release by PicoSoC, reconnect SD Card
    [a2bus_control_if.sv, apple_bus.sv, main.c, top.sv]
2024-09-11 use slot_if
2024-09-14 slot initialization in slots.hex
2024-09-14 wire slotmaker to picosoc
2024-09-14 add slotmaker to all projects
2024-09-18 control ws2812 color led
2024-09-18 build slotmaker version for all card variants
2024-09-20 add slot initialization
2024-09-23 slot initialization part 2
2024-09-24 rebuild all boards
2024-11-18 Update README.md
    Changed all references to top.v to top.sv instead. Removed reference to slot 1 for SSC and changed to slot 2 as this is where it is implemented in the I/O space when enabled.
2024-12-09 fix high order bit in 6522 register not being set
    [via6522.vhd]
2024-12-09 fix ca2, cb1, and cb2 to reflect schematics
    [mockingboard.sv]
2024-12-10 no longer set ym2149 reg #7 on reset
    [YM2149.sv]
2024-12-11 fix 6522 reset handling
    [via6522.vhd]
2024-12-13 move SSC to slot 2
2025-07-06 Squashed commit of the following:
    commit 889d568f852a63f01bab0802ac47b8493f16c93c
    Author: Ed Anuff <ed@anuff.com>
    Date: Sun Jul 6 15:37:10 2025 -0700
    update a2n20 build
    commit 9ede341741e84db999f1610825bf4f7cf161347a
    Author: Ed Anuff <ed@anuff.com>
    Date: Sun Jul 6 15:00:31 2025 -0700
    clean up enhanced build
    commit 028d8eaf6efc20dc08a572f74cef51a3a6959da9
    Author: Ed Anuff <ed@anuff.com>
    Date: Sat Jul 5 10:44:31 2025 -0700
    updated schematics
    commit 3c352f8ae8f2075c2788d5817e37f4da00d56c68
    Author: Ed Anuff <ed@anuff.com>
    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
    [device.cfg]
2026-06-14 Add pixel-stream video pipeline, framebuffer renderers, and VDP/overlay updates
    Shared HDL: pixel_stream_if with apple_video_gen/vgc_gen generators, framebuffer_writer and direct_display consumers, framebuffer_480p, scan_timer, plus F18A/SuperSprite and debug-overlay work.
2026-06-14 Add mem_port_if memory abstraction with SDRAM and DDR3 multi-port backends
    Shared HDL: mem_port_if/mem_if_mux, split-clock SDRAM controller ports + CDC, DDR3 multi-port arbiter + async CDC, and a2mem_if soft-switch state.
2026-06-14 Add bus timing, Ensoniq DOC5503 audio, and shared peripheral cores
    Shared HDL: a2bus timing/snoop, sound_glu/doc5503 and the audio/CDC/filter path, the YM2149/6522/6551 cores, and the disk modules.
2026-06-14 Remove vestigial PicoSoC soft core and RISC-V firmware
    Delete hdl/picosoc and the PicoRV32 firmware (boot/cardrom/firmware/libraries); coprocessor functionality is provided by external MCUs (BL616/ESP32-S3).
2026-06-14 Add a2mega board (Tang Mega 60K, DDR3 framebuffer)
    [device.cfg]
2026-06-14 Add a2n20v2-GS board (SDRAM beam-accurate framebuffer, Ensoniq audio)
    [device.cfg]
2026-06-14 Add a2n20v2-Enhanced board with BL616 MCU coprocessor and firmware
2026-06-14 Add a2p25 board (Tang Primer 25K, ESP32-S3 LCAM capture + ES5503 audio)
    [device.cfg]
2026-06-14 Sync a2n20v2, a2n20v1, a2n9 boards and test assets
2026-06-14 Add first-run environment setup: /setup skill and getting-started guide
    Onboarding layer so a new user/agent can get productive after cloning and
    starting an agent in the repo root.
    - docs/getting-started.md: environment-setup reference — toolchain matrix
    (Gowin, openFPGALoader, BL616 T-Head/Bouffalo, ESP32 Arduino), per-board
    needs, and the key gotchas (macOS Gowin CLI patch, T-Head not Homebrew
    riscv-gcc for BL616, the esp32s3 JTAG dependency for a2mega/a2p25).
    - .claude/skills/setup: the /setup skill — detects OS and installed tools,
    scopes firmware toolchains to the user's board/intent, and guides installs
    (confirming first), verifying with tools/build.sh <board> syn.
    - AG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
2026-06-15 Fix GitHub Linguist stats: exclude Gowin build output (.p = Gnuplot)
    Gowin place-&-route emits boards/<board>/impl/pnr/<board>.p (multi-MB), and
    Linguist maps .p to Gnuplot and ranks languages by bytes, so those generated
    files dominated the language bar. The old .gitattributes meant to exclude
    impl/ but the patterns were broken: bare impl/** (doesn't match nested
    boards/*/impl/), a board list missing a2mega/a2p25/a2n20v2-GS, and the wrong
    a2n20v2_enhanced spelling.
    Replace with a wildcard covering every board's build output:
    boards/*/impl/** linguist-generated
    *.fs linguist-generated
    *.gprj linguist-vendored
    releases/** linguist-vendored
    Verified via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
2026-06-15 README: trim A2N9/A2N20v1 sections, fix WIP variant links
    Most users only have the A2N20v2, so the dedicated A2N9 and A2N20v1 sections
    were noise. Replace them with an "Other boards" pointer to docs/boards.md
    (covering the earlier boards and the in-development a2mega/a2p25). Also fix the
    broken experimental-variant link (boards/a2n20v2_enhanced -> a2n20v2-Enhanced)
    and add a2n20v2-GS, framed as works-in-progress with caveats.
2026-06-15 a2n20v2: add pixel_stream/direct_display video path (HDMI-locked)
    Implement the pixel_stream_if generators on the main A2N20v2 board through
    direct_display, equivalent to the legacy pipeline but via the new interface.
    Selected by USE_PIXEL_STREAM (default 1); legacy apple_video + vgc preserved
    at 0.
    top.sv:
    - Wrap video generation in a USE_PIXEL_STREAM generate block. New path runs
    apple_video_gen + vgc_gen on clk_logic (54 MHz) with direct_display driving
    pixel_clk_en at the 27 MHz display rate (PIX_CLK_DIV=2), HDMI-locked via
    hdmi_x/hdmi_y. Apple/SHR mux on SHRG_MODE (frame-latched), CDC to clk_pixel,
    feeding the unchanged SuperSprite + DebugOverlay + HDMI chain.
    - BSRAM read hand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
2026-06-16 a2n20v2-Enhanced: pixel_stream/direct_display video + BL616 standalone fallback
    Port the pixel_stream_if generators to the Enhanced board via direct_display
    (equivalent to the legacy pipeline through the new interface), and make the
    board usable without the BL616 MCU firmware running.
    Video (USE_PIXEL_STREAM, default 1; legacy preserved at 0):
    - top.sv: USE_PIXEL_STREAM generate block — apple_video_gen + vgc_gen on
    clk_logic with direct_display at the 27 MHz display rate (PIX_CLK_DIV=2),
    HDMI-locked via hdmi_x/hdmi_y. Apple/SHR mux on SHRG_MODE, CDC to clk_pixel,
    - Unlike the plain a2n20v2, the Apple VRAM read goes throu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
2026-06-20 a2n20v2-Enhanced: USB-host XInput gamepad driver + Select display toggle
    Add a separate USB-host firmware build for the BL616 that reads an XInput
    gamepad and toggles the HDMI display between the live Apple II output and an
    MCU-drawn menu when Select is pressed. The default FT2232 device firmware is
    untouched (this is a distinct build in firmware_host/).
    Firmware (firmware_host/):
    - CherryUSB host build (FreeRTOS); custom usbh_xinput class driver matching the
    XInput vendor interface (0xFF/0x5D/0x01).
    - Full XInput start sequence ported from nand2mario/firmware-bl616 +
    MiSTle-Dev/FPGA-Companion: GET_STRING_DESCRIPTOR reads ("SN30 Pro needs this")
    + vendor control transfers + EP2 output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
2026-06-20 a2n20v2-Enhanced: fix XInput gamepad hot-swap (direct)
    Detect a newly-plugged controller via a g_need_init flag set in the connect
    callback instead of class-instance pointer identity — a freed class struct's
    address gets reused, so a new pad looked "same" and skipped its init sequence
    (symptom: hot-swap usually needed a power cycle). Also scan /dev/xinput0..3
    since the device slot isn't always 0 right after a disconnect.
    Direct hot-swap now works. Known limitation: hot-swapping a pad behind a USB
    hub isn't detected (re-plug the hub) — a deeper CherryUSB hub-driver behavior;
    low priority since direct connection works (and no hub is needed).
    [main.c]
2026-06-20 a2n20v2-Enhanced: document BL616 USB (host support, lessons, roadmap)
    Add docs/BL616_USB.md covering the BL616 USB controller (HS OTG, EHCI, single
    port, no companion; native WiFi/BLE separate from USB), the host-vs-device role
    constraint, the XInput gamepad host we built, the hard-won lessons (async
    interrupt reads, device init sequences, full-speed-is-init-not-transport,
    hot-plug detection, hub downstream-hotplug limitation, VBUS/adapter caveats,
    DebugOverlay as the host-mode debug channel), how to add a new USB class, and a
    per-device feasibility roadmap (storage/mouse/keyboard/serial/ethernet/wifi/
    bluetooth) grounded in the bundled CherryUSB host classes + lwIP + native radios.
    Link it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
2026-06-20 a2n20v2-Enhanced: BL616_USB doc — card↔PC comms (RTL8152 + lwIP) + corrections
    - Add a "Card ↔ PC communication" section: device-gadget vs host-adapter
    topologies; for the host-mode case, standardize on an RTL8152 USB-Ethernet
    dongle + lwIP. Networking roadmap (tier 1 MCU-on-net MVP / tier 2 virtual
    Hayes-modem for Apple II serial-over-ethernet, MCU-side / tier 3 Uthernet).
    - Correct the wireless rows: the Tang Nano 20K has no antenna wired to the
    BL616, so native WiFi/BLE are unusable (and USB wifi/bt dongles impractical) —
    wired USB-Ethernet is the only viable card↔PC path.
2026-06-20 a2n20v2-Enhanced: in-tree CDC-ECM USB-Ethernet + lwIP (card<->PC MVP)
    Tier-1 card<->PC networking for the BL616 USB-host build: host a USB-Ethernet
    dongle while in host mode, put the MCU on the network via DHCP, and surface the
    leased IP on the HDMI DebugOverlay as proof. Builds; hardware test pending.
    All code lives in firmware_host/ — the external bouffalo_sdk CherryUSB is left
    byte-for-byte unmodified (only include paths reference the SDK).
    - usb_net/usbh_cdc_ecm.{c,h}: in-tree CDC-ECM host driver. The target RTL8153
    (0x0BDA/0x8153) is dual-config (config 1 = Realtek vendor, config 2 = CDC-ECM),
    but bundled CherryUSB v0.10.0 only enumerates config 1, so a stock CDC class
    match n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
2026-06-20 a2n20v2-Enhanced: migrate host firmware to bouffalo_sdk v2.3.27 (CherryUSB v1.5.3)
    Updates the BL616 USB-host build from the stale Dec-2023 SDK (CherryUSB v0.10.0)
    to SDK v2.3.27 / CherryUSB v1.5.3, and uses the now-stock USB-Ethernet path.
    Why: holding an old vendored CherryUSB meant hand-rolling drivers the upstream
    now ships and maintains. v1.5.3 in particular adds the weak hook
    usbh_get_hport_active_config_index(), which is exactly what our dual-config
    RTL8153 needed.
    Ethernet — replaced our hand-rolled config-switch CDC-ECM driver
    (usb_net/usbh_cdc_ecm.*) with the STOCK usbh_cdc_ecm.c. The RTL8153 (0x0BDA/
    0x8153) exposes CDC-ECM only on config 2; we override
    usbh_get_hport_active_c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
    [main.c, usbh_xinput.c, usbh_xinput.h]
2026-06-20 a2n20v2-Enhanced: migrate FT2232 device firmware to CherryUSB v1.5.3
    Completes the SDK v2.3.27 migration (companion to the host-build commit). Ports
    the device-mode FT2232 JTAG+UART bridge to the v1.x usbd API, whose hallmark is
    a busid first-argument threaded through the whole device stack:
    - usbd_initialize(0, CONFIG_USB_EHCI_HCCR_BASE, usbd_event_handler) — the event
    handler is now passed in rather than a magic-named global, and its signature
    gains busid: usbd_event_handler(uint8_t busid, uint8_t event).
    - usbd_desc_register/usbd_add_interface/usbd_add_endpoint take busid.
    - usbd_ep_start_read/write take busid (cli.c, uart_interface.c, jtag_process.c).
    - EP callbacks gain busid: {j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
2026-06-20 docs(BL616_USB): update CDC-ECM section for v1.5.3 stock-driver + config-index hook
2026-06-20 docs: pin BL616 build to bouffalo_sdk v2.3.27 + verify in setup skill
    A bare 'git clone bouffalo_sdk' lands on master, whose CherryUSB API differs from
    what the firmware is written against — the root cause of cross-machine build
    breakage. Pin the tested tag v2.3.27 (CherryUSB v1.5.3) in the BL616 README and
    macos_build_setup.md (with verify commands + both firmware/ and firmware_host/
    builds), and make the setup skill's Step 4 detect AND check the SDK tag rather
    than only checking that BL_SDK_BASE is set. Note the old macOS SDK patches are
    obsolete at v2.3.27.
2026-06-20 docs(BL616 README): de-dup toolchain setup + fix stale flash baud
    - Build Environment Setup: replace the duplicated Homebrew-prereqs + T-Head
    build-from-source steps with a pointer to docs/macos_build_setup.md (now the
    single source for host setup); keep only the firmware-specific SDK pin + build
    commands here.
    - Flash examples: 2000000 -> 500000 baud (2M is unreliable on some cables;
    matches the a2n20-mcu-program default) + a note on the fallback ladder.
2026-06-20 a2n20v2-Enhanced: BL616 flash-safety guardrails (never write 0x0 on fused boards)
    The SDK `make flash` writes our unsigned firmware to flash 0x0, which erases the
    signed Sipeed Stage 1 and bricks a fused board (our firmware must be Stage 2 at
    0x40000). This actually bricked a board mid-session. Defense in depth so it
    cannot recur:
    - Makefile (firmware + firmware_host): override the SDK flash target to refuse
    with an error pointing at tools/a2n20-mcu-program (the /flash-mcu skill).
    - flash_prog_cfg.ini: pin address to 0x40000 (was 0x0) as a backstop; fix the
    host cfg bin name (_host).
    - PreToolUse hook (.claude/hooks/guard-mcu-flash.py + settings.json): block the
    dangerous direct flash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
2026-06-20 a2n20v2-Enhanced: RTL8152 USB-Ethernet host MVP — card gets a DHCP IP (works)
    Hardware-verified: BL616 hosts an RTL8152 USB-Ethernet adapter, pulls a DHCP
    lease (192.168.232.244), and is pingable both ways. The leased IP is shown on
    the HDMI overlay. Gamepad host build is unaffected (separate device, no regress).
    Root cause of the long "no RX" hunt was lwIP, not USB/EHCI: the SDK lwipopts
    defaults PBUF_POOL_SIZE to 0 unless CFG_ETHERNET_ENABLE is set, so
    pbuf_alloc(PBUF_POOL) failed for every received frame (RX dropped before lwIP).
    Frames were flowing correctly the whole time (chip rx_packets climbing, driver
    actual_length=88 / parsed len=64, our eth_input called).
    - CMakeLists.txt: -DP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
    [main.c]
2026-06-20 a2n20v2-Enhanced: clean up RTL8152 host glue + fix hot-plug; stock SDK driver
    Cleanup pass after the working MVP, all hardware-verified (IP + ping + hot-plug):
    - Hot-plug fix: usbh_rtl8152_stop now tears the netif down on the tcpip thread
    (dhcp_stop + netif_remove). Without netif_remove, a re-plug called netif_add on
    an already-added netif (lwIP list corruption) so swapping back from the gamepad
    to the adapter failed. The IP/status reporter thread now exits on disconnect
    (g_net_active) and self-deletes, so re-plug spawns one fresh reporter instead
    of accumulating threads fighting over the screen.
    - Slim the overlay to a clean status (link / rx / tx / IP); drop the live
    register/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
    [main.c]
2026-06-20 docs(BL616): document RTL8152 USB-Ethernet host networking + pbuf-pool gotcha
    Add a README section for the USB-host Ethernet feature: RTL8152 adapter, the
    config that enables it (CONFIG_CHERRYUSB_HOST_RTL8152, 16K rx_buf_sz, the
    critical -DPBUF_POOL_SIZE override), that it runs on the stock CherryUSB driver,
    and how to test. Rebuilt host bin against the now-pristine SDK rtl8152.c.
2026-06-20 docs(BL616_USB): update §7 networking to the working RTL8152 vendor-driver path
    The CDC-ECM/RTL8153 'chosen approach' was stale — RX never worked on that path.
    Rewrite §7 to the actual solution: stock usbh_rtl8152 vendor driver + RTL8152
    adapter + lwIP, HW-verified (DHCP IP + ping + hot-plug). Document the two
    required build settings (16K rx_buf_sz, PBUF_POOL_SIZE override) and why the
    RTL8153/CDC-ECM path was abandoned (RTL_VER_09 unsupported; the real RX blocker
    was PBUF_POOL_SIZE=0). Fix the roadmap rows (Tier 1 = DONE).
2026-06-20 docs(BL616_USB): correct overclaim — pbuf pool was the RTL8152 blocker, not CDC-ECM's
    The CDC-ECM/8153 path failed at a different/earlier point (bulk-IN URB never
    completed, bn0) than the RTL8152 (which completed but pbuf-dropped). The pbuf
    pool was never exercised on the CDC-ECM path, so the pbuf fix alone likely would
    not have fixed CDC-ECM. The CDC-ECM bulk-IN-never-completes was never
    root-caused; suspect = stock CDC-ECM does no vendor RX-engine init that the
    rtl8152 vendor driver does.
2026-06-20 a2n20v2-Enhanced: add ASIX AX88772x USB-Ethernet support (stock usbh_asix)
    Pre-stage ASIX support so an AX88772A adapter is a flash-and-test (the stock
    CherryUSB usbh_asix driver does runtime chipcode detection + per-variant PHY init
    for AX88772/772A/772B). Mirrors the RTL8152 integration:
    - proj.conf: CONFIG_CHERRYUSB_HOST_ASIX 1 (coexists with RTL8152 + CDC-ECM).
    - main.c: usbh_asix_run/stop + eth_input + asix_linkoutput glue, same pattern as
    the RTL8152 path; netif_remove on stop for hot-plug.
    - Refactored the status overlay into a shared eth_report_thread() used by both
    the RTL8152 and ASIX reporters (link / rx / tx / IP).
    - Reuses the pbuf-pool fix (CMakeLists) and the 2048 ASIX rx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
    [main.c]
2026-06-20 docs(usbh_xinput): point to main.c for the XInput start sequence
    The driver only binds endpoints + parses reports; the SN30/SF30 Pro start
    sequence (two GET_STRING_DESCRIPTOR reads + interrupt-OUT magic packets) lives in
    main.c (k_xbox_init_ctrl/k_xbox_ep2), mirroring nand2mario/firmware-bl616 keeping
    it in usb_gamepad.cpp. Add a header breadcrumb so the next person looks in main.c,
    not the driver, when a controller enumerates but sends no reports. Also note the
    stock usbh_xbox driver is intentionally not enabled.
    [usbh_xinput.h]
2026-06-20 a2n20v2-Enhanced: emulated Uthernet II (W5100) MACRAW networking
    Add an emulated a2RetroSystems Uthernet II (WIZnet W5100) card, split like
    the real chip: the FPGA card holds the register/buffer space + the C0nX
    indirect front-end; the BL616 runs the MACRAW engine and bridges socket 0
    to the USB-Ethernet dongle at layer 2 (the Apple II appears on the LAN with
    its own MAC/IP).
    Verified end-to-end on hardware: IP65 DATE65 runs detect -> DHCP -> DNS ->
    NTP and shows the correct date/time; reliable across repeated runs.
    FPGA:
    - hdl/uthernet2/uthernet2.sv: card ID 5, W5100 indirect engine, 18 KB
    dual-port BSRAM (regs 0x0000-0x07FF + TX/RX buffers 0x4000-0x7FFF),
    auto-increment wrap, per-soc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
    [bl616_spi_connector.sv, fpga_spi.c, fpga_spi.h, main.c, top.sv, uthernet2.sv, w5100.c, w5100.h]
2026-06-21 a2n20v2-Enhanced: fix gamepad+Ethernet hang (SPI mutex taken from ISR)
    With a gamepad and the USB-Ethernet dongle both on a hub, the board hung
    during DHCP. Root cause: the XInput URB completion callback (xinput_in_cb)
    runs in HCD/interrupt context but called fpga_spi_reg_write / menu_toggle,
    which take the FreeRTOS SPI mutex (added for the W5100 bridge). Taking a
    mutex from an ISR is illegal -- it limped along while the mutex was free but
    wedged the moment it was held (the DHCP SPI burst), freezing every thread
    (no fault -- a pure deadlock, which is why nothing was visible).
    Fix: the callback now only parses the report, stashes the buttons, and
    re-arms the URB (all ISR-safe); the XInput th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
    [fpga_spi.c, fpga_spi.h, main.c]
2026-06-21 a2n20v2-Enhanced: SPI->SDRAM (SPACE 1) write FIFO — fix dropped-byte fpga_screen glitches
    The single-word accumulator in bl616_spi_connector.sv dropped bytes under
    framebuffer read contention: a new XFER byte to a different word overwrote the
    held accumulator when mem_if.available was low, so the un-flushed word was lost.
    Symptom: flashing/garbled characters on the fpga_screen text display (e.g. the
    XInput menu's screen clear). W5100/Uthernet II is unaffected (BSRAM via SPACE 3).
    Replace the accumulator with a 32-deep word FIFO (wf_*) fed by a byte
    accumulator (acc_*) plus a one-word read cache (rdc_*). An arbiter drains
    queued writes before issuing reads (preserves ordering), reads are h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
    [bl616_spi_connector.sv]
2026-06-30 video: fix faint 80-col text flicker (direct-display CDC + Enhanced SDRAM fetch jitter)
    The pixel-stream update moved the apple_video_gen/vgc_gen generators onto
    clk_logic (54 MHz) and brought composited RGB back into clk_pixel (27 MHz)
    for the SuperSprite/HDMI chain. On the non-double-buffered boards this exposed
    two faint 80-column text flicker mechanisms; both are fixed here.
    1) Marginal clk_logic->clk_pixel pixel hand-off (a2n20v2 + a2n20v2-Enhanced):
    - direct_display: re-sync the pixel-enable divider to a single-cycle
    line-start strobe each scanline so the pixel cadence holds a fixed phase
    relative to the HDMI raster instead of free-running from power-on.
    - top.sv: regi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
    [direct_display.sv, top.sv]
2026-07-03 a2n20v2-Enhanced: BL616-served disk volumes, ProDOS HDD, gamepad menu
    Disk II floppy emulation served by the BL616 (track-on-demand): only the
    track under each head is resident, in an 8 KB SDRAM window per drive; on a
    seek drive_ii requests the track over the drive_volume_if protocol and the
    MCU streams it in via SPI, with dirty-track writeback on the next seek.
    Formats: .nib (raw nibbles), .dsk/.do/.po (sector images, 6-and-2 GCR
    nibblized on the fly by the shared gcr_dsk codec, de-nibblized on flush with
    per-sector checksum gating so a bad decode never corrupts the image), and
    .2mg containers. A bare .dsk's sector order is sniffed from content (DOS 3.3
    VTOC vs ProDOS volume directory). The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
2026-07-03 a2n20v2-Enhanced: rewrite README as an end-user beta guide
    Covers the full beta-tester path: required hardware and host tools, the
    two-part update (FPGA bitstream via openFPGALoader over the Debug port;
    BL616 firmware via boot mode + a2n20-mcu-program at Stage 2 0x40000, with
    the make-flash warning and read-back verification), USB stick preparation
    and the default image names per drive, the first-boot sequence under the
    reset hold, the gamepad menu reference, DIP switches, troubleshooting, and
    pointers to the developer docs.
2026-07-03 a2n20v2-Enhanced: subdirectory browsing in the disk image picker
    The menu's file picker now navigates folders on the storage volume:
    directories list first (with a trailing slash), A descends, B or the
    (UP ONE DIRECTORY) entry goes back up, and selecting an image stores its
    full relative path. Listing runs in the disk thread as before, one
    directory per request.
    Settings blob bumped to version 2 (image-override fields grown from 32 to
    64 bytes to hold subdirectory paths) with a field-preserving migration from
    v1, so existing saved preferences survive the upgrade.
2026-07-03 a2n20v2-Enhanced: B goes up a directory in the picker; README note
    Inside a picker subdirectory the B button now navigates to the parent
    directory (exiting the picker only from the root), and the README mentions
    subdirectory browsing.
2026-07-03 a2n20v2-Enhanced: drop settings migration — invalid blobs load defaults
    Settings versioning policy simplified per review: the loader validates
    magic, version, size and CRC exactly and falls back to defaults on any
    mismatch. No cross-version migration — preferences are cheap to re-enter
    from the menu, and the settings struct can now change freely with just a
    version bump.
2026-07-03 a2n20v2-Enhanced: longer LFN paths and picker entry names
    Image paths are full FatFS long filenames, so the previous limits were too
    tight: the settings path fields grow from 64 to 128 bytes (settings v3) and
    picker directory entries from 40 to 64 characters (entries longer than the
    old cap were silently skipped in listings). The drive list shows an image's
    basename, since full subdirectory paths exceed the label width.
    [disk.c, disk.h, settings.h]
2026-07-03 a2mega: add dedicated 50->60 MHz USB host PLL
    Add pll_usb.v (Gowin PLLA wrapper) generating the 60 MHz clock required by
    the usb_hid_host full-speed core (5x the 12 Mbps bit rate; VCO 1200 MHz / 20).
    Derived from the 50 MHz board oscillator on its own PLL instance since the
    existing PLLA VCO (1350 MHz) is not an integer multiple of 60.
    Also drops a few now-default keys from a2mega_process_config.json (Gowin IDE
    regeneration).
    [pll_usb.v]
2026-07-04 a2mega: integrate usb_hid_host USB full-speed host core
    Wire the m1nl fork of nand2mario's usb_hid_host (core, external UKP
    microcode ROM, .mem image) to the USB-A port: D+/D- on BANK3 H13/G13 via
    IOBUFs under the core's usb_oe, LVCMOS33 DRIVE=8 SLEW=SLOW, no pulls (the
    board provides the host-side 15k pulldowns). The core runs at 60 MHz from
    the dedicated pll_usb with a lock-gated synchronized reset, and clk_usb is
    constrained as a generated clock, async to all other domains.
    HID outputs (keyboard/mouse/gamepad) land on wires only; consumers and
    their CDC into clk_logic come next. Builds clean: 0 violations, clk_usb
    Fmax 91.7 MHz vs 60 required.
    [top.sv, usb_hid_host.v, usb_hid_host_rom.v]
2026-07-04 a2n20v2-Enhanced: MCU firmware self-update from the storage volume
    The menu gains a FIRMWARE UPDATE screen: pick a .bin from the USB stick /
    SD card (directory picker), and the firmware updates itself — no PC.
    Two-phase design around the XIP constraint (the app executes in place from
    flash at 0x40000 and cannot overwrite itself while running): the file is
    first STAGED into unused flash at 0x200000, one 4 KB chunk per disk_poll so
    disk serving stays live, with a Bouffalo bootheader check (BFNP, matching
    the installed app) and a full CRC-32 read-back verification — harmless to
    abort or lose power. The COMMIT is a TCM-resident, interrupts-off loop
    (flash-read from stage -> erase -> write t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
2026-07-04 a2n20v2-Enhanced: bare-register reset after firmware commit; build stamps
    The first field test of the self-update froze at the final reboot (the
    install itself could not be judged — the test image was byte-identical to
    the installed one, and the commit erases-as-it-writes, so any partial copy
    of an identical image is indistinguishable from success). Replace the SDK's
    GLB_SW_POR_Reset (which switches clocks through ROM-API trampolines first)
    with three volatile stores to GLB_SWRST_CFG2 — no callees in the danger
    zone — with a chip/sys-reset fallback. The menu build stamps now include
    __TIME__ so a self-update test can prove the image actually changed.
    [fwupdate.c, menu.c]
2026-07-04 a2n20v2-Enhanced: firmware install finishes with a power-cycle
    Field testing proved the self-update chain end-to-end (a distinguishable
    build's timestamp appeared after install), but the BL616 does not come back
    from a warm software reset on these boards — both the SDK POR reset and a
    bare GLB_SWRST_CFG2 write leave it dark until a cold boot (Stage-1 appears
    to require power-on state). Rather than fight it: the update screen now
    instructs the user to power-cycle after the ~1-minute install freeze, the
    commit waits 500 ms so those instructions finish painting before interrupts
    go dark (the FPGA keeps displaying the frozen frame), and the README
    matches. The reset attempt remains in place sh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
    [fwupdate.c, menu.c]
2026-07-04 a2n20v2-Enhanced: dedicated full-screen install page for firmware update
    Pressing INSTALL paints a static instruction page (what the freeze means,
    wait two minutes, power-cycle, where to verify the new build) and locks the
    menu UI on it. The FPGA keeps displaying that exact frame through the
    interrupts-off commit and after the MCU stops, so the dark period carries
    its own instructions instead of a frozen menu.
2026-07-04 a2n20v2-Enhanced: fix warm-reset hang — SPI MISO idle level was the BL616 boot strap
    Root cause of the MCU never returning from a software reset: the FPGA
    drove SPI MISO high between transactions, and MISO is BL616 GPIO2 — the
    boot-strap pin the UPDATE button pulls high to enter ROM download mode.
    Every warm reset therefore sampled 'button held' and parked the BootROM in
    download mode; cold boots worked only because the unconfigured FPGA leaves
    the pin floating. MISO now idles low (the idle level sits outside any SPI
    transaction, so the protocol is unchanged).
    Adds a RESTART MCU action to the menu root — both a convenience and the
    instant test for warm-reset health.
    [menu.c]
2026-07-04 a2n20v2-Enhanced: exit flash continuous-read mode before MCU reset
    Every warm-reset attempt (SDK POR, bare SWRST_CFG2, watchdog) left the
    board dark with nothing on USB — the resets were firing, but the BootROM
    hung reading the boot header: the firmware runs XIP with the flash die in
    continuous-read mode, and that latch survives an MCU-only reset (only a
    power cycle clears it). fwupdate_reset_mcu() (TCM) now restores the flash
    to standard SPI mode (sf_ctrl owner to SAHB + reset-continue-read, per the
    SDK's own set_cache sequence) before pulling the software reset; the
    firmware-install commit and the menu's RESTART MCU (watchdog backstopped)
    both use it.
    [fwupdate.c, fwupdate.h, menu.c]
2026-07-04 a2n20v2-Enhanced: adopt FPGA-Companion's proven warm-reset recipe
    RESTART MCU and the firmware-install finale now follow the sequence
    FPGA-Companion uses successfully on the same board: arm the watchdog as a
    backstop, tear down the USB host stack, clear the HBN user-boot override
    (the HBN domain survives warm resets — a stale boot-config there redirects
    the BootROM away from flash boot, matching the observed dark-with-no-USB
    hangs that only a power cycle fixed), release the GPIO2 strap, then reset
    with the flash restored to standard SPI mode.
    [fwupdate.c, menu.c]
2026-07-04 a2n20v2-Enhanced: complete the SWRST toggle — leaving pwron_rst set held the chip in reset
    The bare-register reset wrote clear-then-set and stopped, leaving the
    reset bit asserted: the chip stayed held in reset permanently, which even
    preempted the armed watchdog backstop and produced the total black hole
    (no BootROM, no USB even with the UPDATE button held) seen in field
    testing. Complete the clear-set-clear toggle as the SDK does.
    [fwupdate.c]
2026-07-04 a2n20v2-Enhanced: remove RESTART MCU; document the fused-board warm-reset limitation
    Field conclusion after exhausting every angle: no software reset source
    fires on the fused boards (SDK POR, direct SWRST toggle, watchdog) — even
    with the UPDATE button held, which would land in ROM download mode if any
    reset actually occurred. The same watchdog recipe works for FPGA-Companion
    on unfused boards with the plaintext Stage-1, so the encrypted Sipeed
    Stage-1 / fused boot configuration evidently masks reset sources. The
    RESTART MCU menu action is removed (it could only wedge the board until a
    power cycle); the firmware self-update keeps its power-cycle-to-finish
    flow, and the findings are docume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
    [menu.c]
2026-07-04 a2n20v2-Enhanced: warm MCU restart via app-entry jump; USB recovery supervisor
    Chip-level reset remains impossible on fused boards, but a restart does
    not need one: with caches invalidated from TCM, jumping to the app entry
    at the XIP base re-runs the firmware exactly as Stage-1's chain-load does
    (the XIP mapping and fused-board decrypt stay programmed). The firmware
    self-update now finishes by restarting itself, and RESTART MCU is back in
    the root menu.
    Getting USB host back after the jump took the bulk of the work:
    - Drop OTG VBUS for >1 s before the jump so the bus-powered hub gets a
    real power cycle; the driver's ~10 ms drop is a brownout that zombies
    cheap hub port controllers (EP0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
    [disk.c, fwupdate.c, fwupdate.h, menu.c]
2026-07-05 a2n20v2-Enhanced: FPGA core self-update from USB over bit-banged JTAG
    The BL616 host firmware can now reflash the FPGA's W25Q64 config flash
    itself: menu FPGA UPDATE picks a Gowin .bin from the stick, validates it
    (A5C3 sync + embedded GW2A(R)-18 IDCODE; MCU firmware images rejected),
    erases the fabric, streams the image over SPI-over-JTAG with per-page
    read-back verify, reloads the new core, and warm-restarts the MCU for a
    clean bring-up. Verified end-to-end on hardware: a core carrying a new
    build-stamp register was installed from the stick and the menu shows the
    new stamp.
    The JTAG transport is bit-banged on the BL616 GPIOs that were always
    wired to the FPGA's TAP — host mode never act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
2026-07-05 a2n20v2-Enhanced: document the no-PC update paths and current status
    The board README's menu section now covers FIRMWARE UPDATE, FPGA UPDATE,
    RESTART MCU, and the MCU/CORE build stamps, and the flashing guide points
    first-time flashers at the PC procedure and everyone else at the stick.
    The BL616 README's source layout reflects what actually shipped, the
    ecosystem doc's field-update procedures lead with the self-update paths,
    and boards.md upgrades the Enhanced board from Experimental to Beta with
    an honest feature summary.
2026-07-05 a2n20v2-Enhanced: eFuse-aware Stage-1 handling in a2n20-mcu-program
    Field report ('unfused board fixed by flashing the Sipeed partner image
    at 0x0') triggered a hardware investigation that established the real
    model, A/B/A-verified on an unfused Tang Nano 20K:
    - bl616_fpga_partner_20kNano.bin is AES-128-encrypted at rest
    (bootheader encrypt_type=1). Only fused boards - whose eFuse holds
    Sipeed's key - can boot it; an unfused BootROM rejects it and drops to
    the Bouffalo CDC recovery device. friend_20k (plaintext) is the only
    Stage 1 for unfused boards.
    - The reported board was therefore almost certainly fused with an early
    Stage 1 lacking 0x40000 chain-load support (Sipeed added it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
2026-07-05 a2mega: ESP32-S3 firmware port of the Enhanced feature set
    Port of the a2n20v2-Enhanced BL616 firmware_host to the a2mega's
    ESP32-S3-MINI-1-N8 (arduino-cli build):
    - fpga_link: mutex-guarded register/XFER layer over the Octal SPI service,
    plus gamepad polling from the FPGA usb_hid_host readback regs
    - menu/osd_console/fpga_screen: gamepad-driven menu and console on the new
    OSD text page (linear 40x24, XFER SPACE 1)
    - disk/gcr_dsk: Disk II track-on-demand and ProDOS HDD block serving from
    the micro-SD card (POSIX VFS), BSRAM windows in SPACE 4/5
    - settings: same blob layout in NVS, + WiFi credentials (v4)
    - w5100/wifi_bridge: Uthernet II MACRAW bridge over WiFi STA with MAC NAT
    (ARP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
2026-07-05 a2mega: document the ESP32 Enhanced feature-set port
    Design doc for the register-map/space extensions, OSD path, disk buffer
    windows, WiFi MAC-NAT bridge, and GW5A self-update; README user section;
    bring-up checklist in TODO; boards matrix note.
2026-07-05 a2n20v2-Enhanced: telnet remote console/menu; self-update honors the real app base
    Two features and a latent-bug fix:
    telnetd (port 23, one client): streams the osd_console backlog and live
    log lines, and on 'm' mirrors the FPGA's 40x24 text page as ANSI and maps
    keys to gamepad pulses (menu_inject) so the entire menu is drivable
    remotely - including with no gamepad attached (the xinput loop now ticks
    menu_input headless). Entering the remote menu forces the MENU view
    (menu_request_menu_view) since a bare SELECT lands in whichever MCU view
    was last active; backing out of the root menu drops the session to
    console mode with a notice instead of a stale frame. Field reports can
    now be copied t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
    [fpga_screen.c, fpga_screen.h, fwupdate.c, fwupdate.h, main.c, menu.c, menu.h, osd_console.c]
2026-07-05 tools/build.sh: fail on gw_sh errors and stale bitstreams
    gw_sh exits 0 even when synthesis/PnR fail, so a failed run could pick up
    a previous build's bitstream and timing report and print an OK summary.
    Tee the gw_sh output, abort on any ERROR line, and reject a bitstream
    whose mtime predates the run.
2026-07-05 a2mega: Enhanced co-processor feature set in the FPGA core
    Port of the a2n20v2-Enhanced BL616 contract to the ESP32 OSPI connector,
    continuing the a2mega-usb-host branch:
    - esp32_ospi_connector: HDD compact regs (0x26-0x2D), Apple II reset
    hold/release (0x2E, 3s no-MCU fallback + 15s backstop), W5100 doorbell
    (0x7A), USB HID readback regs (0x16-0x1B), scratch/systime, MCU-alive
    latch on STATUS reads, VOL ACK as a one-shot strobe, slot-table write
    strobe split from the reconfig strobe
    - XFER spaces: SPACE 3 W5100 port B, SPACE 4 Disk II track windows (4
    byte-lane BSRAMs, 32-bit byte-enable card port), SPACE 5 HDD blocks
    (one 32-bit BSRAM + ESP32 word-packing accumulator), SPACE 1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
    [a2fpga_regs.h, apple_bus.sv, esp32_ospi_connector.sv, esp32_ospi_proto_proc.sv, osd_text_overlay.sv, top.sv]
2026-07-05 a2n20v2-Enhanced: Super Serial Card modem bridge (Hayes AT over TCP)
    The SSC's 6551 has been wired to BL616 UART1 (GPIO11/13) since the
    device-firmware era; the host firmware finally gives the wire somewhere
    to go. sscbridge.c implements a Hayes-compatible modem: AT/ATZ/ATE/ATH/
    ATO/ATI/ATDT host[:port] with verbose result codes, +++ guard-time
    escape, DNS resolution, and minimal telnet handling on port-23
    connections (refuse negotiations, IAC escaping both directions). Period
    software just works - verified with ProTERM 3.1 on real hardware,
    including dialing the board's own telnet console.
    The bridge tracks the Apple II's baud choice live: the gateware exports
    the 6551 control register (ba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
2026-07-05 docs: correct BSRAM reclamation guidance for the a2mega
    The two obvious-looking BSRAM recoveries are both off-limits, for
    documented reasons:
    - ddr3_port_cdc FIFOs must stay BSRAM (GW5AT corrupts FF-array async-FIFO
    data across independent clocks — the debugged rippling-band bug)
    - the Ensoniq wavetable cannot simply move to DDR3 (the DOC's ~838 ns
    per-fetch deadline loses to DDR3 tail latency; that is why it is BSRAM)
    Most of the board's BSRAM spend is deliberate latency insulation against
    DDR3 variance. Remaining realistic reclaim: Uthernet II buffer aliasing,
    pending verification of driver RMSR/TMSR usage.
2026-07-05 a2mega: DDR3 controller MC buffers to registers — BSRAM 118 -> 102
    Regenerate the DDR3 IP with MC Buffer Type = REG (MC_BSRAM=false,
    MC_REG=true). The controller's internal FIFOs were the unattributed ~19
    physical BSRAMs (its 128-bit datapath FIFOs expand ~4 blocks each at the
    36-bit port-width limit); in REG mode they cost ~4K FFs instead
    (registers 39% -> 45%).
    Timing clean: 0 setup / 0 hold violated endpoints, TNS 0.000 all clocks,
    Fmax >= constraint (clk_logic 54.010 vs 54.000). BSRAM 102/118 (87%) —
    first real headroom on this board. Needs the TEXT40 soak test at
    bring-up like any DDR3-path change.
2026-07-05 a2mega: DDR3 pipeline hardening from fresh-eyes review
    - framebuffer_480p: replace the gray-coded hdmi_cy CDC with an atomic
    toggle-handshake transfer. Gray code only protects increments; the
    480p raster wrap 524->0 flips 4 gray bits in one edge, and a clk
    sample mid-transition decoded an arbitrary line number — enough to
    falsely trigger the catch-up or line-0 fetch paths (rare single-line
    glitch, a candidate mechanism for residual moving distortion)
    - ddr3_port_cdc + framebuffer_480p: synchronize reset DEASSERTION into
    the client clock domains (assertion was async-safe; removal could
    release pointer/sync FFs metastable — previously masked only by the
    init-complete traffi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
    [apple_memory.sv, ddr3_port_cdc.sv, framebuffer_480p.sv, top.sv]
2026-07-05 a2n20v2-Enhanced: FTP server for the storage volume
    Copy disk images on/off the stick over the LAN with a normal file
    manager instead of shuttling hardware. ftpd.c is a small passive-mode
    FTP server (USER/PASS accepted as-is, LAN threat model): LIST/NLST,
    RETR/STOR, DELE, MKD/RMD, RNFR/RNTO, SIZE, CWD/CDUP/PWD, one session
    pool of three because Cyberduck-class clients open a separate control
    connection per transfer (single-client servers time their uploads out).
    FatFS stays single-threaded: disk.c gains an async FS proxy
    (disk_fs_request) - network threads submit one bounded job at a time and
    the disk thread executes it between image-serving polls, so Disk II
    track service never misses its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
2026-07-05 a2n20v2-GS/Enhanced: share one apple_bus and SDRAM apple_memory
    The two Tang Nano 20K boards carried near-identical board-local copies of
    apple_bus.sv and apple_memory.sv, so fixes (e.g. the IIgs bus-sampling
    issue tracked in the GS TODO) had to be made twice. Converge them:
    - hdl/bus/apple_bus.sv: shared a2bridge-CPLD bus interface, taken from the
    Enhanced superset (INH_OUT_ENABLE, inh_n_i, a2bus_control_if ready/
    reset_hold). GS instantiates it with INH_OUT_ENABLE=0, inh_n_i tied high,
    and a stubbed a2bus_control_if (ready=1, reset_hold=0), which reduces to
    its previous RTL exactly.
    - hdl/memory/apple_memory_sdram.sv: merged SDRAM shadow-memory module
    (renamed from apple_memory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
    [apple_bus.sv, apple_memory.sv, apple_memory_sdram.sv, top.sv]
2026-07-05 a2mega: fix OSPI reads — bus turnaround on both sides of the link
    First live smoke test found the read path had never worked (both bugs
    pre-date the Enhanced port; 'Test the OSPI interface' was an unchecked
    TODO):
    - FPGA proto proc: drove the shared 8-bit bus with its status byte
    during MASTER-driven slots (data_oe <= st >= ST_OPCODE — a leftover
    from the a2p25 serial protocol where MISO is a separate line),
    fighting the ESP32's push-pull outputs during every command header
    and write payload byte. Now drives only genuine response slots: the
    two reg-read response bytes ([data][status], counted) and the
    XFER-read dummy (now carries the real status byte) + payload.
    - ESP32 ospi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
    [a2fpga_esp32.ino, a2fpga_ospi_link.c, esp32_ospi_proto_proc.sv]
2026-07-05 docs(bl616/macos): capture toolchain + flash-tool fixes for recent macOS
    Building the T-Head GCC 10.4.0 toolchain and running the BL616 flasher on a
    current macOS (Xcode CLT with Apple clang 16/17+, Homebrew Python 3.13/3.14)
    hit several failures not covered by the existing macOS setup doc. Document the
    reproducible fixes:
    Toolchain (macos_build_setup.md, "Newer macOS / recent Xcode build fixes"):
    - bundled zlib in binutils/gdb fails under recent clang -> add --with-system-zlib
    to those sub-build configure lines
    - GCC 10.4.0 host C++ won't compile against Apple libc++ (__abi_tag__) -> build
    host tools with Homebrew GCC (CC=gcc-16 CXX=g++-16)
    - a '.' on $PATH lets GCC's in-tree as/ld wra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
2026-07-05 a2n20v2-Enhanced: DUAL_RATE_SDRAM build config (108 MHz split clock)
    Step 2 of the GS/Enhanced reconciliation: bring the GS board's split-clock
    SDRAM architecture into the Enhanced tree behind a compile-time switch, so
    the beam-accurate framebuffer (step 3) has a proven 108 MHz base with the
    full Enhanced peripheral set.
    `define DUAL_RATE_SDRAM in top.sv (following the ENSONIQ/BL616_SPI define
    convention; off by default) selects:
    - clk_logic_108 PLL (27->108 MHz, PSDA_SEL "1010" — the known-good SDRAM
    read-capture phase from the GS board) + CLKDIV2 for the 54 MHz logic
    clock, instead of the 27->54 PLL.
    - sdram_ports clocked at 108 MHz with the GS controller parameters
    (BURST_LENGTH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
2026-07-05 a2mega: link bring-up fixes — ProDOS boots from SD over the OSPI link
    Live IIgs bring-up session. Fixes that got the link and disk serving
    working end-to-end (ProDOS 8 v4.0.2 boots from a .dsk on the SD card):
    - SPI clock 10 -> 2 MHz: the FPGA's synchronizer chain (cdc_denoise +
    2FF on SCLK vs 2FF on data) skews the effective sample point ~55-110ns
    after the SCLK edge; at 10 MHz that lands past the master's data-change
    edge and the FPGA never decodes a byte. 2 MHz gives solid margin until
    the fabric-side sync-skew fix is flashed
    - bus_wake: the first byte clocked after an idle gap is unreliable;
    prefix every command with a sacrificial 0x00 (ignored by all parked
    FSM states)
    -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
    [a2fpga_esp32.ino, a2fpga_ospi_link.c, disk.c]
2026-07-05 a2mega: OSPI link structural fixes — clean at 4 MHz, no workarounds
    Fabric (flashed and live-verified in the IIgs):
    - esp32_ospi_proto_proc: first reg-read response byte uses the live
    reg_rdata mux, not a value latched at the opcode strobe (which was the
    PREVIOUS command's register — the stale-read bug the firmware shimmed
    around)
    - top: feed the proto proc raw esp_sclk — its own 2FF plus cdc_denoise
    double-synchronized SCLK against single-2FF data, skewing the sample
    point 55-110ns past the edge and deafening the link at 10+ MHz
    Firmware:
    - double-read shim removed; SPI at 4 MHz (reg path is clean at 8 MHz,
    but XFER payload reads outrun the proto's 1-byte read pipeline ab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
    [a2fpga_esp32.ino, a2fpga_ospi_link.c, esp32_ospi_proto_proc.sv, fpgaupdate.c, menu.c, top.sv]
2026-07-05 a2n20v2-Enhanced: SHR aux memory in SDRAM (dual-rate config) — frees 16 BSRAM
    VGC_IN_SDRAM parameter on apple_memory_sdram stores the 32KB of IIgs SHR
    aux memory pre-interleaved in SDRAM instead of two BSRAM banks, dropping
    the dual-rate build from 45/46 to 29/46 BSRAM — headroom for the
    framebuffer port (step 3 of the GS/Enhanced reconciliation) and beyond.
    Layout: interleave_mux is a bijective byte permutation, so the SDRAM copy
    stores each 32-bit word already in mux-output format — source byte
    (bank s, word o, lane l) lands at word {o, l[1]}, byte lane {l[0], s},
    region word 0x8000 (between the flat shadow and Ensoniq). A VGC fetch is
    then a single 32-bit read; CPU byte writes land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
2026-07-06 a2mega: video-pipeline debug readback (OSPI regs 0x70-0x77) + viddbg CLI
    Two live symptoms on the IIgs need localization: the display sticks in
    SHR after the TransWarp GS power-up splash (reset recovers; pre-port
    builds behaved), and SHR/hires rendering is scrambled while text is
    clean (text exonerates the DDR3 scanout path, pointing at the shadow
    read/write paths or the REG-mode controller under burst load).
    New read-only registers on the ESP32 link:
    0x70 mode snapshot {use_vgc, SHRG, LINEARIZE, STORE80, PAGE2, MIXED,
    HIRES, TEXT} — captured soft switches plus the actual fb mux
    0x71/0x72 $C029 write count / last data byte (bus-tap in top.sv)
    0x73 vgc_gen missed-hsync per fra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
    [a2fpga_esp32.ino, apple_memory.sv, ddr3_port_cdc.sv, ddr3_ports.sv, esp32_ospi_connector.sv, top.sv]
2026-07-06 a2mega: fix hires shadow-read byte order — main/aux pairs were swapped
    Root cause of the stable (non-rippling) hires scrambling reported on the
    live IIgs: format_hires_data assembled the 32-bit video word as
    {main,aux,main,aux}, but the renderer contract — set by the shared
    hdl/memory/apple_memory.sv that the working Tang Nano boards use — is
    interleave_mux(offset[1], main, aux) = {aux,MAIN,aux,MAIN}: main-bank
    bytes (and the hires delay bits) belong in [23:16]/[7:0], where
    apple_video_gen's expandHires40 reads vd[23]/vd[7]. Every hires fetch
    therefore handed the renderer the aux bank's bytes — deterministic
    scrambling of hires/double-hires while text (flat shadow path) stayed
    clean.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
    [apple_memory.sv]
2026-07-09 a2n20v2-Enhanced: VIDEO_FRAMEBUFFER build config + field fixes; file picker limits (#44, #45)
    Squash of the VIDEO_FRAMEBUFFER series (PR #45) and the firmware
    picker PR (#44), hardware-validated on a IIe and a IIgs (TransWarp
    GS installed).
    VIDEO_FRAMEBUFFER build config (a2n20v2_enhanced_fb.gprj): the GS
    board's beam-accurate video architecture as a compile-time arm of the
    Enhanced top — scan_timer-paced generators, framebuffer writers, and
    sdram_framebuffer readout at HDMI rate; f18a _fb variants with
    external raster; SSP composited in the write path; shared
    mem_port_arb puts MCU+disk+HDD behind one SDRAM port (7-port cap at
    108 MHz). SHR aux memory pre-interleaved in SDRAM (frees 16 BS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
    [apple_memory_sdram.sv, bl616_spi_connector.sv, disk.c, disk.h, f18a_counters_fb.vhd, f18a_vga_cont_fb.vhd, main.c, mem_port_arb.sv]
2026-07-09 a2n20v2-Enhanced: boot polish — VGC fetch-handshake wedge fix, clean cold boot (#46)
    Closes out the remaining cold-boot bugs in the VIDEO_FRAMEBUFFER
    config, found and hardware-validated on a IIgs with a TransWarp GS.
    VGC fetch-handshake wedge (apple_memory_sdram, all configs): the
    fetch handshake was gated on vgc_active_i, which is raw SHRG_MODE and
    falls combinationally on a $C029 write, while vgc_gen paces on a
    frame-latched copy and keeps fetching until the next vsync. A fetch
    pulsed in that window was swallowed (request latch in the SDRAM
    arbiter branch, ready pipeline in the BSRAM branch), leaving vgc_gen
    waiting on vgc_ready_i forever. The TransWarp splash clears SHRG on
    its way to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
    [apple_memory_sdram.sv, disk.c, top.sv]
2026-07-09 a2n20v2: port to the shared apple_bus (#42)
    The main a2n20v2 board carried the last board-local copy of apple_bus.sv,
    byte-identical to the pre-convergence GS copy. Port it to the shared
    hdl/bus/apple_bus.sv the same way the GS board was: INH_OUT_ENABLE=0,
    inh_n_i tied high, and a stubbed a2bus_control_if (ready=1, reset_hold=0),
    which reduces to its previous RTL exactly.
    Rebuilt clean: 0 setup / 0 hold violations, all clocks meet constraint
    (clk_logic 93.5/54, clk_pixel 45.8/27).
    [apple_bus.sv, top.sv]
2026-07-09 a2n20v2-Enhanced: USB keyboard / media-remote menu input (generic HID host)
    Any USB HID keyboard or media remote can now drive the MCU menu, with no
    VID/PID matching (class-level only, keeps remote-hardware optionality):
    - Enable the stock CherryUSB usbh_hid class driver (CONFIG_CHERRYUSB_HOST_HID)
    and hook it in the new usbh_hidinput.c (usbh_hid_run/stop).
    - Keyboard interfaces are forced to boot protocol for the guaranteed 8-byte
    report layout (own SET_PROTOCOL with wIndex=intf; the stock helper
    hardcodes wIndex=0, wrong for composite devices).
    - Consumer-page (Home/Back/volume) reports are decoded via a minimal report-
    descriptor parse covering usage-code arrays and bitmap (usage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
    [main.c, menu.h, usbh_hidinput.c, usbh_hidinput.h]
2026-07-09 a2n20v2-Enhanced: raise EHCI QH pool 10->20 (remote+gamepad coexistence)
    With the HID remote adding two standing interrupt pipes, the full loadout
    (hub int + Ethernet int/bulk-in/bulk-out + MSC bulk pair during disk I/O +
    remote kbd/consumer + XInput pad + EP0 enumeration traffic) spikes past the
    10-QH EHCI pool. The pad, enumerating last on the hub, failed to come up —
    and one failed re-arm of the HUB's status pipe deafens hot-plug permanently
    (stock usbh_hub.c only restarts its poll timer on success or NAK; any other
    error, including submit -USB_ERR_NOMEM, silently stops polling forever).
    Verified on hardware: with QH_NUM=20 the remote and gamepad enumerate and
    hot-plug together (consol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
2026-07-10 a2n20v2-Enhanced: harden fw self-update + FPGA liveness watchdog on WS2812
    Root cause of the 2026-07-08 install wedge (full-ELF audit): everything
    reachable from commit_tcm is TCM/ROM-resident with bounded polls, but the
    trap vector (freertos_risc_v_trap_handler) and fault hooks live in XIP
    flash — any exception mid-erase vectors into the region being rewritten
    and wedges silently. commit_tcm also ignored every bflb_flash_* error and
    rebooted into the app region even after both CRC passes failed.
    Firmware (fwupdate.c):
    - park mtvec on a TCM trap stub for the commit; paints 0xEE + mcause +
    mepc[23:0] on the DebugOverlay scratch regs instead of wedging blind
    - TCM beacon (fwu_beacon): CS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
    [bl616_spi_connector.sv, fwupdate.c, fwupdate.h, mcu_status_led.sv, top.sv]
2026-07-10 a2n20v2-Enhanced: telnetd — reap dead/half-open clients (SO_SNDTIMEO + keepalive)
    A peer that vanished without closing (nc -z probe, killed client) could
    wedge the single-session console forever: recv had a 50 ms SO_RCVTIMEO but
    sends had no timeout, so one full send window blocked session() until
    reboot, and new connections sat in the backlog with no banner.
    - SO_SNDTIMEO 3 s on the accepted socket; tn_send loops partial sends and
    any error/timeout sets a peer-dead flag that ends the session
    - recv errors other than EWOULDBLOCK/EAGAIN end the session (reset,
    keepalive-reaped) instead of being mistaken for the poll timeout
    - SO_KEEPALIVE (idle 10 s, 5 s x3) reaps idle half-open client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
    [telnetd.c]
2026-07-10 a2n20v2-Enhanced: fwupdate — hard USB teardown, drop hangable usbh_deinitialize
    Second stuck-install failure mode, observed 2026-07-09 (distinct from the
    commit_tcm wedge): the FW UPDATE froze at INSTALLING with the LED green
    and scratch0 stale at 0xD0 — commit_tcm never entered (its 0xF1 beacon
    never appeared, IRQs still on, watchdog still fed by the W5100 bridge's
    SPI polls), and the board's network was dead. That places the hang inside
    usbh_deinitialize(0) in the COMMIT_REQ preamble: CherryUSB's polite
    teardown walks every class driver and can block forever on a URB that
    never completes, likelier with a full bus (hub + ECM + MSC + remote +
    pad). Flash was untouched — this hang is be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
    [fwupdate.c]
2026-07-11 a2mega: fix the display-corruption family — four root causes, hw-verified
    Squash of the 2026-07-10 live IIgs debugging arc (granular history on
    branch claude/great-curran-5feb9d). All four defects root-caused with
    on-board instrumentation and verified fixed on hardware (TransWarp GS
    machine, Total Replay + Spy Hunter):
    1. SHR mode wedge (stuck after the TransWarp splash until reset):
    ported main PR #46's fetch-handshake fix to the a2mega DDR3 read
    FSM — per-client request latches, classification by client + latched
    address, a request once latched always completes; vgc_active_i no
    longer gates the read side. The a2mega FSM also dropped pulses
    whenever it was busy serving t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
    [a2fpga_esp32.ino, apple_memory.sv, ddr3_debug_reader.sv, esp32_ospi_connector.sv, top.sv, vgc_gen.sv]
2026-07-11 a2mega fw: FTP server, fpgaflash CLI, WiFi power-save fix, net CLI
    ftpd.c: port of the a2n20v2-Enhanced BL616 FTP server (passive mode,
    three-session pool, LAN threat model) to the ESP32. File ops are plain
    POSIX on /sdcard (ESP-IDF FatFS is reentrant — the BL616's FSOP queue
    is unnecessary); mounted-image guard compares against the disk module's
    mount snapshots; lwIP sockets unchanged including netif_default for
    the PASV reply. Starts once WiFi is up.
    wifi_bridge: esp_wifi_set_ps(WIFI_PS_NONE) after start. The default
    modem power save slept the radio between DTIM beacons — association,
    DHCP, and outbound looked perfect while sustained INBOUND (ping, TCP)
    saw near-total loss, and the se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
    [a2fpga_esp32.ino, ftpd.c, ftpd.h, wifi_bridge.c]
2026-07-11 a2mega: TODO — WiFi latency item; FTP verified
2026-07-11 a2mega: FTP-verified flash recovery; fpgaerase/keepsram CLI; gotchas
    Config-flash repair completed. The catch-22 (every flash attempt dying
    at 'Read ID failed' against the corrupt image's boot-retry) had a
    simpler root cause than bus contention: openFPGALoader's flash phase
    defaults to 10 MHz through the ESP32 JTAG bridge, which this board
    cannot do — 500 kHz works for every operation (JEDEC ID, dump, bulk
    erase). Recipe now in docs/gotchas.md: --freq 500000 --bulk-erase,
    replug, then the standard flash.sh completes first-try on the blank
    flash (verified; board boots from flash again).
    Firmware: fpgaerase CLI (header-block erase via the SRAM-preserving
    SPI entry) and fpgaflash keepsram va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
    [a2fpga_esp32.ino, fpga_jtag.c, fpga_jtag.h, fpgaupdate.c, fpgaupdate.h]
2026-07-11 docs: bulk-erase-first rule for indeterminate flash states (a2mega)
    When a flash write errors or is interrupted, or the FPGA stops
    configuring at power-on: do not iterate on writes — bulk-erase at
    500 kHz first, then flash normally. Recorded in docs/gotchas.md and
    the flash skill.
2026-07-12 a2n20v2-Enhanced: fix --verify-flash silently skipping under sh-shebang installs
    bflb-iot-tool --read writes flash.bin into its own package directory; we
    located that dir by parsing the CLI script's shebang and asking that
    interpreter for the package path. Installs whose entry point is a
    distlib #!/bin/sh wrapper (seen in the field on a project-local venv)
    made the probe run 'sh -c import ...', fail silently, and skip the
    byte-compare with an unexplained warning.
    Now the package dir is derived by globbing site-packages relative to
    the resolved CLI executable (covers venv/conda/pipx with no subprocess),
    the shebang probe handles env-style shebangs and multi-line output, an
    in-process import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
2026-07-12 a2n20v2-Enhanced docs: first-time two-stage flash rule + field troubleshooting
    From the first external user bring-up (2026-07-11), three independent
    issues stacked: factory Stage 1 without 0x40000 chain-load (flash
    verifies, app never runs, LED blue->off), a charge-only USB-A->C adapter
    (device electrically absent, no ENUM STALLED), and hub hot-plug not
    detected when other devices on the hub are already live.
    - Flash section: first-time setup callout — flash --stage1 --stage2 with
    an explicit --firmware (bare --stage2 defaults to the device build).
    - New Field Troubleshooting section: WS2812 LED decoder + observed
    signatures, USB-C adapter gotcha, hub plug-order rules and supervisor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
2026-07-12 a2mega fw: WiFi diagnostic instruments + investigation ledger
    CLI additions from the WiFi performance investigation: 'net' (assoc/
    RSSI/IP/TX-power/power-save readback + RX frame and unicast counters +
    disconnect counter with last 802.11 reason code), 'wifitest on|off'
    (suspend/resume disk+menu tasks to A/B the board's own workload),
    'wifiproto bg|bgn' (drop/restore 802.11n rates).
    Findings so far (full ledger in boards/a2mega/TODO.md): inbound frames
    arrive at the radio promptly; the pathology is bimodal fly-or-wait
    latency (3-11ms floor, 0.5-2.5s typical) surviving every client-side
    elimination — power save, n-rates, 11k/v, workload (2x contributor,
    not the core), IIgs RFI. Remaining su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
2026-07-12 a2mega: WiFi verdict — RF path, not config; hotspot A/B closed it
    The latency/loss pathology reproduced identically on two UniFi SSIDs
    (all experimental toggles reverted to stock) and WORSE on an iPhone
    hotspot — different AP vendor, channel, and placement. Every client
    knob was eliminated with instruments (PS_NONE verified, bg vs bgn,
    11k/v absent, workload quiesce = 2x not core, stable association,
    inbound frames delivered promptly). Conclusion: the ESP32-S3-MINI PCB
    antenna in the a2mega's board environment carries management-rate
    traffic but not sustained data. Hardware mitigations listed in TODO
    (-1U variant with external antenna, placement audit); functional
    ceiling accepted for no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
2026-07-12 a2mega fw: WiFi takeover A/B (diagnostic state) — verdict reopened
    The RF-path conclusion is RETRACTED: with the wifi_bridge RX-callback
    takeover disabled, the board sustained 9ms avg / 0% loss — through the
    FAR UniFi AP at RSSI -83 — proving the module's radio is healthy. But
    the same build through the NEAR AP was sick again, so the takeover
    experiment is confounded with AP selection; every bad measurement in
    two days of data is consistent with the near AP being the problem.
    This commit intentionally ships with the takeover DISABLED (clearly
    marked in wifi_bridge.c): the W5100/Uthernet WiFi bridge is inert;
    FTP and future net services work. Next session: 2x2 experiment
    {takeover on/o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
    [wifi_bridge.c]
2026-07-12 a2mega fw: WiFi 2x2 verdict — takeover exonerated, bridge re-enabled
    Dedicated non-UniFi 2.4GHz AP at -33 dBm, all four cells measured:
    takeover on/off statistically identical (0% loss, ~150-280ms mean,
    ~12KB/s FTP both ways) — the wifi_bridge RX-callback takeover is NOT
    the pathology and ships re-enabled (W5100 bridge functional). The
    UniFi near-AP adds genuine loss/latency on top (its investigation is
    network-side). Residual bistable latency (~200ms common mode vs a
    proven 3-9ms mode) survives every client-side elimination — parked
    with next-step tooling listed in TODO. IIgs power and disk/menu
    workload also exonerated on the clean AP.
2026-07-13 a2mega: bring up FPGA-fabric USB gamepad — four stacked root causes
    The usb_hid_host core never enumerated any device. Live-debugged on
    hardware with new OSPI debug regs; four independent defects, all fixed:
    1. Empty microcode ROM in every build: $readmemh resolves against
    GowinSynthesis's working directory, so the UKP ROM silently zero-
    filled (EX3988 warned, buried). Microcode now inlined via generated
    usb_hid_host_rom_init.vh `include (resolved relative to the RTL
    file). ukp.s + asukp.py vendored next to it — regenerate with
    `python3 asukp.py ukp.s`.
    2. D+/D- swapped in the .cst: pins came from the Sipeed dock reference
    (dp=H13/dm=G13), but the a2mega carrier route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
    [asukp.py, esp32_ospi_connector.sv, top.sv, usb_hid_host.v, usb_hid_host_rom.v]
2026-07-13 a2mega fw: deferred wrap in fpga_screen — menu title no longer scrolled away
    The a2mega OSD console added real scroll-on-newline (the BL616 original
    wrapped to top, no scroll), which broke menu.c's implicit assumption
    that painting a full 40-char bottom row is side-effect-free: the last
    character of row 23 wrapped, newlined past the bottom, and scroll_up()
    shifted the whole page — eating the title bar on every repaint (the
    title was only ever visible as a flash mid-paint).
    Fix: VT100-style pending wrap. Filling the last column arms a flag;
    the newline/scroll fires only when the NEXT printable character
    arrives. goto/home/clear disarm it. Bottom-right cell is now writable;
    console log sc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
    [fpga_screen.c]
2026-07-13 a2mega: DDR3 reset sequencer + calibration watchdog + telemetry
    The DDR3 IP's rst_n was tied high: calibration was a single unsequenced
    shot racing PLL lock at configuration time, and a miss was permanent
    (no retry in the IP) — the intermittent dead-DDR3 cold boots (seen on
    hardware with power stable ~30 s before config: a controller-reset
    race, not supply ramp).
    Fabric: sequencer on the always-on 50 MHz crystal holds rst_n through
    PLL lock + 1 ms settle, releases, then a 100 ms watchdog on
    init_calib_complete pulses reset (100 us) and retries indefinitely.
    Saturating retry counter + state in new debug regs 0x23/0x24.
    Verified on a cold flash boot: calibrated, retries=0, seq parked in
    wat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
    [a2fpga_esp32.ino, esp32_ospi_connector.sv, top.sv]
2026-07-13 a2mega: wire DDR3 pll_stop via mDRP — root cause of marginal calibration
    IPUG281 §4.4.4: on GW5A(T) the DDR3 IP's pll_stop output must actually
    stop memory_clk during init — Sync_mod stops the clock, releases its
    dividers, restarts it to phase-align the /4 domains. The GW5AT-60 PLLA
    has no enclk, so pll_stop acts through the PLL's mDRP port via
    pll_mDRP_intf. Ours was dangling AND the generated pll_ddr3 wrapper
    routed the mDRP bus through PLL_INIT permanently (static bypass mux),
    so wiring the adapter alone would have done nothing.
    Cold boots worked by GSR luck (everything releases near-aligned);
    marginal alignments were the intermittent dead-DDR3 boots, and any
    rst_n re-init was guara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
2026-07-19 a2n20v2-Enhanced: bus-capture debug toolkit, boot-timeline, robust 0x2E; excise CardROM
    Debug/robustness keeper set from the July 2026 Language-Card investigation
    (root cause proved to be tester-specific host hardware; these tools and fixes
    are what the hunt produced and validated on hardware).
    Gateware:
    - a2bus_event_fifo.sv: CTRL byte now captures the full control-line set
    ([7]rw [6]/INH [5]/RES [4]/IRQ [3]/NMI [2]/DMA [1]/RDY [0]m2sel); rolling
    capture (keeps last 512 cycles; count-when-full readable via full flag);
    hardware trigger (freeze on addr match, addr^mask); oneshot mode (freeze
    when full -> holds the FIRST 512 cycles after /RES release).
    - bl616_spi_connector.sv: trigge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
    [a2bus_event_fifo.sv, bl616_spi_connector.sv, boot_timeline.c, boot_timeline.h, disk.c, main.c, telnetd.c, top.sv]
2026-07-19 a2n20v2-Enhanced: startup sequencing -- /RES releases on slot-map strobe, bridge on native timer
    RESET CONTRACT (ed): Apple /RES releases only after the slot config has been
    loaded and the virtual cards know which slots they are in. Previously the
    release was gated on storage mounts (7-15 s in reset); storage never needed
    the CPU held -- the Disk II volume_ready gate already makes the boot ROM wait
    natively -- but the slot map DID, and it was programmed late. Now:
    Gateware (bl616_spi_connector.sv):
    - slots_configured_r latches on the reg 0x6B slotmaker-reconfig strobe;
    reset_hold clears on it (or legacy 0x2E, MCU-absent 3 s, 15 s backstop).
    - Bridge-start (`ready`) now also asserts at a ~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
    [bl616_spi_connector.sv, boot_timeline.c, boot_timeline.h, disk.c, main.c]
2026-07-19 sdram: fb storage-port hardening -- per-client read latch, drive_ii fetch gate
    Storage-port-exclusive subset of the #48 audit fixes, split out after hardware
    verification showed #48's mem_port_cdc request-path rewrite caused display
    artifacts (the CDC module is shared with the video/framebuffer crossings; that
    fix returns to design with a latency budget). These two changes touch ONLY the
    arbitrated storage port (Disk II / HDD / MCU) and cannot interact with video:
    - mem_port_arb.sv: each client gets a private read-data register latched only
    on its own read completion (previously all clients shared the controller's q,
    so any client's completing read replaced the word while drive_ii was s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
    [drive_ii.sv, mem_port_arb.sv]
2026-07-20 a2n20v2-Enhanced: combined artifact rebuild after #49/#50/#51 merges
    Each merged PR carried artifacts built without the other PRs' gateware; this
    regenerates all committed binaries from the merged tree so main's artifacts
    match main's source (union verified: debug toolkit + startup sequencing +
    storage-port hardening all present).
    PROVENANCE:
    base tip : 47a42bfe (merge of #51)
    toolchain : Gowin gw_sh (tools/build.sh, clean impl dirs, zero unrouted
    nets) + T-Head xuantie riscv64 / bouffalo_sdk v2.3.27
    timing : all variants 0 setup / 0 hold, TNS=0, Fmax >= constraint
    fb : spi 133.2/4, sdram 114.9/108, logic 64.0/54, pixel 42.5/27
    classic : spi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
2026-10-31 a2n20v2-Enhanced: fix false FPGA-ready on cold boot (18.5 s boot, slot map never applied)
    fpga_spi_wait_ready() trusted status reg 0x06 bits 7+6 alone. On a cold
    power-up the BL616 reaches main() at ~0.6 s but the FPGA is still loading
    its bitstream (~2.9 s: 7.26 Mbit at the 2.5 MHz MSPI rate); MISO floats high
    so every read returns 0xFF, which satisfies both bits. The MCU declared the
    FPGA ready at 632 ms and every early write -- 0x30 bus-ready, the slot map,
    the 0x6B strobe, the 0x2E release -- went into an unconfigured FPGA.
    Consequences observed on hardware:
    - Apple /RES released only on the 15 s gateware backstop: ~18.5 s from the
    power switch to the beep.
    - The saved slot map never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
2026-10-31 memory: gate INTC8ROM to IIe/IIgs so a ][+ $C3xx access can't block expansion ROMs
    INTC8ROM is a IIe MMU feature ($C3xx with SLOTC3ROM=0 maps the internal
    80-column firmware over $C800-$CFFF). A ][+ has no SLOTC3ROM switch, so it
    reads 0 and every $C3xx access set INTC8ROM, which gates io_strobe for every
    emulated card in slotmaker until the next $CFFF. A slot-3 card that executes
    from $C8xx (e.g. a Videx 80-column card) keeps re-arming it and can never
    see its own expansion ROM.
    Add runtime ][+ vs IIe/IIgs detection (latched on any $C00x soft-switch
    write, which IIe/IIgs software issues almost immediately and a ][+ ignores)
    and set INTC8ROM only when detected. A false positive on a ][+ jus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
2026-10-31 ssc: expansion-ROM ownership follows the configured slot; phi0-qualify $CFFF
    Three problems in the SSC's $C800-$CFFF ownership (C8S2):
    1. Hard-coded to slot 2. C8S2 was set on any $C2xx access, ignoring the
    slot the card is actually configured into. Since the OSD/slotmaker can
    place the SSC in any slot, an SSC elsewhere never mapped its expansion
    ROM (PR#n / IN#n would run into open bus). Now set by card_io_sel --
    slotmaker's decode of the card's own slot, already gated by INTCXROM and
    phi0 -- and the owning slot is latched.
    2. $CFFF clear not phi0-qualified. Address-bus transients outside the valid
    phase could spuriously clear C8S2 mid-execution. (Brent Rector's fork,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
2026-10-31 hdmi: strict-sink compatibility (Samsung et al.) + upstream control-period fix
    Some HDMI sinks -- Samsung TVs and strict monitors (e.g. Ingnok portable
    displays) -- show no picture from A2FPGA. Two sources, both ported from
    Brent Rector's fork (BrentRector/a2fpga_core):
    1. Upstream hdl-util/hdmi PR #44 (merged 2023-08-20, "enforce hdmi 12px
    minimum control period during video and data-island preambles"; fixes
    upstream #43). Ported verbatim (hdmi.sv only; upstream's testbench
    changes are not carried here). Brent's commit dd7617d.
    2. Packet/InfoFrame spec conformance (Brent's commit 35ae550):
    - AVI InfoFrame: PICTURE_ASPECT_RATIO matching the VIC (all boards use
    VIC 2 -> 4:3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
2026-10-31 video: frame-locked text FLASH (~1.875 Hz) instead of a free-running clock counter
    The text FLASH attribute (and so the Applesoft/Monitor cursor) was driven by
    bit 22 of a free-running counter. Its rate therefore depended on whichever
    clock the generator ran on:
    - apple_video (legacy, clk_pixel 27 MHz): ~3.2 Hz
    - apple_video_gen (pixel-stream, clk_logic 54 MHz -- a2n20v2-Enhanced _fb,
    a2n20v2-GS, a2mega): ~6.4 Hz
    A real Apple II flashes at roughly 1.9 Hz, so the cursor blinked noticeably
    fast everywhere, and twice as fast again on the pixel-stream boards.
    Count video frames instead and toggle every 16 (32-frame period, ~1.875 Hz at
    60 Hz): pixel_stream.vsync in apple_video_gen, the scre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
2026-11-01 hdd: when no image is mounted, resume the autostart slot scan instead of jmp $C500
    The ProDOS HDD boot ROM fell back to a hard-coded jmp $C500 when no image
    was mounted (or button 0 was held). With anything other than a Disk II in
    slot 5 (e.g. the Disk II in its usual slot 6) that dropped the Apple into
    the Monitor at $C502/$C51E.
    Now it resumes the Monitor's own autostart scan (SLOOP, $FABA) at the slot
    below this card, as if this card weren't bootable: the next bootable card
    down boots, or the machine drops to BASIC. SLOOP sits at $FABA in both the
    ][+ autostart and IIe ROMs (checked against ROM images). A ROM without that
    loop (the original ][ Monitor, or anything else) goes to BASIC at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
2026-11-11 hdd: only honor the skip-HDD key on a //e-class machine
    The boot ROM's skip key reads $C061. On the IIe/IIc/IIgs that is
    Open-Apple, which reads clear when up. On a ][/][+ it is game-port
    pushbutton 0, which floats HIGH with nothing plugged in, so the skip fired
    on every boot and a ][+ without a joystick never booted the HDD (it fell
    through to the next slot). Confirmed on hardware: PEEK(49249) on a ][+
    with an empty game port reads 160/160/192 (bit 7 set).
    Gate the check on the Monitor ID byte $FBB3 ($06 = IIe/IIc/IIgs, $EA =
    ][+, $38 = original ][; verified in the ROM images). Uses the ROM's last
    7 free bytes. hdd_rom.hex reassembled with acme.
